dhirajbennadi/RemoteInterfacingWith8051/Report/honor code.jpeg

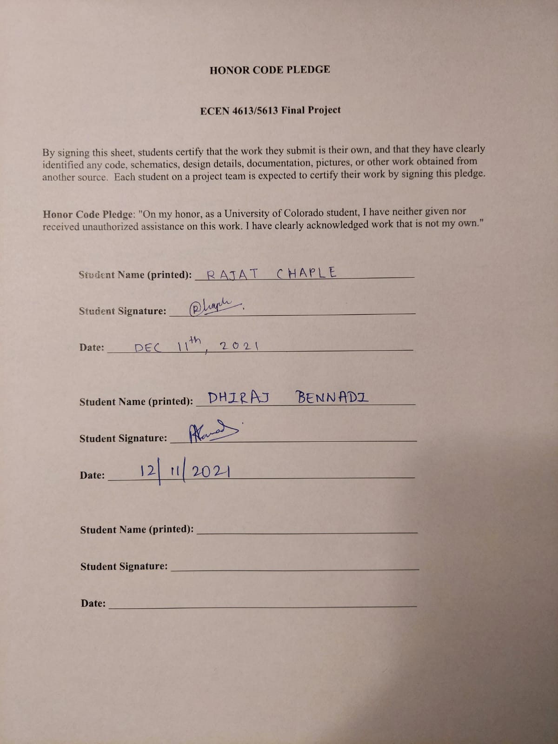
Report/honor code.jpeg
