dhirajbennadi/RemoteInterfacingWith8051/Pictures/20211206_050803.jpg

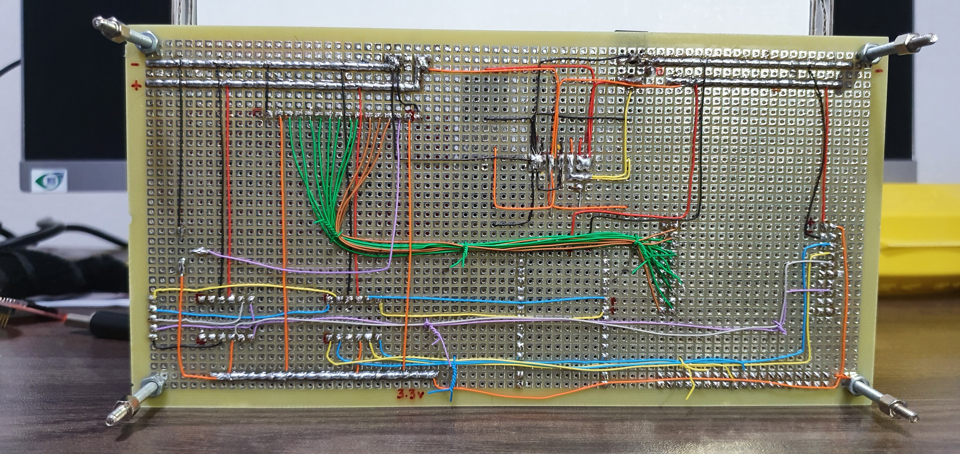
Pictures/20211206_050803.jpg
