dhirajbennadi/RemoteInterfacingWith8051/Presentations/F21_Bennadi_Chaple_Remote_Interfacing_with_8051_PDR.pptx

ESD 5613 : Final Project
(Fall 2021)
Remote Interfacing with 8051
        - Dhiraj Bennadi
        - Rajat Chaple

Notes: Introduction
Brief project description :

With current circumstances of COVID like situations, can we eliminate the need of physical access to a hardware. So one can connect to a 8051 based hardware kit remotely and perform operations like programming, memory accesses, gpio reads, etc.
In short, one can do almost all operations remotely which we have covered in labs.

## Slide 2

Block Diagram

Power Supply

8051 (uC)

UART

GPIO

Target system

Microcontroller : Tiva C launchpad with EK-TM4C123GXL

New

Memory
Backup

ESP8266

New

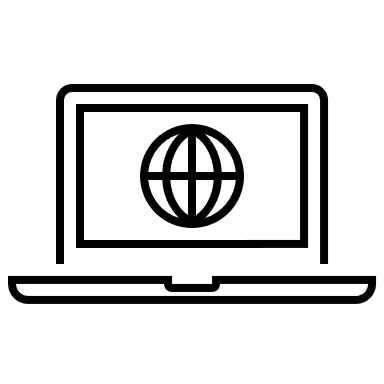
[picture p16: figure]
Internet outline

Hash key/ CRC generation

LCD Interface

SPI

New

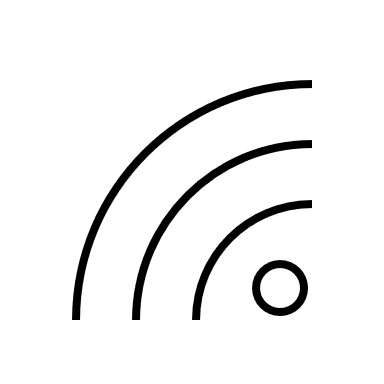
[picture p17: figure]
Wireless outline
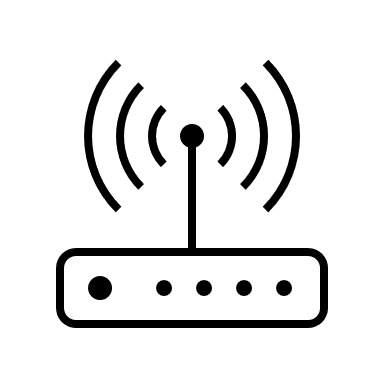
[picture p18: figure]
Wireless router outline

uController

UART

Hash check

Notes: Talk about the host
1. Utility to flash and monitor target system’s memory also monitor gpio
2. User woud have tools to compile build and generate a hex file which is then supposed to be transferred to the target system
3. For the verification of transferred hex file. Hash key wold be generated at the host end.

Target
1. Consists of 8051, Memory –(to store hex file at targets end to verify that transfer is complete (OTA update).
2. ESP8266 would be used to have communication with the host. Data would
2. Whats new (hardware)
-power supply. ESP8266 consumption
-Memory card storage
-Target uController
-ESP8266

## Slide 3

Software elements

- New elements
  - Hashing
  - SPI interface
  - Socket programming
  - GUI (optional)
- Existing elements
  - UART interface
  - GPIO

Hardware elements

New elements
Power circuit
ESP8266 (or alternative)
External memory (e.g. SD card)
PCB design and fabrication
Existing elements
8051 uController
LCD (optional)
Keypad (optional)

Notes: Software elements

## Slide 4

Key milestones

- Designing Power circuit
- PCB Layout
- Communication between ESP8266 and 8051
- Communication between Host PC to ESP8266
- Communication between ESP8266 to External memory

Notes: PCB Design and Layout is critical components as its dependent on third party supplier.
mode of communication : UART, socket comm, SPI

## Slide 5

Project deliverables

Task | Expected Due Date | Assigned to
Power Circuit design | 31st October 2021 | Rajat Chaple
Ordering of parts | 4th November | Dhiraj Bennadi
Schematic | 9th November | Both
PCB Layout | 13th November | Rajat Chaple
Interfacing UART (ESP8266 to 8051) | 14th November | Dhiraj Bennadi
Interfacing SPI (ESP8266 to Memory card) | 21st November | Both
Socket communication | 26th November | Rajat Chaple
Hashing / CRC check | 27th November | Dhiraj Bennadi
Unit Testing | 30th November | Both
System Testing | 3rd December | Both
Report | 5th December | Both

Notes: Considering time constrain we will not walk through the entire timeline
PCB Layout ready by 13th November
By 26th November our communication part would be ready. It constists of UART SPI and socket
We are focusing on impleneting Hash to verify data validation. Also, checksum would be calculated and verified at the target
We have also kept dedicated time slot for testing which would be both unit testing, functional system and Integration testing.


Can be extende to have multiple such devices powered on and users can connect and utilize one of the available boards

## Slide 6

Fall-back plan : Automated Wire spooler

Power Supply

microcontroller

UART

GPIO

Actuator
(motor &
cutter)

New

Memory
Backup

LCD Interface

New

New

NRF Device

Notes: Backup plan:
Its like automatic wire dispenser of required length
By 20th November we would have clear idea at what stage project is. PCB and ESP8266 configuration.

## Thank you…
