dhirajbennadi/RemoteInterfacingWith8051/Labs/Rajat/chaple_lab_1/lab_writeup/ESD 5613 Lab1 Submission report.pdf

## ESD 5613 Lab1 Submission

## (Rajat Chaple)

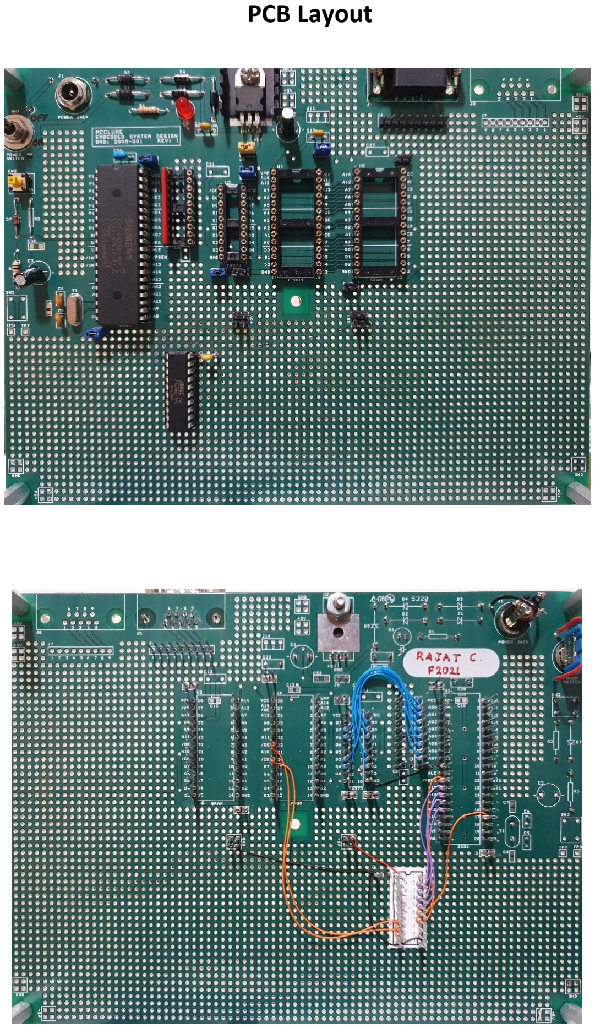
[picture p66: page 2]

PCB Layout

Part 1:

1) How many bytes of code space does your programmer require? Code size? 81 bytes____

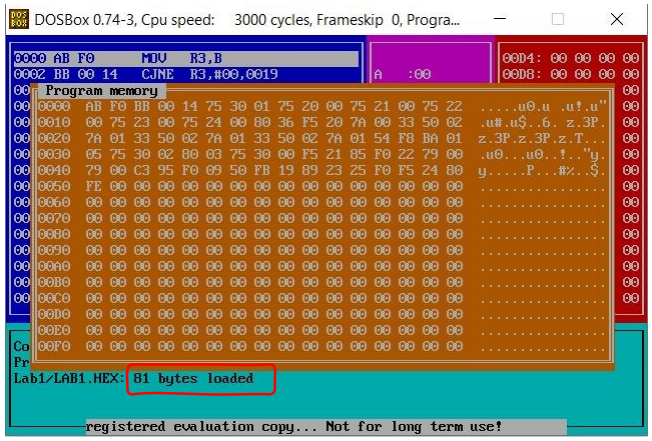
[picture p67: figure]

Another way to find out is sum up number of instruction bytes used by each instruction in a program.

2) How long did your program take to execute for X=0x10 and Y=0x0A? Assume an 11.0592 MHz clock and include the instructions executed from the beginning until you reach the ENDLOOP label. Show the TA your detailed calculations on the code listing during your signoff.

Execution Time? ______84.63 uSec________
Calculation :
Ans
= (Total oscillator cycles taken by all the instruction during execution sequence) * period 0f oscillator
= (936) * (1/11.0592) = 84.63 uSec
Calculation of 936 oscillator cycles is in lab_writeup/useful utilities/execution time.xlsx

Part 2:

Schematic is attached in schematics folder.

Part 3:

1. What voltage is present at the regulator input? Use a digital multimeter. ______7.8 V_____________

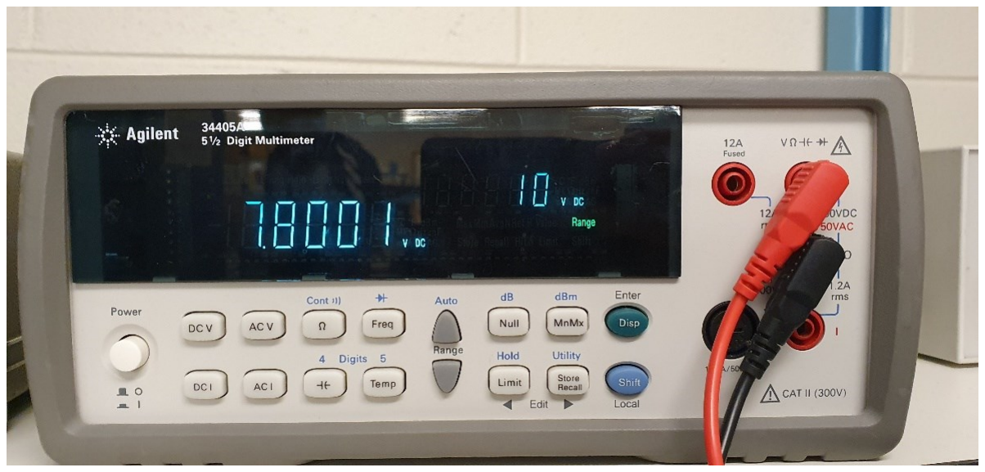
[picture p68: figure]

2. What voltage is present at the regulator output? Use a digital multimeter. ______4.99 V____________

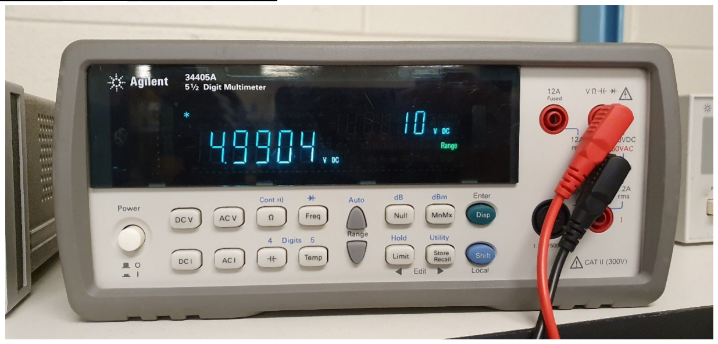
[picture p69: figure]
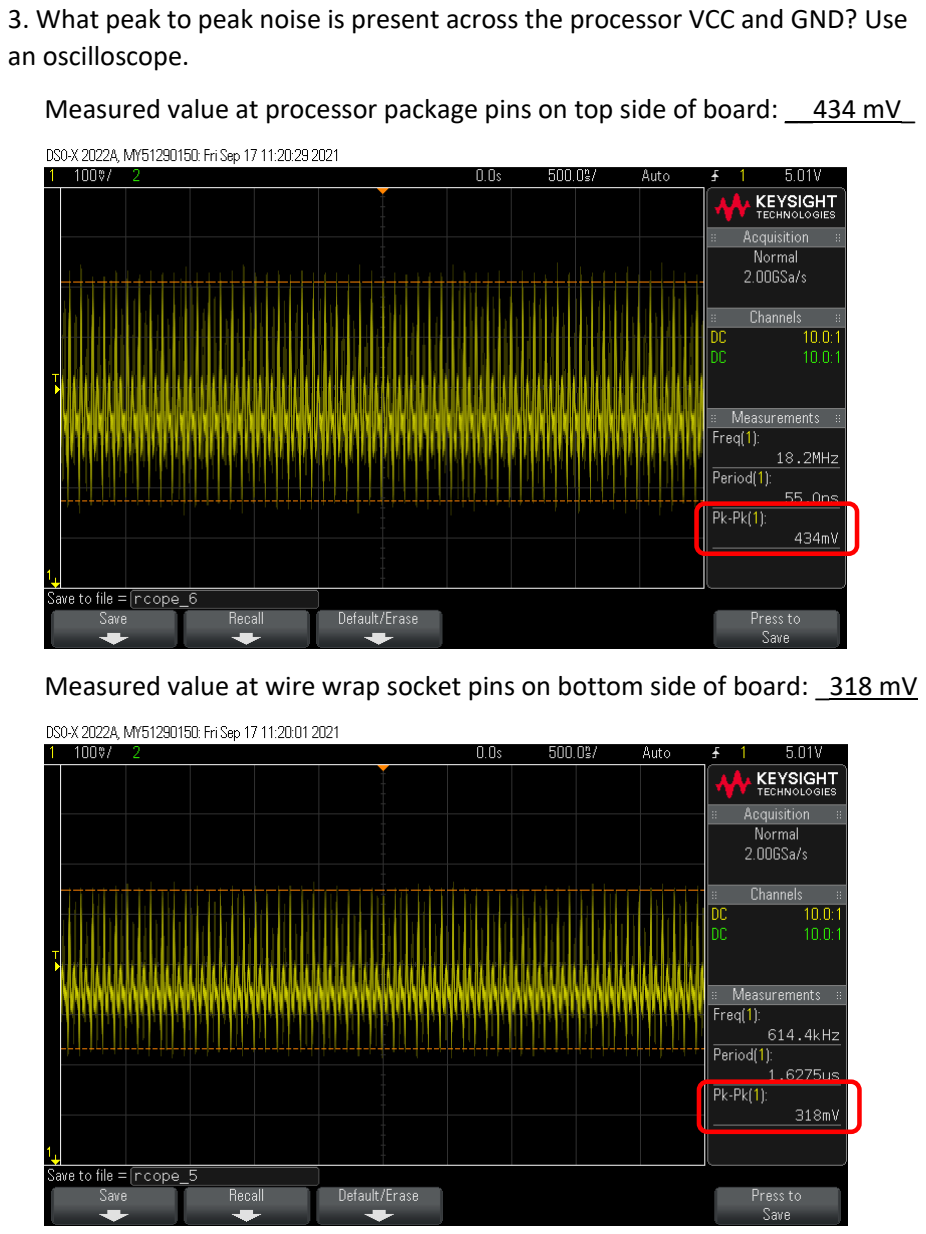
[picture p70: page 5]

3. What peak to peak noise is present across the processor VCC and GND? Use an oscilloscope.

Measured value at processor package pins on top side of board: __434 mV_

Measured value at wire wrap socket pins on bottom side of board: _318 mV

4. How long is the processor held in reset after the run-time reset pushbutton is released? Use an oscilloscope and try to measure the time between the release of the pushbutton and the time when noise from ALE is observed on the RST signal.

Measured value: ________121 mSec_____________

= 471ms – 350ms

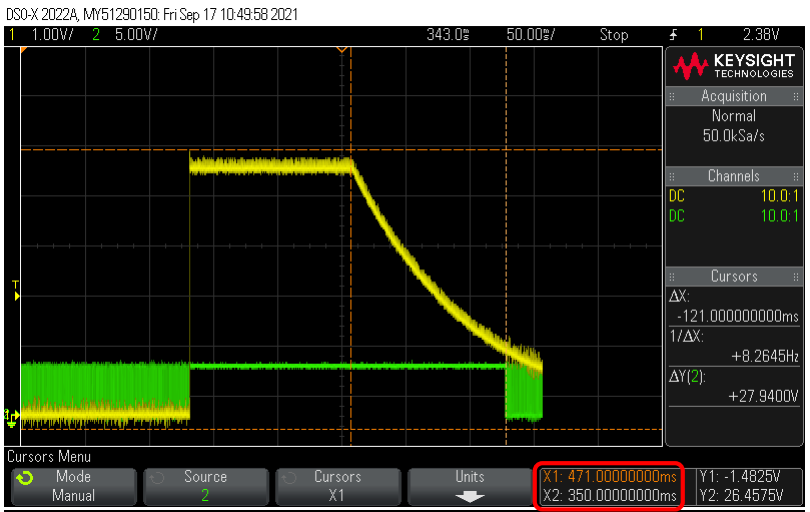
[picture p71: figure]

Submission sheet:

How much power is dissipated in the regulator, assuming a load current of 125mA? Assume that the regulator is drawing the max quiescent current shown in the data sheet (use the correct data sheet for the regulator you have on your board). Neatly show all your work.

Max quiescent current = 6mA

Power dissipated = (Vout – Vin)*(ILoad + IQ) = (7.8 – 4.99)*(0.125 * 0.006) calculated value = 368 mW

5. What frequency is present at the ALE pin? Use an oscilloscope. _________1.843 MHz____________

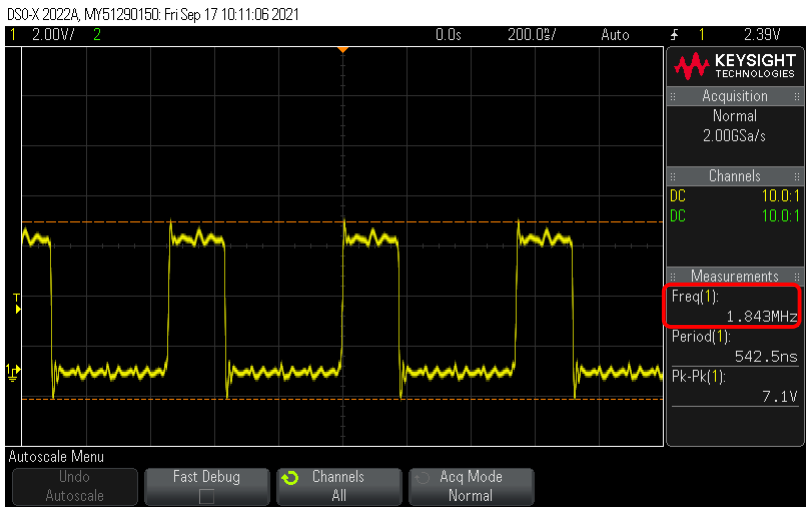
[picture p72: figure]

Learnings:

1) Designing a logic using SPLD: WinCUPL and WinSIM.
2) Using Emily52 to run assembly program.
3) Using LogicPort logic analyzer to verify SPLD logic.

/READ = /RD & /PSEN

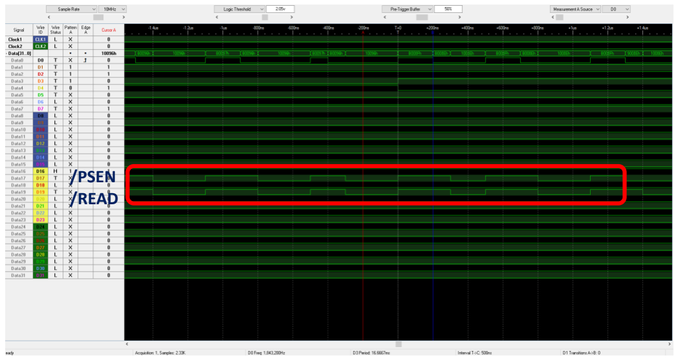
[picture p73: figure]
/PSEN /READ

/CSPERIPH = !(A15 & A14 & A13 & A12).

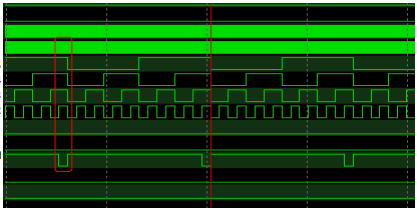
[picture p74: figure]

A15
A14
A13
A12

CSPERIPH

4) Wire wrapping technique

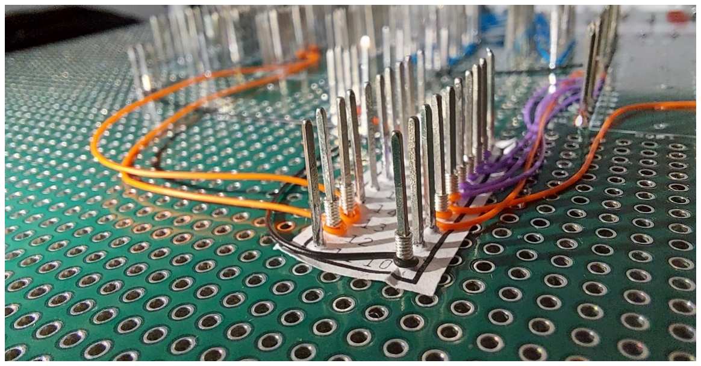
[picture p75: figure]

Note:
Supporting utilities and simulation videos are attached in lab_report folder

## Signoff / Submission sheets

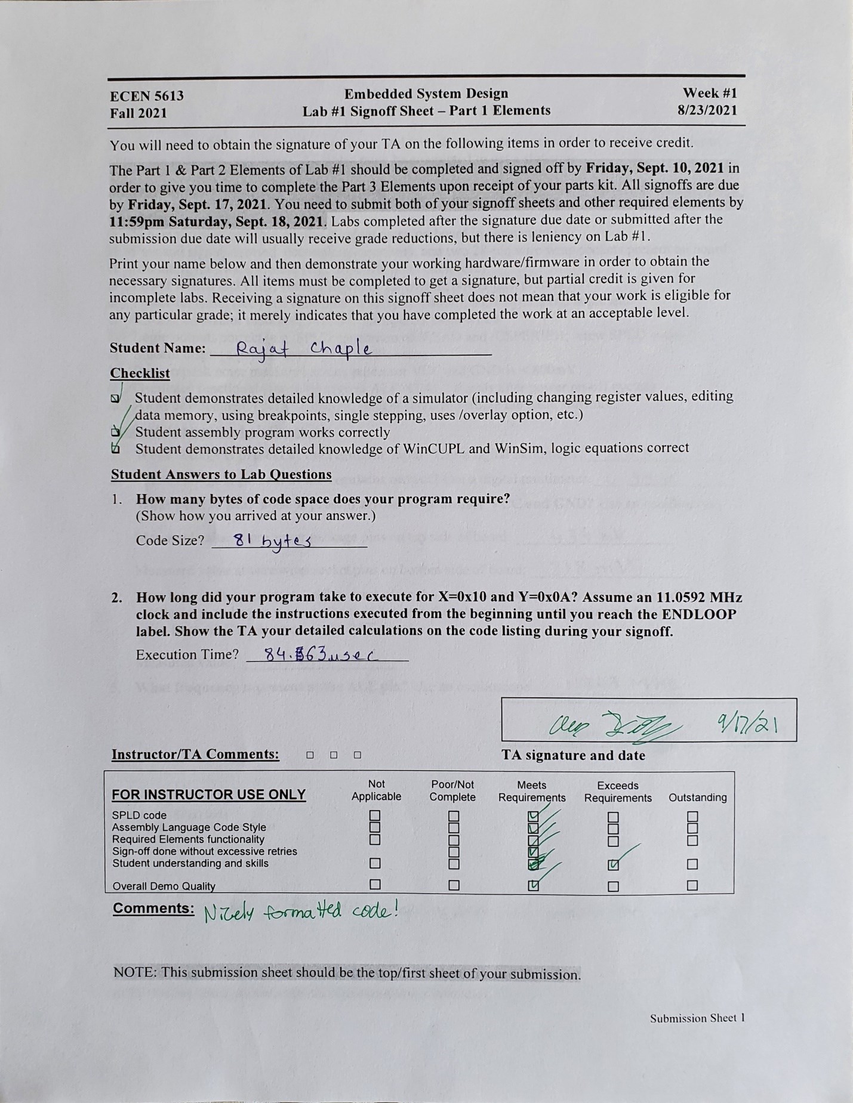
[picture p76: figure]

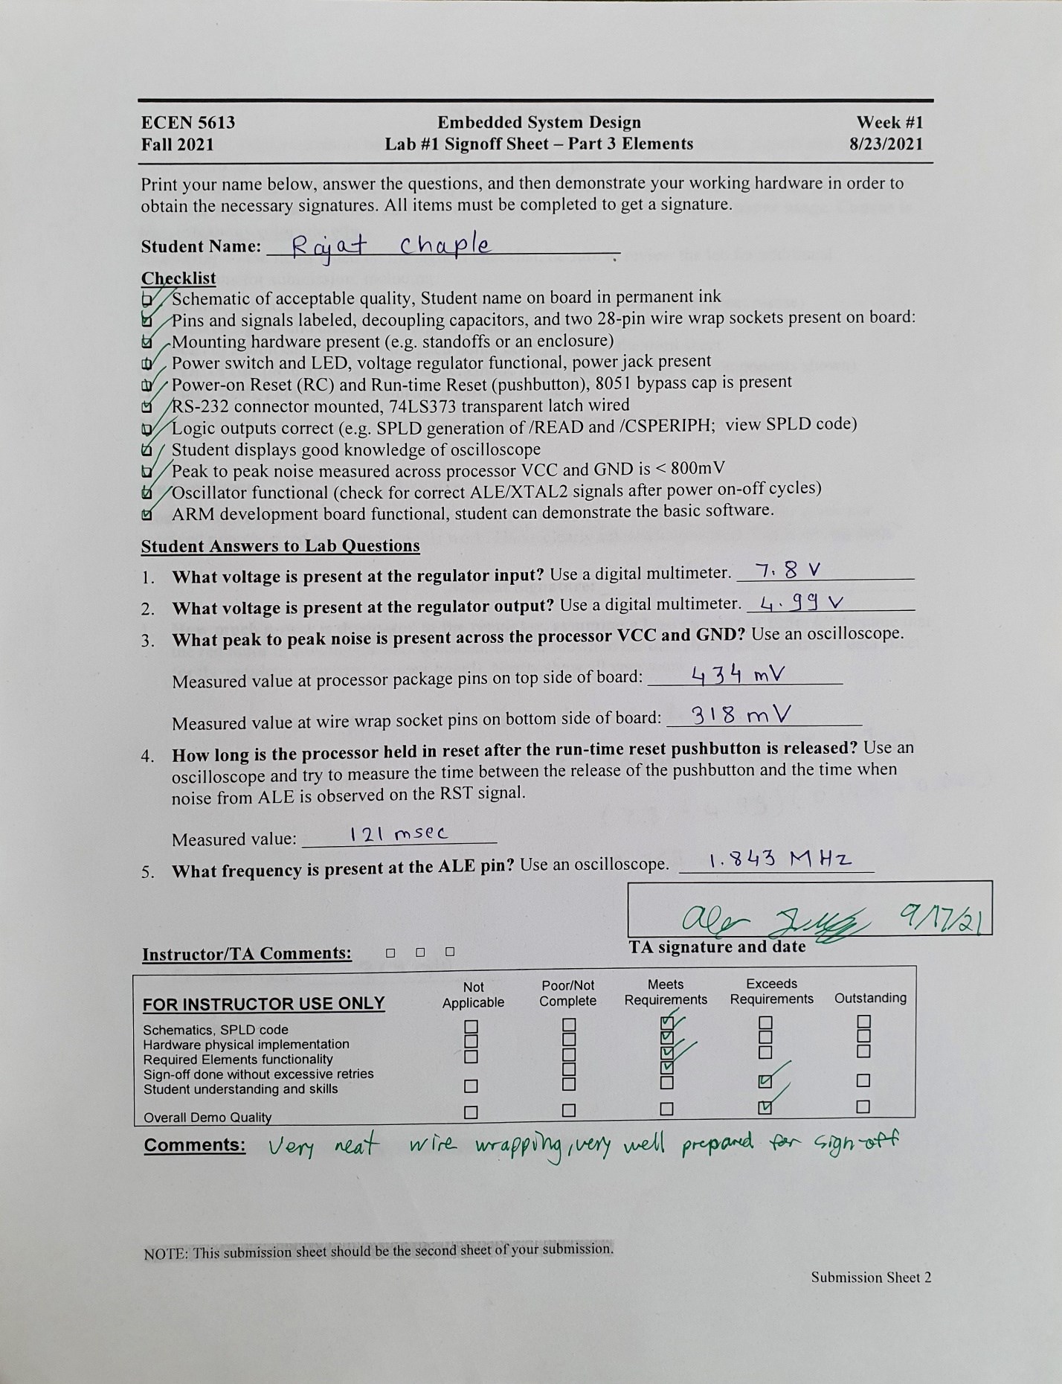
[picture p77: figure]

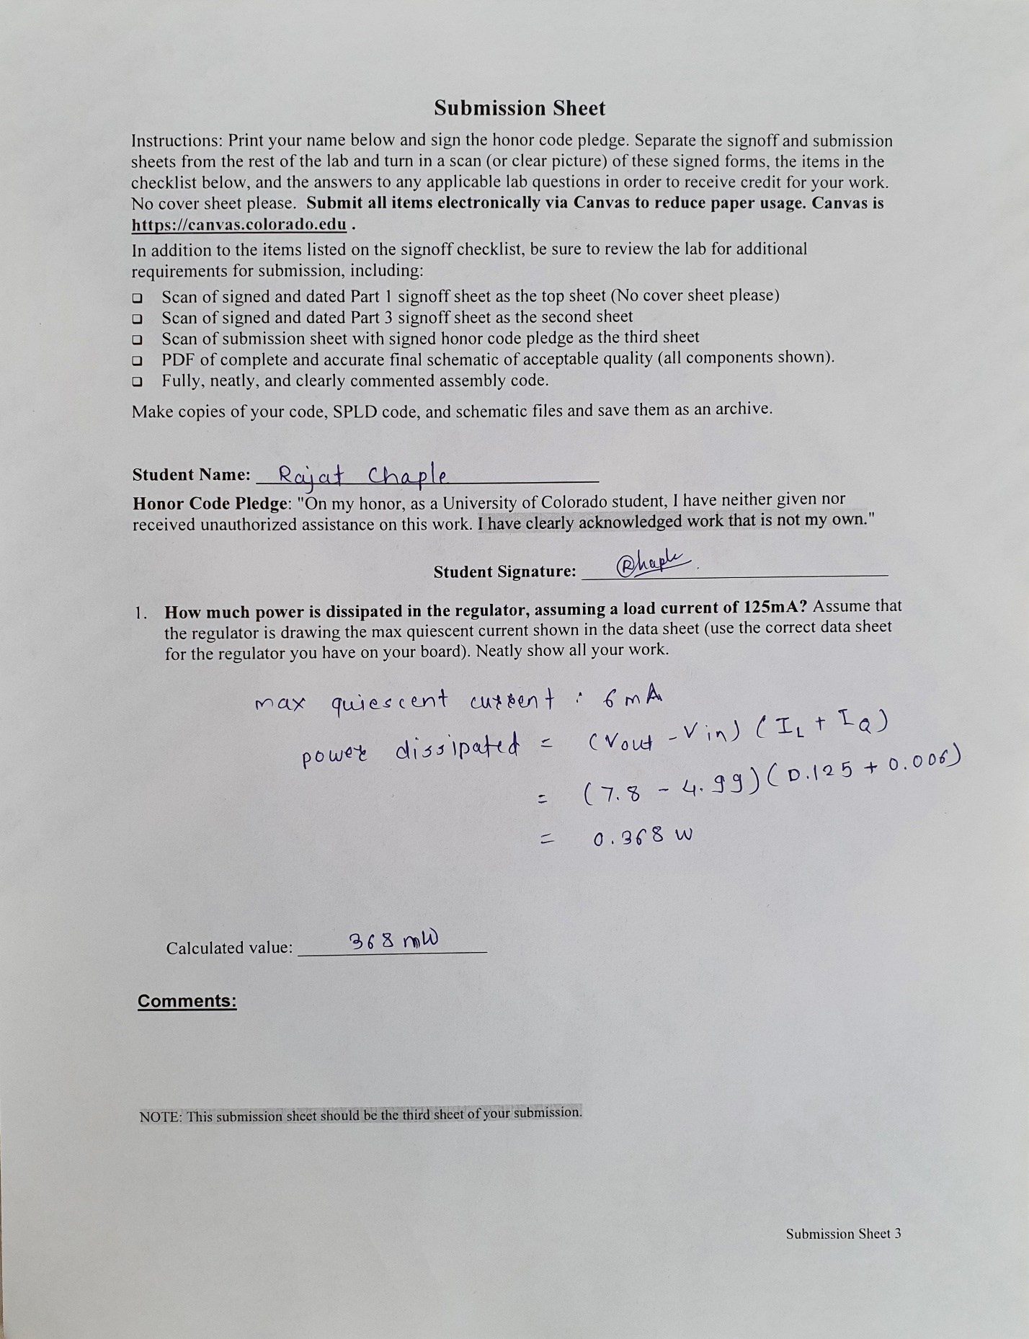
[picture p78: figure]
