dhirajbennadi/RemoteInterfacingWith8051/Labs/Rajat/chaple_lab_3/c_code_C51/esd_lab3_part3_buffers/obj/Release/uart.rst

                                      1 ;--------------------------------------------------------
                                      2 ; File Created by SDCC : free open source ANSI-C Compiler
                                      3 ; Version 3.9.0 #11195 (MINGW64)
                                      4 ;--------------------------------------------------------
                                      5 	.module uart
                                      6 	.optsdcc -mmcs51 --model-large
                                      7 	
                                      8 ;--------------------------------------------------------
                                      9 ; Public variables in this module
                                     10 ;--------------------------------------------------------
                                     11 	.globl _printf_tiny
                                     12 	.globl _printf
                                     13 	.globl _memset
                                     14 	.globl _strncat
                                     15 	.globl _strcat
                                     16 	.globl _free
                                     17 	.globl _malloc
                                     18 	.globl _atoi
                                     19 	.globl _main
                                     20 	.globl _CY
                                     21 	.globl _AC
                                     22 	.globl _F0
                                     23 	.globl _RS1
                                     24 	.globl _RS0
                                     25 	.globl _OV
                                     26 	.globl _F1
                                     27 	.globl _P
                                     28 	.globl _PS
                                     29 	.globl _PT1
                                     30 	.globl _PX1
                                     31 	.globl _PT0
                                     32 	.globl _PX0
                                     33 	.globl _RD
                                     34 	.globl _WR
                                     35 	.globl _T1
                                     36 	.globl _T0
                                     37 	.globl _INT1
                                     38 	.globl _INT0
                                     39 	.globl _TXD
                                     40 	.globl _RXD
                                     41 	.globl _P3_7
                                     42 	.globl _P3_6
                                     43 	.globl _P3_5
                                     44 	.globl _P3_4
                                     45 	.globl _P3_3
                                     46 	.globl _P3_2
                                     47 	.globl _P3_1
                                     48 	.globl _P3_0
                                     49 	.globl _EA
                                     50 	.globl _ES
                                     51 	.globl _ET1
                                     52 	.globl _EX1
                                     53 	.globl _ET0
                                     54 	.globl _EX0
                                     55 	.globl _P2_7
                                     56 	.globl _P2_6
                                     57 	.globl _P2_5
                                     58 	.globl _P2_4
                                     59 	.globl _P2_3
                                     60 	.globl _P2_2
                                     61 	.globl _P2_1
                                     62 	.globl _P2_0
                                     63 	.globl _SM0
                                     64 	.globl _SM1
                                     65 	.globl _SM2
                                     66 	.globl _REN
                                     67 	.globl _TB8
                                     68 	.globl _RB8
                                     69 	.globl _TI
                                     70 	.globl _RI
                                     71 	.globl _P1_7
                                     72 	.globl _P1_6
                                     73 	.globl _P1_5
                                     74 	.globl _P1_4
                                     75 	.globl _P1_3
                                     76 	.globl _P1_2
                                     77 	.globl _P1_1
                                     78 	.globl _P1_0
                                     79 	.globl _TF1
                                     80 	.globl _TR1
                                     81 	.globl _TF0
                                     82 	.globl _TR0
                                     83 	.globl _IE1
                                     84 	.globl _IT1
                                     85 	.globl _IE0
                                     86 	.globl _IT0
                                     87 	.globl _P0_7
                                     88 	.globl _P0_6
                                     89 	.globl _P0_5
                                     90 	.globl _P0_4
                                     91 	.globl _P0_3
                                     92 	.globl _P0_2
                                     93 	.globl _P0_1
                                     94 	.globl _P0_0
                                     95 	.globl _B
                                     96 	.globl _ACC
                                     97 	.globl _PSW
                                     98 	.globl _IP
                                     99 	.globl _P3
                                    100 	.globl _IE
                                    101 	.globl _P2
                                    102 	.globl _SBUF
                                    103 	.globl _SCON
                                    104 	.globl _P1
                                    105 	.globl _TH1
                                    106 	.globl _TH0
                                    107 	.globl _TL1
                                    108 	.globl _TL0
                                    109 	.globl _TMOD
                                    110 	.globl _TCON
                                    111 	.globl _PCON
                                    112 	.globl _DPH
                                    113 	.globl _DPL
                                    114 	.globl _SP
                                    115 	.globl _P0
                                    116 	.globl _total_malloced_data
                                    117 	.globl _buf_number
                                    118 	.globl _uint_to_hexstr_PARM_4
                                    119 	.globl _uint_to_hexstr_PARM_3
                                    120 	.globl _uint_to_hexstr_PARM_2
                                    121 	.globl _hexdump_PARM_2
                                    122 	.globl _command_PARM_2
                                    123 	.globl _uart_init
                                    124 	.globl _echo
                                    125 	.globl _command
                                    126 	.globl _putchar
                                    127 	.globl _getchar
                                    128 	.globl _putstr
                                    129 	.globl _accept_number_from_user
                                    130 	.globl _print_buffers
                                    131 	.globl _hexdump
                                    132 	.globl _uint_to_hexstr
                                    133 ;--------------------------------------------------------
                                    134 ; special function registers
                                    135 ;--------------------------------------------------------
                                    136 	.area RSEG    (ABS,DATA)
      000000                        137 	.org 0x0000
                           000080   138 _P0	=	0x0080
                           000081   139 _SP	=	0x0081
                           000082   140 _DPL	=	0x0082
                           000083   141 _DPH	=	0x0083
                           000087   142 _PCON	=	0x0087
                           000088   143 _TCON	=	0x0088
                           000089   144 _TMOD	=	0x0089
                           00008A   145 _TL0	=	0x008a
                           00008B   146 _TL1	=	0x008b
                           00008C   147 _TH0	=	0x008c
                           00008D   148 _TH1	=	0x008d
                           000090   149 _P1	=	0x0090
                           000098   150 _SCON	=	0x0098
                           000099   151 _SBUF	=	0x0099
                           0000A0   152 _P2	=	0x00a0
                           0000A8   153 _IE	=	0x00a8
                           0000B0   154 _P3	=	0x00b0
                           0000B8   155 _IP	=	0x00b8
                           0000D0   156 _PSW	=	0x00d0
                           0000E0   157 _ACC	=	0x00e0
                           0000F0   158 _B	=	0x00f0
                                    159 ;--------------------------------------------------------
                                    160 ; special function bits
                                    161 ;--------------------------------------------------------
                                    162 	.area RSEG    (ABS,DATA)
      000000                        163 	.org 0x0000
                           000080   164 _P0_0	=	0x0080
                           000081   165 _P0_1	=	0x0081
                           000082   166 _P0_2	=	0x0082
                           000083   167 _P0_3	=	0x0083
                           000084   168 _P0_4	=	0x0084
                           000085   169 _P0_5	=	0x0085
                           000086   170 _P0_6	=	0x0086
                           000087   171 _P0_7	=	0x0087
                           000088   172 _IT0	=	0x0088
                           000089   173 _IE0	=	0x0089
                           00008A   174 _IT1	=	0x008a
                           00008B   175 _IE1	=	0x008b
                           00008C   176 _TR0	=	0x008c
                           00008D   177 _TF0	=	0x008d
                           00008E   178 _TR1	=	0x008e
                           00008F   179 _TF1	=	0x008f
                           000090   180 _P1_0	=	0x0090
                           000091   181 _P1_1	=	0x0091
                           000092   182 _P1_2	=	0x0092
                           000093   183 _P1_3	=	0x0093
                           000094   184 _P1_4	=	0x0094
                           000095   185 _P1_5	=	0x0095
                           000096   186 _P1_6	=	0x0096
                           000097   187 _P1_7	=	0x0097
                           000098   188 _RI	=	0x0098
                           000099   189 _TI	=	0x0099
                           00009A   190 _RB8	=	0x009a
                           00009B   191 _TB8	=	0x009b
                           00009C   192 _REN	=	0x009c
                           00009D   193 _SM2	=	0x009d
                           00009E   194 _SM1	=	0x009e
                           00009F   195 _SM0	=	0x009f
                           0000A0   196 _P2_0	=	0x00a0
                           0000A1   197 _P2_1	=	0x00a1
                           0000A2   198 _P2_2	=	0x00a2
                           0000A3   199 _P2_3	=	0x00a3
                           0000A4   200 _P2_4	=	0x00a4
                           0000A5   201 _P2_5	=	0x00a5
                           0000A6   202 _P2_6	=	0x00a6
                           0000A7   203 _P2_7	=	0x00a7
                           0000A8   204 _EX0	=	0x00a8
                           0000A9   205 _ET0	=	0x00a9
                           0000AA   206 _EX1	=	0x00aa
                           0000AB   207 _ET1	=	0x00ab
                           0000AC   208 _ES	=	0x00ac
                           0000AF   209 _EA	=	0x00af
                           0000B0   210 _P3_0	=	0x00b0
                           0000B1   211 _P3_1	=	0x00b1
                           0000B2   212 _P3_2	=	0x00b2
                           0000B3   213 _P3_3	=	0x00b3
                           0000B4   214 _P3_4	=	0x00b4
                           0000B5   215 _P3_5	=	0x00b5
                           0000B6   216 _P3_6	=	0x00b6
                           0000B7   217 _P3_7	=	0x00b7
                           0000B0   218 _RXD	=	0x00b0
                           0000B1   219 _TXD	=	0x00b1
                           0000B2   220 _INT0	=	0x00b2
                           0000B3   221 _INT1	=	0x00b3
                           0000B4   222 _T0	=	0x00b4
                           0000B5   223 _T1	=	0x00b5
                           0000B6   224 _WR	=	0x00b6
                           0000B7   225 _RD	=	0x00b7
                           0000B8   226 _PX0	=	0x00b8
                           0000B9   227 _PT0	=	0x00b9
                           0000BA   228 _PX1	=	0x00ba
                           0000BB   229 _PT1	=	0x00bb
                           0000BC   230 _PS	=	0x00bc
                           0000D0   231 _P	=	0x00d0
                           0000D1   232 _F1	=	0x00d1
                           0000D2   233 _OV	=	0x00d2
                           0000D3   234 _RS0	=	0x00d3
                           0000D4   235 _RS1	=	0x00d4
                           0000D5   236 _F0	=	0x00d5
                           0000D6   237 _AC	=	0x00d6
                           0000D7   238 _CY	=	0x00d7
                                    239 ;--------------------------------------------------------
                                    240 ; overlayable register banks
                                    241 ;--------------------------------------------------------
                                    242 	.area REG_BANK_0	(REL,OVR,DATA)
      000000                        243 	.ds 8
                                    244 ;--------------------------------------------------------
                                    245 ; internal ram data
                                    246 ;--------------------------------------------------------
                                    247 	.area DSEG    (DATA)
      000008                        248 _command_sloc0_1_0:
      000008                        249 	.ds 3
      00000B                        250 _command_sloc1_1_0:
      00000B                        251 	.ds 3
      00000E                        252 _command_sloc2_1_0:
      00000E                        253 	.ds 2
      000010                        254 _command_sloc3_1_0:
      000010                        255 	.ds 2
      000012                        256 _command_sloc4_1_0:
      000012                        257 	.ds 3
      000015                        258 _print_buffers_sloc0_1_0:
      000015                        259 	.ds 3
      000018                        260 _hexdump_sloc0_1_0:
      000018                        261 	.ds 2
      00001A                        262 _hexdump_sloc1_1_0:
      00001A                        263 	.ds 2
      00001C                        264 _uint_to_hexstr_sloc0_1_0:
      00001C                        265 	.ds 4
      000020                        266 _uint_to_hexstr_sloc1_1_0:
      000020                        267 	.ds 2
      000022                        268 _uint_to_hexstr_sloc2_1_0:
      000022                        269 	.ds 3
      000025                        270 _uint_to_hexstr_sloc3_1_0:
      000025                        271 	.ds 2
                                    272 ;--------------------------------------------------------
                                    273 ; overlayable items in internal ram 
                                    274 ;--------------------------------------------------------
                                    275 ;--------------------------------------------------------
                                    276 ; indirectly addressable internal ram data
                                    277 ;--------------------------------------------------------
                                    278 	.area ISEG    (DATA)
                                    279 ;--------------------------------------------------------
                                    280 ; absolute internal ram data
                                    281 ;--------------------------------------------------------
                                    282 	.area IABS    (ABS,DATA)
                                    283 	.area IABS    (ABS,DATA)
                                    284 ;--------------------------------------------------------
                                    285 ; bit data
                                    286 ;--------------------------------------------------------
                                    287 	.area BSEG    (BIT)
                                    288 ;--------------------------------------------------------
                                    289 ; paged external ram data
                                    290 ;--------------------------------------------------------
                                    291 	.area PSEG    (PAG,XDATA)
                                    292 ;--------------------------------------------------------
                                    293 ; external ram data
                                    294 ;--------------------------------------------------------
                                    295 	.area XSEG    (XDATA)
      001AF6                        296 _echo_c_65536_74:
      001AF6                        297 	.ds 1
      001AF7                        298 _command_PARM_2:
      001AF7                        299 	.ds 3
      001AFA                        300 _command_received_char_65536_77:
      001AFA                        301 	.ds 1
      001AFB                        302 _command_new_buff_id_65536_78:
      001AFB                        303 	.ds 2
      001AFD                        304 _putchar_c_65536_105:
      001AFD                        305 	.ds 2
      001AFF                        306 _putstr_str_65536_108:
      001AFF                        307 	.ds 3
      001B02                        308 _accept_number_from_user_received_char_65536_111:
      001B02                        309 	.ds 1
      001B03                        310 _accept_number_from_user_number_in_char_65536_111:
      001B03                        311 	.ds 25
      001B1C                        312 _accept_number_from_user_valid_number_status_65536_111:
      001B1C                        313 	.ds 1
      001B1D                        314 _accept_number_from_user_number_65536_111:
      001B1D                        315 	.ds 2
      001B1F                        316 _accept_number_from_user_i_65536_111:
      001B1F                        317 	.ds 2
      001B21                        318 _print_buffers_buffers_65536_116:
      001B21                        319 	.ds 3
      001B24                        320 _hexdump_PARM_2:
      001B24                        321 	.ds 4
      001B28                        322 _hexdump_loc_65536_120:
      001B28                        323 	.ds 3
      001B2B                        324 _hexdump_hex_byte_65536_121:
      001B2B                        325 	.ds 5
      001B30                        326 _hexdump_address_bytes_65536_121:
      001B30                        327 	.ds 7
      001B37                        328 _uint_to_hexstr_PARM_2:
      001B37                        329 	.ds 4
      001B3B                        330 _uint_to_hexstr_PARM_3:
      001B3B                        331 	.ds 2
      001B3D                        332 _uint_to_hexstr_PARM_4:
      001B3D                        333 	.ds 1
      001B3E                        334 _uint_to_hexstr_str_65536_128:
      001B3E                        335 	.ds 3
                                    336 ;--------------------------------------------------------
                                    337 ; absolute external ram data
                                    338 ;--------------------------------------------------------
                                    339 	.area XABS    (ABS,XDATA)
                                    340 ;--------------------------------------------------------
                                    341 ; external initialized ram data
                                    342 ;--------------------------------------------------------
                                    343 	.area XISEG   (XDATA)
      001BBA                        344 _buf_number::
      001BBA                        345 	.ds 2
      001BBC                        346 _total_malloced_data::
      001BBC                        347 	.ds 2
                                    348 	.area HOME    (CODE)
                                    349 	.area GSINIT0 (CODE)
                                    350 	.area GSINIT1 (CODE)
                                    351 	.area GSINIT2 (CODE)
                                    352 	.area GSINIT3 (CODE)
                                    353 	.area GSINIT4 (CODE)
                                    354 	.area GSINIT5 (CODE)
                                    355 	.area GSINIT  (CODE)
                                    356 	.area GSFINAL (CODE)
                                    357 	.area CSEG    (CODE)
                                    358 ;--------------------------------------------------------
                                    359 ; global & static initialisations
                                    360 ;--------------------------------------------------------
                                    361 	.area HOME    (CODE)
                                    362 	.area GSINIT  (CODE)
                                    363 	.area GSFINAL (CODE)
                                    364 	.area GSINIT  (CODE)
                                    365 ;--------------------------------------------------------
                                    366 ; Home
                                    367 ;--------------------------------------------------------
                                    368 	.area HOME    (CODE)
                                    369 	.area HOME    (CODE)
                                    370 ;--------------------------------------------------------
                                    371 ; code
                                    372 ;--------------------------------------------------------
                                    373 	.area CSEG    (CODE)
                                    374 ;------------------------------------------------------------
                                    375 ;Allocation info for local variables in function 'uart_init'
                                    376 ;------------------------------------------------------------
                                    377 ;	uart.c:48: void uart_init()
                                    378 ;	-----------------------------------------
                                    379 ;	 function uart_init
                                    380 ;	-----------------------------------------
      0023CC                        381 _uart_init:
                           000007   382 	ar7 = 0x07
                           000006   383 	ar6 = 0x06
                           000005   384 	ar5 = 0x05
                           000004   385 	ar4 = 0x04
                           000003   386 	ar3 = 0x03
                           000002   387 	ar2 = 0x02
                           000001   388 	ar1 = 0x01
                           000000   389 	ar0 = 0x00
                                    390 ;	uart.c:50: SCON = 0x50; // setting up serial configuration 8bit uart, Receive enabled
      0023CC 75 98 50         [24]  391 	mov	_SCON,#0x50
                                    392 ;	uart.c:51: TMOD = 0x20; // timer1 in mode2, auto-reload
      0023CF 75 89 20         [24]  393 	mov	_TMOD,#0x20
                                    394 ;	uart.c:56: TI = 1;
                                    395 ;	assignBit
      0023D2 D2 99            [12]  396 	setb	_TI
                                    397 ;	uart.c:57: P1_1 = false;
                                    398 ;	assignBit
      0023D4 C2 91            [12]  399 	clr	_P1_1
                                    400 ;	uart.c:58: }
      0023D6 22               [24]  401 	ret
                                    402 ;------------------------------------------------------------
                                    403 ;Allocation info for local variables in function 'echo'
                                    404 ;------------------------------------------------------------
                                    405 ;c                         Allocated with name '_echo_c_65536_74'
                                    406 ;------------------------------------------------------------
                                    407 ;	uart.c:64: void echo(char c)
                                    408 ;	-----------------------------------------
                                    409 ;	 function echo
                                    410 ;	-----------------------------------------
      0023D7                        411 _echo:
      0023D7 E5 82            [12]  412 	mov	a,dpl
      0023D9 90 1A F6         [24]  413 	mov	dptr,#_echo_c_65536_74
      0023DC F0               [24]  414 	movx	@dptr,a
                                    415 ;	uart.c:68: switch ((int8_t)c)
      0023DD E0               [24]  416 	movx	a,@dptr
      0023DE FF               [12]  417 	mov	r7,a
      0023DF FE               [12]  418 	mov	r6,a
      0023E0 BE FF 01         [24]  419 	cjne	r6,#0xff,00120$
      0023E3 22               [24]  420 	ret
      0023E4                        421 00120$:
      0023E4 BE 08 02         [24]  422 	cjne	r6,#0x08,00121$
      0023E7 80 05            [24]  423 	sjmp	00102$
      0023E9                        424 00121$:
                                    425 ;	uart.c:73: case BACKSPACE: // user presses backspace
      0023E9 BE 0D 20         [24]  426 	cjne	r6,#0x0d,00104$
      0023EC 80 12            [24]  427 	sjmp	00103$
      0023EE                        428 00102$:
                                    429 ;	uart.c:74: putchar(BACKSPACE);
      0023EE 90 00 08         [24]  430 	mov	dptr,#0x0008
      0023F1 12 2E 0C         [24]  431 	lcall	_putchar
                                    432 ;	uart.c:75: putchar(' ');
      0023F4 90 00 20         [24]  433 	mov	dptr,#0x0020
      0023F7 12 2E 0C         [24]  434 	lcall	_putchar
                                    435 ;	uart.c:76: putchar(BACKSPACE);
      0023FA 90 00 08         [24]  436 	mov	dptr,#0x0008
                                    437 ;	uart.c:77: break;
                                    438 ;	uart.c:79: case '\r': // user presses enter
      0023FD 02 2E 0C         [24]  439 	ljmp	_putchar
      002400                        440 00103$:
                                    441 ;	uart.c:80: putchar('\r');
      002400 90 00 0D         [24]  442 	mov	dptr,#0x000d
      002403 12 2E 0C         [24]  443 	lcall	_putchar
                                    444 ;	uart.c:81: putchar('\n');
      002406 90 00 0A         [24]  445 	mov	dptr,#0x000a
                                    446 ;	uart.c:82: break;
                                    447 ;	uart.c:84: default:
      002409 02 2E 0C         [24]  448 	ljmp	_putchar
      00240C                        449 00104$:
                                    450 ;	uart.c:85: putchar(c); // echoing received chars
      00240C 7E 00            [12]  451 	mov	r6,#0x00
      00240E 8F 82            [24]  452 	mov	dpl,r7
      002410 8E 83            [24]  453 	mov	dph,r6
                                    454 ;	uart.c:87: }
                                    455 ;	uart.c:88: }
      002412 02 2E 0C         [24]  456 	ljmp	_putchar
                                    457 ;------------------------------------------------------------
                                    458 ;Allocation info for local variables in function 'command'
                                    459 ;------------------------------------------------------------
                                    460 ;sloc0                     Allocated with name '_command_sloc0_1_0'
                                    461 ;sloc1                     Allocated with name '_command_sloc1_1_0'
                                    462 ;sloc2                     Allocated with name '_command_sloc2_1_0'
                                    463 ;sloc3                     Allocated with name '_command_sloc3_1_0'
                                    464 ;sloc4                     Allocated with name '_command_sloc4_1_0'
                                    465 ;buffers                   Allocated with name '_command_PARM_2'
                                    466 ;received_char             Allocated with name '_command_received_char_65536_77'
                                    467 ;new_buff_size             Allocated with name '_command_new_buff_size_65536_78'
                                    468 ;buffer_to_be_deleted      Allocated with name '_command_buffer_to_be_deleted_65536_78'
                                    469 ;new_buff_id               Allocated with name '_command_new_buff_id_65536_78'
                                    470 ;iBuffer                   Allocated with name '_command_iBuffer_196608_80'
                                    471 ;i                         Allocated with name '_command_i_262144_85'
                                    472 ;i                         Allocated with name '_command_i_327680_92'
                                    473 ;i                         Allocated with name '_command_i_196608_95'
                                    474 ;i                         Allocated with name '_command_i_196608_98'
                                    475 ;iBuffer0                  Allocated with name '_command_iBuffer0_196608_101'
                                    476 ;iBuffer                   Allocated with name '_command_iBuffer_196608_103'
                                    477 ;------------------------------------------------------------
                                    478 ;	uart.c:94: void command(char received_char, buffer_t *buffers)
                                    479 ;	-----------------------------------------
                                    480 ;	 function command
                                    481 ;	-----------------------------------------
      002415                        482 _command:
      002415 E5 82            [12]  483 	mov	a,dpl
      002417 90 1A FA         [24]  484 	mov	dptr,#_command_received_char_65536_77
      00241A F0               [24]  485 	movx	@dptr,a
                                    486 ;	uart.c:98: uint16_t new_buff_id = 0;
      00241B 90 1A FB         [24]  487 	mov	dptr,#_command_new_buff_id_65536_78
      00241E E4               [12]  488 	clr	a
      00241F F0               [24]  489 	movx	@dptr,a
      002420 A3               [24]  490 	inc	dptr
      002421 F0               [24]  491 	movx	@dptr,a
                                    492 ;	uart.c:100: if ((received_char >= 'a') && (received_char <= 'z')) // since small letter characters are storage characters and not command characters
      002422 90 1A FA         [24]  493 	mov	dptr,#_command_received_char_65536_77
      002425 E0               [24]  494 	movx	a,@dptr
      002426 FF               [12]  495 	mov	r7,a
      002427 BF 61 00         [24]  496 	cjne	r7,#0x61,00313$
      00242A                        497 00313$:
      00242A 40 06            [24]  498 	jc	00102$
      00242C EF               [12]  499 	mov	a,r7
      00242D 24 85            [12]  500 	add	a,#0xff - 0x7a
      00242F 40 01            [24]  501 	jc	00102$
                                    502 ;	uart.c:101: return;
      002431 22               [24]  503 	ret
      002432                        504 00102$:
                                    505 ;	uart.c:103: switch (received_char)
      002432 90 1A FA         [24]  506 	mov	dptr,#_command_received_char_65536_77
      002435 E0               [24]  507 	movx	a,@dptr
      002436 FF               [12]  508 	mov	r7,a
      002437 BF 2B 02         [24]  509 	cjne	r7,#0x2b,00316$
      00243A 80 1B            [24]  510 	sjmp	00104$
      00243C                        511 00316$:
      00243C BF 2D 03         [24]  512 	cjne	r7,#0x2d,00317$
      00243F 02 28 58         [24]  513 	ljmp	00128$
      002442                        514 00317$:
      002442 BF 3D 03         [24]  515 	cjne	r7,#0x3d,00318$
      002445 02 2C A9         [24]  516 	ljmp	00141$
      002448                        517 00318$:
      002448 BF 3F 03         [24]  518 	cjne	r7,#0x3f,00319$
      00244B 02 29 AD         [24]  519 	ljmp	00132$
      00244E                        520 00319$:
      00244E BF 40 03         [24]  521 	cjne	r7,#0x40,00320$
      002451 02 2D 03         [24]  522 	ljmp	00142$
      002454                        523 00320$:
      002454 02 2D DF         [24]  524 	ljmp	00146$
                                    525 ;	uart.c:107: case '+':
      002457                        526 00104$:
                                    527 ;	uart.c:108: total_malloced_data = 0;
      002457 90 1B BC         [24]  528 	mov	dptr,#_total_malloced_data
      00245A E4               [12]  529 	clr	a
      00245B F0               [24]  530 	movx	@dptr,a
      00245C A3               [24]  531 	inc	dptr
      00245D F0               [24]  532 	movx	@dptr,a
                                    533 ;	uart.c:109: for(int iBuffer = 0; iBuffer < MAX_NUM_OF_BUFFERS; iBuffer++)
      00245E 90 1A F7         [24]  534 	mov	dptr,#_command_PARM_2
      002461 E0               [24]  535 	movx	a,@dptr
      002462 F5 08            [12]  536 	mov	_command_sloc0_1_0,a
      002464 A3               [24]  537 	inc	dptr
      002465 E0               [24]  538 	movx	a,@dptr
      002466 F5 09            [12]  539 	mov	(_command_sloc0_1_0 + 1),a
      002468 A3               [24]  540 	inc	dptr
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
      002DCB 75 F0 80         [24] 1956 	mov	b,#0x80
      002DCE 12 2E 3D         [24] 1957 	lcall	_putstr
                                   1958 ;	uart.c:252: putstr("\r\n----------------------------------------------------------------------\r\n\r\n");
      002DD1 90 50 A7         [24] 1959 	mov	dptr,#___str_28
      002DD4 75 F0 80         [24] 1960 	mov	b,#0x80
      002DD7 12 2E 3D         [24] 1961 	lcall	_putstr
                                   1962 ;	uart.c:253: main();
      002DDA 12 20 AF         [24] 1963 	lcall	_main
                                   1964 ;	uart.c:254: break;
                                   1965 ;	uart.c:257: default:
      002DDD 80 1B            [24] 1966 	sjmp	00147$
      002DDF                       1967 00146$:
                                   1968 ;	uart.c:258: printf("\r\n\r\n\t Error: Received invalid command '%c'\r\n", received_char);
      002DDF 7E 00            [12] 1969 	mov	r6,#0x00
      002DE1 C0 07            [24] 1970 	push	ar7
      002DE3 C0 06            [24] 1971 	push	ar6
      002DE5 74 F4            [12] 1972 	mov	a,#___str_29
      002DE7 C0 E0            [24] 1973 	push	acc
      002DE9 74 50            [12] 1974 	mov	a,#(___str_29 >> 8)
      002DEB C0 E0            [24] 1975 	push	acc
      002DED 74 80            [12] 1976 	mov	a,#0x80
      002DEF C0 E0            [24] 1977 	push	acc
      002DF1 12 3F D4         [24] 1978 	lcall	_printf
      002DF4 E5 81            [12] 1979 	mov	a,sp
      002DF6 24 FB            [12] 1980 	add	a,#0xfb
      002DF8 F5 81            [12] 1981 	mov	sp,a
                                   1982 ;	uart.c:262: }
      002DFA                       1983 00147$:
                                   1984 ;	uart.c:264: putstr("\r\n----------------------------------------------------------------------\r\n\r\n");
      002DFA 90 50 A7         [24] 1985 	mov	dptr,#___str_28
      002DFD 75 F0 80         [24] 1986 	mov	b,#0x80
      002E00 12 2E 3D         [24] 1987 	lcall	_putstr
                                   1988 ;	uart.c:265: putstr("Enter command (+, -, ?, =, @) or input: ");
      002E03 90 51 21         [24] 1989 	mov	dptr,#___str_30
      002E06 75 F0 80         [24] 1990 	mov	b,#0x80
                                   1991 ;	uart.c:267: }
      002E09 02 2E 3D         [24] 1992 	ljmp	_putstr
                                   1993 ;------------------------------------------------------------
                                   1994 ;Allocation info for local variables in function 'putchar'
                                   1995 ;------------------------------------------------------------
                                   1996 ;c                         Allocated with name '_putchar_c_65536_105'
                                   1997 ;------------------------------------------------------------
                                   1998 ;	uart.c:272: int putchar(int c)
                                   1999 ;	-----------------------------------------
                                   2000 ;	 function putchar
                                   2001 ;	-----------------------------------------
      002E0C                       2002 _putchar:
      002E0C AF 83            [24] 2003 	mov	r7,dph
      002E0E E5 82            [12] 2004 	mov	a,dpl
      002E10 90 1A FD         [24] 2005 	mov	dptr,#_putchar_c_65536_105
      002E13 F0               [24] 2006 	movx	@dptr,a
      002E14 EF               [12] 2007 	mov	a,r7
      002E15 A3               [24] 2008 	inc	dptr
      002E16 F0               [24] 2009 	movx	@dptr,a
                                   2010 ;	uart.c:274: while (!TI)
      002E17                       2011 00101$:
                                   2012 ;	uart.c:276: TI = 0;
                                   2013 ;	assignBit
      002E17 10 99 02         [24] 2014 	jbc	_TI,00114$
      002E1A 80 FB            [24] 2015 	sjmp	00101$
      002E1C                       2016 00114$:
                                   2017 ;	uart.c:277: SBUF = c; // adding character to Serial buffer
      002E1C 90 1A FD         [24] 2018 	mov	dptr,#_putchar_c_65536_105
      002E1F E0               [24] 2019 	movx	a,@dptr
      002E20 FE               [12] 2020 	mov	r6,a
      002E21 A3               [24] 2021 	inc	dptr
      002E22 E0               [24] 2022 	movx	a,@dptr
      002E23 FF               [12] 2023 	mov	r7,a
      002E24 8E 99            [24] 2024 	mov	_SBUF,r6
                                   2025 ;	uart.c:278: return c;
      002E26 8E 82            [24] 2026 	mov	dpl,r6
      002E28 8F 83            [24] 2027 	mov	dph,r7
                                   2028 ;	uart.c:279: }
      002E2A 22               [24] 2029 	ret
                                   2030 ;------------------------------------------------------------
                                   2031 ;Allocation info for local variables in function 'getchar'
                                   2032 ;------------------------------------------------------------
                                   2033 ;	uart.c:288: int getchar() // Function to receive serial data
                                   2034 ;	-----------------------------------------
                                   2035 ;	 function getchar
                                   2036 ;	-----------------------------------------
      002E2B                       2037 _getchar:
                                   2038 ;	uart.c:290: P1_1 = false;
                                   2039 ;	assignBit
      002E2B C2 91            [12] 2040 	clr	_P1_1
                                   2041 ;	uart.c:291: while (!RI)
      002E2D                       2042 00101$:
                                   2043 ;	uart.c:294: RI = 0;
                                   2044 ;	assignBit
      002E2D 10 98 02         [24] 2045 	jbc	_RI,00114$
      002E30 80 FB            [24] 2046 	sjmp	00101$
      002E32                       2047 00114$:
                                   2048 ;	uart.c:296: P1_1 = true;
                                   2049 ;	assignBit
      002E32 D2 91            [12] 2050 	setb	_P1_1
                                   2051 ;	uart.c:297: return SBUF;
      002E34 AE 99            [24] 2052 	mov	r6,_SBUF
      002E36 7F 00            [12] 2053 	mov	r7,#0x00
      002E38 8E 82            [24] 2054 	mov	dpl,r6
      002E3A 8F 83            [24] 2055 	mov	dph,r7
                                   2056 ;	uart.c:298: }
      002E3C 22               [24] 2057 	ret
                                   2058 ;------------------------------------------------------------
                                   2059 ;Allocation info for local variables in function 'putstr'
                                   2060 ;------------------------------------------------------------
                                   2061 ;str                       Allocated with name '_putstr_str_65536_108'
                                   2062 ;index                     Allocated with name '_putstr_index_65536_109'
                                   2063 ;------------------------------------------------------------
                                   2064 ;	uart.c:304: int putstr(char *str)
                                   2065 ;	-----------------------------------------
                                   2066 ;	 function putstr
                                   2067 ;	-----------------------------------------
      002E3D                       2068 _putstr:
      002E3D AF F0            [24] 2069 	mov	r7,b
      002E3F AE 83            [24] 2070 	mov	r6,dph
      002E41 E5 82            [12] 2071 	mov	a,dpl
      002E43 90 1A FF         [24] 2072 	mov	dptr,#_putstr_str_65536_108
      002E46 F0               [24] 2073 	movx	@dptr,a
      002E47 EE               [12] 2074 	mov	a,r6
      002E48 A3               [24] 2075 	inc	dptr
      002E49 F0               [24] 2076 	movx	@dptr,a
      002E4A EF               [12] 2077 	mov	a,r7
      002E4B A3               [24] 2078 	inc	dptr
      002E4C F0               [24] 2079 	movx	@dptr,a
                                   2080 ;	uart.c:307: while (*str)
      002E4D 90 1A FF         [24] 2081 	mov	dptr,#_putstr_str_65536_108
      002E50 E0               [24] 2082 	movx	a,@dptr
      002E51 FD               [12] 2083 	mov	r5,a
      002E52 A3               [24] 2084 	inc	dptr
      002E53 E0               [24] 2085 	movx	a,@dptr
      002E54 FE               [12] 2086 	mov	r6,a
      002E55 A3               [24] 2087 	inc	dptr
      002E56 E0               [24] 2088 	movx	a,@dptr
      002E57 FF               [12] 2089 	mov	r7,a
      002E58 7B 00            [12] 2090 	mov	r3,#0x00
      002E5A 7C 00            [12] 2091 	mov	r4,#0x00
      002E5C                       2092 00101$:
      002E5C 8D 82            [24] 2093 	mov	dpl,r5
      002E5E 8E 83            [24] 2094 	mov	dph,r6
      002E60 8F F0            [24] 2095 	mov	b,r7
      002E62 12 49 F6         [24] 2096 	lcall	__gptrget
      002E65 FA               [12] 2097 	mov	r2,a
      002E66 60 36            [24] 2098 	jz	00108$
                                   2099 ;	uart.c:309: putchar(*str++);
      002E68 0D               [12] 2100 	inc	r5
      002E69 BD 00 01         [24] 2101 	cjne	r5,#0x00,00116$
      002E6C 0E               [12] 2102 	inc	r6
      002E6D                       2103 00116$:
      002E6D 90 1A FF         [24] 2104 	mov	dptr,#_putstr_str_65536_108
      002E70 ED               [12] 2105 	mov	a,r5
      002E71 F0               [24] 2106 	movx	@dptr,a
      002E72 EE               [12] 2107 	mov	a,r6
      002E73 A3               [24] 2108 	inc	dptr
      002E74 F0               [24] 2109 	movx	@dptr,a
      002E75 EF               [12] 2110 	mov	a,r7
      002E76 A3               [24] 2111 	inc	dptr
      002E77 F0               [24] 2112 	movx	@dptr,a
      002E78 8A 01            [24] 2113 	mov	ar1,r2
      002E7A 7A 00            [12] 2114 	mov	r2,#0x00
      002E7C 89 82            [24] 2115 	mov	dpl,r1
      002E7E 8A 83            [24] 2116 	mov	dph,r2
      002E80 C0 07            [24] 2117 	push	ar7
      002E82 C0 06            [24] 2118 	push	ar6
      002E84 C0 05            [24] 2119 	push	ar5
      002E86 C0 04            [24] 2120 	push	ar4
      002E88 C0 03            [24] 2121 	push	ar3
      002E8A 12 2E 0C         [24] 2122 	lcall	_putchar
      002E8D D0 03            [24] 2123 	pop	ar3
      002E8F D0 04            [24] 2124 	pop	ar4
      002E91 D0 05            [24] 2125 	pop	ar5
      002E93 D0 06            [24] 2126 	pop	ar6
      002E95 D0 07            [24] 2127 	pop	ar7
                                   2128 ;	uart.c:310: index++;
      002E97 0B               [12] 2129 	inc	r3
      002E98 BB 00 C1         [24] 2130 	cjne	r3,#0x00,00101$
      002E9B 0C               [12] 2131 	inc	r4
      002E9C 80 BE            [24] 2132 	sjmp	00101$
      002E9E                       2133 00108$:
      002E9E 90 1A FF         [24] 2134 	mov	dptr,#_putstr_str_65536_108
      002EA1 ED               [12] 2135 	mov	a,r5
      002EA2 F0               [24] 2136 	movx	@dptr,a
      002EA3 EE               [12] 2137 	mov	a,r6
      002EA4 A3               [24] 2138 	inc	dptr
      002EA5 F0               [24] 2139 	movx	@dptr,a
      002EA6 EF               [12] 2140 	mov	a,r7
      002EA7 A3               [24] 2141 	inc	dptr
      002EA8 F0               [24] 2142 	movx	@dptr,a
                                   2143 ;	uart.c:312: return index + 1;
      002EA9 0B               [12] 2144 	inc	r3
      002EAA BB 00 01         [24] 2145 	cjne	r3,#0x00,00118$
      002EAD 0C               [12] 2146 	inc	r4
      002EAE                       2147 00118$:
      002EAE 8B 82            [24] 2148 	mov	dpl,r3
      002EB0 8C 83            [24] 2149 	mov	dph,r4
                                   2150 ;	uart.c:313: }
      002EB2 22               [24] 2151 	ret
                                   2152 ;------------------------------------------------------------
                                   2153 ;Allocation info for local variables in function 'accept_number_from_user'
                                   2154 ;------------------------------------------------------------
                                   2155 ;received_char             Allocated with name '_accept_number_from_user_received_char_65536_111'
                                   2156 ;number_in_char            Allocated with name '_accept_number_from_user_number_in_char_65536_111'
                                   2157 ;valid_number_status       Allocated with name '_accept_number_from_user_valid_number_status_65536_111'
                                   2158 ;number                    Allocated with name '_accept_number_from_user_number_65536_111'
                                   2159 ;i                         Allocated with name '_accept_number_from_user_i_65536_111'
                                   2160 ;------------------------------------------------------------
                                   2161 ;	uart.c:319: int accept_number_from_user()
                                   2162 ;	-----------------------------------------
                                   2163 ;	 function accept_number_from_user
                                   2164 ;	-----------------------------------------
      002EB3                       2165 _accept_number_from_user:
                                   2166 ;	uart.c:321: char received_char = '`';
      002EB3 90 1B 02         [24] 2167 	mov	dptr,#_accept_number_from_user_received_char_65536_111
      002EB6 74 60            [12] 2168 	mov	a,#0x60
      002EB8 F0               [24] 2169 	movx	@dptr,a
                                   2170 ;	uart.c:322: char number_in_char[25] = "\0";
      002EB9 90 1B 03         [24] 2171 	mov	dptr,#_accept_number_from_user_number_in_char_65536_111
      002EBC E4               [12] 2172 	clr	a
      002EBD F0               [24] 2173 	movx	@dptr,a
      002EBE 90 1B 04         [24] 2174 	mov	dptr,#(_accept_number_from_user_number_in_char_65536_111 + 0x0001)
      002EC1 F0               [24] 2175 	movx	@dptr,a
      002EC2 90 1B 05         [24] 2176 	mov	dptr,#(_accept_number_from_user_number_in_char_65536_111 + 0x0002)
      002EC5 F0               [24] 2177 	movx	@dptr,a
      002EC6 90 1B 06         [24] 2178 	mov	dptr,#(_accept_number_from_user_number_in_char_65536_111 + 0x0003)
      002EC9 F0               [24] 2179 	movx	@dptr,a
      002ECA 90 1B 07         [24] 2180 	mov	dptr,#(_accept_number_from_user_number_in_char_65536_111 + 0x0004)
      002ECD F0               [24] 2181 	movx	@dptr,a
      002ECE 90 1B 08         [24] 2182 	mov	dptr,#(_accept_number_from_user_number_in_char_65536_111 + 0x0005)
      002ED1 F0               [24] 2183 	movx	@dptr,a
      002ED2 90 1B 09         [24] 2184 	mov	dptr,#(_accept_number_from_user_number_in_char_65536_111 + 0x0006)
      002ED5 F0               [24] 2185 	movx	@dptr,a
      002ED6 90 1B 0A         [24] 2186 	mov	dptr,#(_accept_number_from_user_number_in_char_65536_111 + 0x0007)
      002ED9 F0               [24] 2187 	movx	@dptr,a
      002EDA 90 1B 0B         [24] 2188 	mov	dptr,#(_accept_number_from_user_number_in_char_65536_111 + 0x0008)
      002EDD F0               [24] 2189 	movx	@dptr,a
      002EDE 90 1B 0C         [24] 2190 	mov	dptr,#(_accept_number_from_user_number_in_char_65536_111 + 0x0009)
      002EE1 F0               [24] 2191 	movx	@dptr,a
      002EE2 90 1B 0D         [24] 2192 	mov	dptr,#(_accept_number_from_user_number_in_char_65536_111 + 0x000a)
      002EE5 F0               [24] 2193 	movx	@dptr,a
      002EE6 90 1B 0E         [24] 2194 	mov	dptr,#(_accept_number_from_user_number_in_char_65536_111 + 0x000b)
      002EE9 F0               [24] 2195 	movx	@dptr,a
      002EEA 90 1B 0F         [24] 2196 	mov	dptr,#(_accept_number_from_user_number_in_char_65536_111 + 0x000c)
      002EED F0               [24] 2197 	movx	@dptr,a
      002EEE 90 1B 10         [24] 2198 	mov	dptr,#(_accept_number_from_user_number_in_char_65536_111 + 0x000d)
      002EF1 F0               [24] 2199 	movx	@dptr,a
      002EF2 90 1B 11         [24] 2200 	mov	dptr,#(_accept_number_from_user_number_in_char_65536_111 + 0x000e)
      002EF5 F0               [24] 2201 	movx	@dptr,a
      002EF6 90 1B 12         [24] 2202 	mov	dptr,#(_accept_number_from_user_number_in_char_65536_111 + 0x000f)
      002EF9 F0               [24] 2203 	movx	@dptr,a
      002EFA 90 1B 13         [24] 2204 	mov	dptr,#(_accept_number_from_user_number_in_char_65536_111 + 0x0010)
      002EFD F0               [24] 2205 	movx	@dptr,a
      002EFE 90 1B 14         [24] 2206 	mov	dptr,#(_accept_number_from_user_number_in_char_65536_111 + 0x0011)
      002F01 F0               [24] 2207 	movx	@dptr,a
      002F02 90 1B 15         [24] 2208 	mov	dptr,#(_accept_number_from_user_number_in_char_65536_111 + 0x0012)
      002F05 F0               [24] 2209 	movx	@dptr,a
      002F06 90 1B 16         [24] 2210 	mov	dptr,#(_accept_number_from_user_number_in_char_65536_111 + 0x0013)
      002F09 F0               [24] 2211 	movx	@dptr,a
      002F0A 90 1B 17         [24] 2212 	mov	dptr,#(_accept_number_from_user_number_in_char_65536_111 + 0x0014)
      002F0D F0               [24] 2213 	movx	@dptr,a
      002F0E 90 1B 18         [24] 2214 	mov	dptr,#(_accept_number_from_user_number_in_char_65536_111 + 0x0015)
      002F11 F0               [24] 2215 	movx	@dptr,a
      002F12 90 1B 19         [24] 2216 	mov	dptr,#(_accept_number_from_user_number_in_char_65536_111 + 0x0016)
      002F15 F0               [24] 2217 	movx	@dptr,a
      002F16 90 1B 1A         [24] 2218 	mov	dptr,#(_accept_number_from_user_number_in_char_65536_111 + 0x0017)
      002F19 F0               [24] 2219 	movx	@dptr,a
      002F1A 90 1B 1B         [24] 2220 	mov	dptr,#(_accept_number_from_user_number_in_char_65536_111 + 0x0018)
      002F1D F0               [24] 2221 	movx	@dptr,a
                                   2222 ;	uart.c:323: bool valid_number_status = false;
      002F1E 90 1B 1C         [24] 2223 	mov	dptr,#_accept_number_from_user_valid_number_status_65536_111
      002F21 F0               [24] 2224 	movx	@dptr,a
                                   2225 ;	uart.c:324: int number = 0;
      002F22 90 1B 1D         [24] 2226 	mov	dptr,#_accept_number_from_user_number_65536_111
      002F25 F0               [24] 2227 	movx	@dptr,a
      002F26 A3               [24] 2228 	inc	dptr
      002F27 F0               [24] 2229 	movx	@dptr,a
                                   2230 ;	uart.c:325: int i = 0;
      002F28 90 1B 1F         [24] 2231 	mov	dptr,#_accept_number_from_user_i_65536_111
      002F2B F0               [24] 2232 	movx	@dptr,a
      002F2C A3               [24] 2233 	inc	dptr
      002F2D F0               [24] 2234 	movx	@dptr,a
                                   2235 ;	uart.c:326: while (valid_number_status == false)
      002F2E                       2236 00110$:
      002F2E 90 1B 1C         [24] 2237 	mov	dptr,#_accept_number_from_user_valid_number_status_65536_111
      002F31 E0               [24] 2238 	movx	a,@dptr
      002F32 60 03            [24] 2239 	jz	00139$
      002F34 02 30 31         [24] 2240 	ljmp	00112$
      002F37                       2241 00139$:
                                   2242 ;	uart.c:328: received_char = getchar();
      002F37 12 2E 2B         [24] 2243 	lcall	_getchar
      002F3A AE 82            [24] 2244 	mov	r6,dpl
      002F3C 90 1B 02         [24] 2245 	mov	dptr,#_accept_number_from_user_received_char_65536_111
      002F3F EE               [12] 2246 	mov	a,r6
      002F40 F0               [24] 2247 	movx	@dptr,a
                                   2248 ;	uart.c:329: i++;
      002F41 90 1B 1F         [24] 2249 	mov	dptr,#_accept_number_from_user_i_65536_111
      002F44 E0               [24] 2250 	movx	a,@dptr
      002F45 24 01            [12] 2251 	add	a,#0x01
      002F47 F0               [24] 2252 	movx	@dptr,a
      002F48 A3               [24] 2253 	inc	dptr
      002F49 E0               [24] 2254 	movx	a,@dptr
      002F4A 34 00            [12] 2255 	addc	a,#0x00
      002F4C F0               [24] 2256 	movx	@dptr,a
                                   2257 ;	uart.c:330: echo(received_char);
      002F4D 8E 82            [24] 2258 	mov	dpl,r6
      002F4F 12 23 D7         [24] 2259 	lcall	_echo
                                   2260 ;	uart.c:332: if (!(received_char >= '0' && received_char <= '9') && (received_char != '\r'))
      002F52 90 1B 02         [24] 2261 	mov	dptr,#_accept_number_from_user_received_char_65536_111
      002F55 E0               [24] 2262 	movx	a,@dptr
      002F56 FF               [12] 2263 	mov	r7,a
      002F57 BF 30 00         [24] 2264 	cjne	r7,#0x30,00140$
      002F5A                       2265 00140$:
      002F5A 40 05            [24] 2266 	jc	00107$
      002F5C EF               [12] 2267 	mov	a,r7
      002F5D 24 C6            [12] 2268 	add	a,#0xff - 0x39
      002F5F 50 33            [24] 2269 	jnc	00104$
      002F61                       2270 00107$:
      002F61 90 1B 02         [24] 2271 	mov	dptr,#_accept_number_from_user_received_char_65536_111
      002F64 E0               [24] 2272 	movx	a,@dptr
      002F65 FF               [12] 2273 	mov	r7,a
      002F66 BF 0D 02         [24] 2274 	cjne	r7,#0x0d,00143$
      002F69 80 29            [24] 2275 	sjmp	00104$
      002F6B                       2276 00143$:
                                   2277 ;	uart.c:335: memset(number_in_char, 0, sizeof(number_in_char));
      002F6B 90 1B 4A         [24] 2278 	mov	dptr,#_memset_PARM_2
      002F6E E4               [12] 2279 	clr	a
      002F6F F0               [24] 2280 	movx	@dptr,a
      002F70 90 1B 4B         [24] 2281 	mov	dptr,#_memset_PARM_3
      002F73 74 19            [12] 2282 	mov	a,#0x19
      002F75 F0               [24] 2283 	movx	@dptr,a
      002F76 E4               [12] 2284 	clr	a
      002F77 A3               [24] 2285 	inc	dptr
      002F78 F0               [24] 2286 	movx	@dptr,a
      002F79 90 1B 03         [24] 2287 	mov	dptr,#_accept_number_from_user_number_in_char_65536_111
      002F7C 75 F0 00         [24] 2288 	mov	b,#0x00
      002F7F 12 37 EB         [24] 2289 	lcall	_memset
                                   2290 ;	uart.c:336: putstr("\r\n\t\t Error: Re-enter the number: ");
      002F82 90 51 4A         [24] 2291 	mov	dptr,#___str_32
      002F85 75 F0 80         [24] 2292 	mov	b,#0x80
      002F88 12 2E 3D         [24] 2293 	lcall	_putstr
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
      002FF1 EE               [12] 2361 	mov	a,r6
      002FF2 94 18            [12] 2362 	subb	a,#0x18
      002FF4 EF               [12] 2363 	mov	a,r7
      002FF5 64 80            [12] 2364 	xrl	a,#0x80
      002FF7 94 80            [12] 2365 	subb	a,#0x80
      002FF9 50 03            [24] 2366 	jnc	00146$
      002FFB 02 2F 2E         [24] 2367 	ljmp	00110$
      002FFE                       2368 00146$:
                                   2369 ;	uart.c:352: putstr("\r\n\t\t Error: Reading a number failed, Reached maximum length supported");
      002FFE 90 51 6C         [24] 2370 	mov	dptr,#___str_33
      003001 75 F0 80         [24] 2371 	mov	b,#0x80
      003004 12 2E 3D         [24] 2372 	lcall	_putstr
                                   2373 ;	uart.c:353: putstr("\r\n\t\t Error: Re-enter the number: ");
      003007 90 51 4A         [24] 2374 	mov	dptr,#___str_32
      00300A 75 F0 80         [24] 2375 	mov	b,#0x80
      00300D 12 2E 3D         [24] 2376 	lcall	_putstr
                                   2377 ;	uart.c:355: memset(number_in_char, 0, sizeof(number_in_char));
      003010 90 1B 4A         [24] 2378 	mov	dptr,#_memset_PARM_2
      003013 E4               [12] 2379 	clr	a
      003014 F0               [24] 2380 	movx	@dptr,a
      003015 90 1B 4B         [24] 2381 	mov	dptr,#_memset_PARM_3
      003018 74 19            [12] 2382 	mov	a,#0x19
      00301A F0               [24] 2383 	movx	@dptr,a
      00301B E4               [12] 2384 	clr	a
      00301C A3               [24] 2385 	inc	dptr
      00301D F0               [24] 2386 	movx	@dptr,a
      00301E 90 1B 03         [24] 2387 	mov	dptr,#_accept_number_from_user_number_in_char_65536_111
      003021 75 F0 00         [24] 2388 	mov	b,#0x00
      003024 12 37 EB         [24] 2389 	lcall	_memset
                                   2390 ;	uart.c:356: i = 0;
      003027 90 1B 1F         [24] 2391 	mov	dptr,#_accept_number_from_user_i_65536_111
      00302A E4               [12] 2392 	clr	a
      00302B F0               [24] 2393 	movx	@dptr,a
      00302C A3               [24] 2394 	inc	dptr
      00302D F0               [24] 2395 	movx	@dptr,a
      00302E 02 2F 2E         [24] 2396 	ljmp	00110$
      003031                       2397 00112$:
                                   2398 ;	uart.c:359: return number;
      003031 90 1B 1D         [24] 2399 	mov	dptr,#_accept_number_from_user_number_65536_111
      003034 E0               [24] 2400 	movx	a,@dptr
      003035 FE               [12] 2401 	mov	r6,a
      003036 A3               [24] 2402 	inc	dptr
      003037 E0               [24] 2403 	movx	a,@dptr
                                   2404 ;	uart.c:360: }
      003038 8E 82            [24] 2405 	mov	dpl,r6
      00303A F5 83            [12] 2406 	mov	dph,a
      00303C 22               [24] 2407 	ret
                                   2408 ;------------------------------------------------------------
                                   2409 ;Allocation info for local variables in function 'print_buffers'
                                   2410 ;------------------------------------------------------------
                                   2411 ;sloc0                     Allocated with name '_print_buffers_sloc0_1_0'
                                   2412 ;buffers                   Allocated with name '_print_buffers_buffers_65536_116'
                                   2413 ;i                         Allocated with name '_print_buffers_i_131072_118'
                                   2414 ;------------------------------------------------------------
                                   2415 ;	uart.c:365: void print_buffers(buffer_t *buffers)
                                   2416 ;	-----------------------------------------
                                   2417 ;	 function print_buffers
                                   2418 ;	-----------------------------------------
      00303D                       2419 _print_buffers:
      00303D AF F0            [24] 2420 	mov	r7,b
      00303F AE 83            [24] 2421 	mov	r6,dph
      003041 E5 82            [12] 2422 	mov	a,dpl
      003043 90 1B 21         [24] 2423 	mov	dptr,#_print_buffers_buffers_65536_116
      003046 F0               [24] 2424 	movx	@dptr,a
      003047 EE               [12] 2425 	mov	a,r6
      003048 A3               [24] 2426 	inc	dptr
      003049 F0               [24] 2427 	movx	@dptr,a
      00304A EF               [12] 2428 	mov	a,r7
      00304B A3               [24] 2429 	inc	dptr
      00304C F0               [24] 2430 	movx	@dptr,a
                                   2431 ;	uart.c:367: printf_tiny("\r\n\r\n\t\t-------------------------");
      00304D 74 9C            [12] 2432 	mov	a,#___str_8
      00304F C0 E0            [24] 2433 	push	acc
      003051 74 4D            [12] 2434 	mov	a,#(___str_8 >> 8)
      003053 C0 E0            [24] 2435 	push	acc
      003055 12 39 BC         [24] 2436 	lcall	_printf_tiny
      003058 15 81            [12] 2437 	dec	sp
      00305A 15 81            [12] 2438 	dec	sp
                                   2439 ;	uart.c:368: printf_tiny("\r\n\t\t| buffer id |\tsize\t|");
      00305C 74 B2            [12] 2440 	mov	a,#___str_34
      00305E C0 E0            [24] 2441 	push	acc
      003060 74 51            [12] 2442 	mov	a,#(___str_34 >> 8)
      003062 C0 E0            [24] 2443 	push	acc
      003064 12 39 BC         [24] 2444 	lcall	_printf_tiny
      003067 15 81            [12] 2445 	dec	sp
      003069 15 81            [12] 2446 	dec	sp
                                   2447 ;	uart.c:369: printf_tiny("\r\n\t\t-------------------------");
      00306B 74 D3            [12] 2448 	mov	a,#___str_10
      00306D C0 E0            [24] 2449 	push	acc
      00306F 74 4D            [12] 2450 	mov	a,#(___str_10 >> 8)
      003071 C0 E0            [24] 2451 	push	acc
      003073 12 39 BC         [24] 2452 	lcall	_printf_tiny
      003076 15 81            [12] 2453 	dec	sp
      003078 15 81            [12] 2454 	dec	sp
                                   2455 ;	uart.c:370: for (int i = 0; i < MAX_NUM_OF_BUFFERS; i++)
      00307A 90 1B 21         [24] 2456 	mov	dptr,#_print_buffers_buffers_65536_116
      00307D E0               [24] 2457 	movx	a,@dptr
      00307E FD               [12] 2458 	mov	r5,a
      00307F A3               [24] 2459 	inc	dptr
      003080 E0               [24] 2460 	movx	a,@dptr
      003081 FE               [12] 2461 	mov	r6,a
      003082 A3               [24] 2462 	inc	dptr
      003083 E0               [24] 2463 	movx	a,@dptr
      003084 FF               [12] 2464 	mov	r7,a
      003085 8D 15            [24] 2465 	mov	_print_buffers_sloc0_1_0,r5
      003087 8E 16            [24] 2466 	mov	(_print_buffers_sloc0_1_0 + 1),r6
      003089 8F 17            [24] 2467 	mov	(_print_buffers_sloc0_1_0 + 2),r7
      00308B 78 00            [12] 2468 	mov	r0,#0x00
      00308D 79 00            [12] 2469 	mov	r1,#0x00
      00308F                       2470 00107$:
      00308F C3               [12] 2471 	clr	c
      003090 E8               [12] 2472 	mov	a,r0
      003091 94 D2            [12] 2473 	subb	a,#0xd2
      003093 E9               [12] 2474 	mov	a,r1
      003094 64 80            [12] 2475 	xrl	a,#0x80
      003096 94 80            [12] 2476 	subb	a,#0x80
      003098 40 03            [24] 2477 	jc	00128$
      00309A 02 31 89         [24] 2478 	ljmp	00105$
      00309D                       2479 00128$:
                                   2480 ;	uart.c:372: if ((buffers[i].buffer_pointer != 0) || (i == 0) || (i == 1))
      00309D 90 1B 5A         [24] 2481 	mov	dptr,#__mulint_PARM_2
      0030A0 E8               [12] 2482 	mov	a,r0
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
                                   2616 ;	uart.c:370: for (int i = 0; i < MAX_NUM_OF_BUFFERS; i++)
      003181 08               [12] 2617 	inc	r0
      003182 B8 00 01         [24] 2618 	cjne	r0,#0x00,00133$
      003185 09               [12] 2619 	inc	r1
      003186                       2620 00133$:
      003186 02 30 8F         [24] 2621 	ljmp	00107$
      003189                       2622 00105$:
                                   2623 ;	uart.c:375: printf_tiny("\r\n\t\t-------------------------\r\n");
      003189 74 1B            [12] 2624 	mov	a,#___str_13
      00318B C0 E0            [24] 2625 	push	acc
      00318D 74 4E            [12] 2626 	mov	a,#(___str_13 >> 8)
      00318F C0 E0            [24] 2627 	push	acc
      003191 12 39 BC         [24] 2628 	lcall	_printf_tiny
      003194 15 81            [12] 2629 	dec	sp
      003196 15 81            [12] 2630 	dec	sp
                                   2631 ;	uart.c:376: }
      003198 22               [24] 2632 	ret
                                   2633 ;------------------------------------------------------------
                                   2634 ;Allocation info for local variables in function 'hexdump'
                                   2635 ;------------------------------------------------------------
                                   2636 ;sloc0                     Allocated with name '_hexdump_sloc0_1_0'
                                   2637 ;sloc1                     Allocated with name '_hexdump_sloc1_1_0'
                                   2638 ;nbytes                    Allocated with name '_hexdump_PARM_2'
                                   2639 ;loc                       Allocated with name '_hexdump_loc_65536_120'
                                   2640 ;loc_pointer               Allocated with name '_hexdump_loc_pointer_65536_121'
                                   2641 ;hex_byte                  Allocated with name '_hexdump_hex_byte_65536_121'
                                   2642 ;address_bytes             Allocated with name '_hexdump_address_bytes_65536_121'
                                   2643 ;num                       Allocated with name '_hexdump_num_65536_121'
                                   2644 ;total_chars_in_output_string Allocated with name '_hexdump_total_chars_in_output_string_65536_121'
                                   2645 ;i                         Allocated with name '_hexdump_i_131072_123'
                                   2646 ;j                         Allocated with name '_hexdump_j_327680_126'
                                   2647 ;------------------------------------------------------------
                                   2648 ;	uart.c:381: void hexdump(const void *loc, long nbytes)
                                   2649 ;	-----------------------------------------
                                   2650 ;	 function hexdump
                                   2651 ;	-----------------------------------------
      003199                       2652 _hexdump:
      003199 AF F0            [24] 2653 	mov	r7,b
      00319B AE 83            [24] 2654 	mov	r6,dph
      00319D E5 82            [12] 2655 	mov	a,dpl
      00319F 90 1B 28         [24] 2656 	mov	dptr,#_hexdump_loc_65536_120
      0031A2 F0               [24] 2657 	movx	@dptr,a
      0031A3 EE               [12] 2658 	mov	a,r6
      0031A4 A3               [24] 2659 	inc	dptr
      0031A5 F0               [24] 2660 	movx	@dptr,a
      0031A6 EF               [12] 2661 	mov	a,r7
      0031A7 A3               [24] 2662 	inc	dptr
      0031A8 F0               [24] 2663 	movx	@dptr,a
                                   2664 ;	uart.c:383: const char *loc_pointer = loc;
      0031A9 90 1B 28         [24] 2665 	mov	dptr,#_hexdump_loc_65536_120
      0031AC E0               [24] 2666 	movx	a,@dptr
      0031AD FD               [12] 2667 	mov	r5,a
      0031AE A3               [24] 2668 	inc	dptr
      0031AF E0               [24] 2669 	movx	a,@dptr
      0031B0 FE               [12] 2670 	mov	r6,a
      0031B1 A3               [24] 2671 	inc	dptr
      0031B2 E0               [24] 2672 	movx	a,@dptr
      0031B3 FF               [12] 2673 	mov	r7,a
                                   2674 ;	uart.c:384: char hex_byte[5] = "FF";
      0031B4 90 1B 2B         [24] 2675 	mov	dptr,#_hexdump_hex_byte_65536_121
      0031B7 74 46            [12] 2676 	mov	a,#0x46
      0031B9 F0               [24] 2677 	movx	@dptr,a
      0031BA 90 1B 2C         [24] 2678 	mov	dptr,#(_hexdump_hex_byte_65536_121 + 0x0001)
      0031BD F0               [24] 2679 	movx	@dptr,a
      0031BE 90 1B 2D         [24] 2680 	mov	dptr,#(_hexdump_hex_byte_65536_121 + 0x0002)
      0031C1 E4               [12] 2681 	clr	a
      0031C2 F0               [24] 2682 	movx	@dptr,a
      0031C3 90 1B 2E         [24] 2683 	mov	dptr,#(_hexdump_hex_byte_65536_121 + 0x0003)
      0031C6 F0               [24] 2684 	movx	@dptr,a
      0031C7 90 1B 2F         [24] 2685 	mov	dptr,#(_hexdump_hex_byte_65536_121 + 0x0004)
      0031CA F0               [24] 2686 	movx	@dptr,a
                                   2687 ;	uart.c:385: char address_bytes[7] = "0x0000";
      0031CB 90 1B 30         [24] 2688 	mov	dptr,#_hexdump_address_bytes_65536_121
      0031CE 74 30            [12] 2689 	mov	a,#0x30
      0031D0 F0               [24] 2690 	movx	@dptr,a
      0031D1 90 1B 31         [24] 2691 	mov	dptr,#(_hexdump_address_bytes_65536_121 + 0x0001)
      0031D4 74 78            [12] 2692 	mov	a,#0x78
      0031D6 F0               [24] 2693 	movx	@dptr,a
      0031D7 90 1B 32         [24] 2694 	mov	dptr,#(_hexdump_address_bytes_65536_121 + 0x0002)
      0031DA 74 30            [12] 2695 	mov	a,#0x30
      0031DC F0               [24] 2696 	movx	@dptr,a
      0031DD 90 1B 33         [24] 2697 	mov	dptr,#(_hexdump_address_bytes_65536_121 + 0x0003)
      0031E0 F0               [24] 2698 	movx	@dptr,a
      0031E1 90 1B 34         [24] 2699 	mov	dptr,#(_hexdump_address_bytes_65536_121 + 0x0004)
      0031E4 F0               [24] 2700 	movx	@dptr,a
      0031E5 90 1B 35         [24] 2701 	mov	dptr,#(_hexdump_address_bytes_65536_121 + 0x0005)
      0031E8 F0               [24] 2702 	movx	@dptr,a
      0031E9 90 1B 36         [24] 2703 	mov	dptr,#(_hexdump_address_bytes_65536_121 + 0x0006)
      0031EC E4               [12] 2704 	clr	a
      0031ED F0               [24] 2705 	movx	@dptr,a
                                   2706 ;	uart.c:392: if (nbytes == 0)
      0031EE 90 1B 24         [24] 2707 	mov	dptr,#_hexdump_PARM_2
      0031F1 E0               [24] 2708 	movx	a,@dptr
      0031F2 F9               [12] 2709 	mov	r1,a
      0031F3 A3               [24] 2710 	inc	dptr
      0031F4 E0               [24] 2711 	movx	a,@dptr
      0031F5 FA               [12] 2712 	mov	r2,a
      0031F6 A3               [24] 2713 	inc	dptr
      0031F7 E0               [24] 2714 	movx	a,@dptr
      0031F8 FB               [12] 2715 	mov	r3,a
      0031F9 A3               [24] 2716 	inc	dptr
      0031FA E0               [24] 2717 	movx	a,@dptr
      0031FB FC               [12] 2718 	mov	r4,a
      0031FC 90 1B 24         [24] 2719 	mov	dptr,#_hexdump_PARM_2
      0031FF E0               [24] 2720 	movx	a,@dptr
      003200 F5 F0            [12] 2721 	mov	b,a
      003202 A3               [24] 2722 	inc	dptr
      003203 E0               [24] 2723 	movx	a,@dptr
      003204 42 F0            [12] 2724 	orl	b,a
      003206 A3               [24] 2725 	inc	dptr
      003207 E0               [24] 2726 	movx	a,@dptr
      003208 42 F0            [12] 2727 	orl	b,a
      00320A A3               [24] 2728 	inc	dptr
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
                                   3125 ;Allocation info for local variables in function 'uint_to_hexstr'
                                   3126 ;------------------------------------------------------------
                                   3127 ;sloc0                     Allocated with name '_uint_to_hexstr_sloc0_1_0'
                                   3128 ;sloc1                     Allocated with name '_uint_to_hexstr_sloc1_1_0'
                                   3129 ;sloc2                     Allocated with name '_uint_to_hexstr_sloc2_1_0'
                                   3130 ;sloc3                     Allocated with name '_uint_to_hexstr_sloc3_1_0'
                                   3131 ;size                      Allocated with name '_uint_to_hexstr_PARM_2'
                                   3132 ;num                       Allocated with name '_uint_to_hexstr_PARM_3'
                                   3133 ;nbits                     Allocated with name '_uint_to_hexstr_PARM_4'
                                   3134 ;str                       Allocated with name '_uint_to_hexstr_str_65536_128'
                                   3135 ;rem                       Allocated with name '_uint_to_hexstr_rem_65536_129'
                                   3136 ;total_chars               Allocated with name '_uint_to_hexstr_total_chars_65536_129'
                                   3137 ;i                         Allocated with name '_uint_to_hexstr_i_131072_132'
                                   3138 ;------------------------------------------------------------
                                   3139 ;	uart.c:427: int uint_to_hexstr(char *str, long size, uint16_t num, uint8_t nbits)
                                   3140 ;	-----------------------------------------
                                   3141 ;	 function uint_to_hexstr
                                   3142 ;	-----------------------------------------
      0034C5                       3143 _uint_to_hexstr:
      0034C5 AF F0            [24] 3144 	mov	r7,b
      0034C7 AE 83            [24] 3145 	mov	r6,dph
      0034C9 E5 82            [12] 3146 	mov	a,dpl
      0034CB 90 1B 3E         [24] 3147 	mov	dptr,#_uint_to_hexstr_str_65536_128
      0034CE F0               [24] 3148 	movx	@dptr,a
      0034CF EE               [12] 3149 	mov	a,r6
      0034D0 A3               [24] 3150 	inc	dptr
      0034D1 F0               [24] 3151 	movx	@dptr,a
      0034D2 EF               [12] 3152 	mov	a,r7
      0034D3 A3               [24] 3153 	inc	dptr
      0034D4 F0               [24] 3154 	movx	@dptr,a
                                   3155 ;	uart.c:433: if ((nbits != 4) && (nbits != 8) && (nbits != 16) && (nbits != 32))
      0034D5 90 1B 3D         [24] 3156 	mov	dptr,#_uint_to_hexstr_PARM_4
      0034D8 E0               [24] 3157 	movx	a,@dptr
      0034D9 FF               [12] 3158 	mov	r7,a
      0034DA BF 04 02         [24] 3159 	cjne	r7,#0x04,00150$
      0034DD 80 28            [24] 3160 	sjmp	00102$
      0034DF                       3161 00150$:
      0034DF BF 08 02         [24] 3162 	cjne	r7,#0x08,00151$
      0034E2 80 23            [24] 3163 	sjmp	00102$
      0034E4                       3164 00151$:
      0034E4 BF 10 02         [24] 3165 	cjne	r7,#0x10,00152$
      0034E7 80 1E            [24] 3166 	sjmp	00102$
      0034E9                       3167 00152$:
      0034E9 BF 20 02         [24] 3168 	cjne	r7,#0x20,00153$
      0034EC 80 19            [24] 3169 	sjmp	00102$
      0034EE                       3170 00153$:
                                   3171 ;	uart.c:435: str[0] = '\0';
      0034EE 90 1B 3E         [24] 3172 	mov	dptr,#_uint_to_hexstr_str_65536_128
      0034F1 E0               [24] 3173 	movx	a,@dptr
      0034F2 FC               [12] 3174 	mov	r4,a
      0034F3 A3               [24] 3175 	inc	dptr
      0034F4 E0               [24] 3176 	movx	a,@dptr
      0034F5 FD               [12] 3177 	mov	r5,a
      0034F6 A3               [24] 3178 	inc	dptr
      0034F7 E0               [24] 3179 	movx	a,@dptr
      0034F8 FE               [12] 3180 	mov	r6,a
      0034F9 8C 82            [24] 3181 	mov	dpl,r4
      0034FB 8D 83            [24] 3182 	mov	dph,r5
      0034FD 8E F0            [24] 3183 	mov	b,r6
      0034FF E4               [12] 3184 	clr	a
      003500 12 39 A1         [24] 3185 	lcall	__gptrput
                                   3186 ;	uart.c:436: return -1;
      003503 90 FF FF         [24] 3187 	mov	dptr,#0xffff
      003506 22               [24] 3188 	ret
      003507                       3189 00102$:
                                   3190 ;	uart.c:439: total_chars = nbits / 4 + 3; // Every nibble requires 4 chars for representation AND +2 for 0x and +1 for \0
      003507 7E 00            [12] 3191 	mov	r6,#0x00
      003509 90 1B 78         [24] 3192 	mov	dptr,#__divsint_PARM_2
      00350C 74 04            [12] 3193 	mov	a,#0x04
      00350E F0               [24] 3194 	movx	@dptr,a
      00350F E4               [12] 3195 	clr	a
      003510 A3               [24] 3196 	inc	dptr
      003511 F0               [24] 3197 	movx	@dptr,a
      003512 8F 82            [24] 3198 	mov	dpl,r7
      003514 8E 83            [24] 3199 	mov	dph,r6
      003516 12 3E 87         [24] 3200 	lcall	__divsint
      003519 85 82 25         [24] 3201 	mov	_uint_to_hexstr_sloc3_1_0,dpl
      00351C 85 83 26         [24] 3202 	mov	(_uint_to_hexstr_sloc3_1_0 + 1),dph
      00351F 74 03            [12] 3203 	mov	a,#0x03
      003521 25 25            [12] 3204 	add	a,_uint_to_hexstr_sloc3_1_0
      003523 F5 20            [12] 3205 	mov	_uint_to_hexstr_sloc1_1_0,a
      003525 E4               [12] 3206 	clr	a
      003526 35 26            [12] 3207 	addc	a,(_uint_to_hexstr_sloc3_1_0 + 1)
      003528 F5 21            [12] 3208 	mov	(_uint_to_hexstr_sloc1_1_0 + 1),a
                                   3209 ;	uart.c:442: if (total_chars > size)
      00352A 90 1B 37         [24] 3210 	mov	dptr,#_uint_to_hexstr_PARM_2
      00352D E0               [24] 3211 	movx	a,@dptr
      00352E F5 1C            [12] 3212 	mov	_uint_to_hexstr_sloc0_1_0,a
      003530 A3               [24] 3213 	inc	dptr
      003531 E0               [24] 3214 	movx	a,@dptr
      003532 F5 1D            [12] 3215 	mov	(_uint_to_hexstr_sloc0_1_0 + 1),a
      003534 A3               [24] 3216 	inc	dptr
      003535 E0               [24] 3217 	movx	a,@dptr
      003536 F5 1E            [12] 3218 	mov	(_uint_to_hexstr_sloc0_1_0 + 2),a
      003538 A3               [24] 3219 	inc	dptr
      003539 E0               [24] 3220 	movx	a,@dptr
      00353A F5 1F            [12] 3221 	mov	(_uint_to_hexstr_sloc0_1_0 + 3),a
      00353C A8 20            [24] 3222 	mov	r0,_uint_to_hexstr_sloc1_1_0
      00353E E5 21            [12] 3223 	mov	a,(_uint_to_hexstr_sloc1_1_0 + 1)
      003540 F9               [12] 3224 	mov	r1,a
      003541 33               [12] 3225 	rlc	a
      003542 95 E0            [12] 3226 	subb	a,acc
      003544 FA               [12] 3227 	mov	r2,a
      003545 FB               [12] 3228 	mov	r3,a
      003546 C3               [12] 3229 	clr	c
      003547 E5 1C            [12] 3230 	mov	a,_uint_to_hexstr_sloc0_1_0
      003549 98               [12] 3231 	subb	a,r0
      00354A E5 1D            [12] 3232 	mov	a,(_uint_to_hexstr_sloc0_1_0 + 1)
      00354C 99               [12] 3233 	subb	a,r1
      00354D E5 1E            [12] 3234 	mov	a,(_uint_to_hexstr_sloc0_1_0 + 2)
      00354F 9A               [12] 3235 	subb	a,r2
      003550 E5 1F            [12] 3236 	mov	a,(_uint_to_hexstr_sloc0_1_0 + 3)
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
      005280 0A                    3848 	.db 0x0a
      005281 00                    3849 	.db 0x00
                                   3850 	.area CSEG    (CODE)
                                   3851 	.area XINIT   (CODE)
      00528D                       3852 __xinit__buf_number:
      00528D 00 00                 3853 	.byte #0x00, #0x00	;  0
      00528F                       3854 __xinit__total_malloced_data:
      00528F 00 00                 3855 	.byte #0x00, #0x00	;  0
                                   3856 	.area CABS    (ABS,CODE)
