dhirajbennadi/RemoteInterfacingWith8051/Pictures/Dhiraj/ScreenshotsLab1/screenshots.pdf

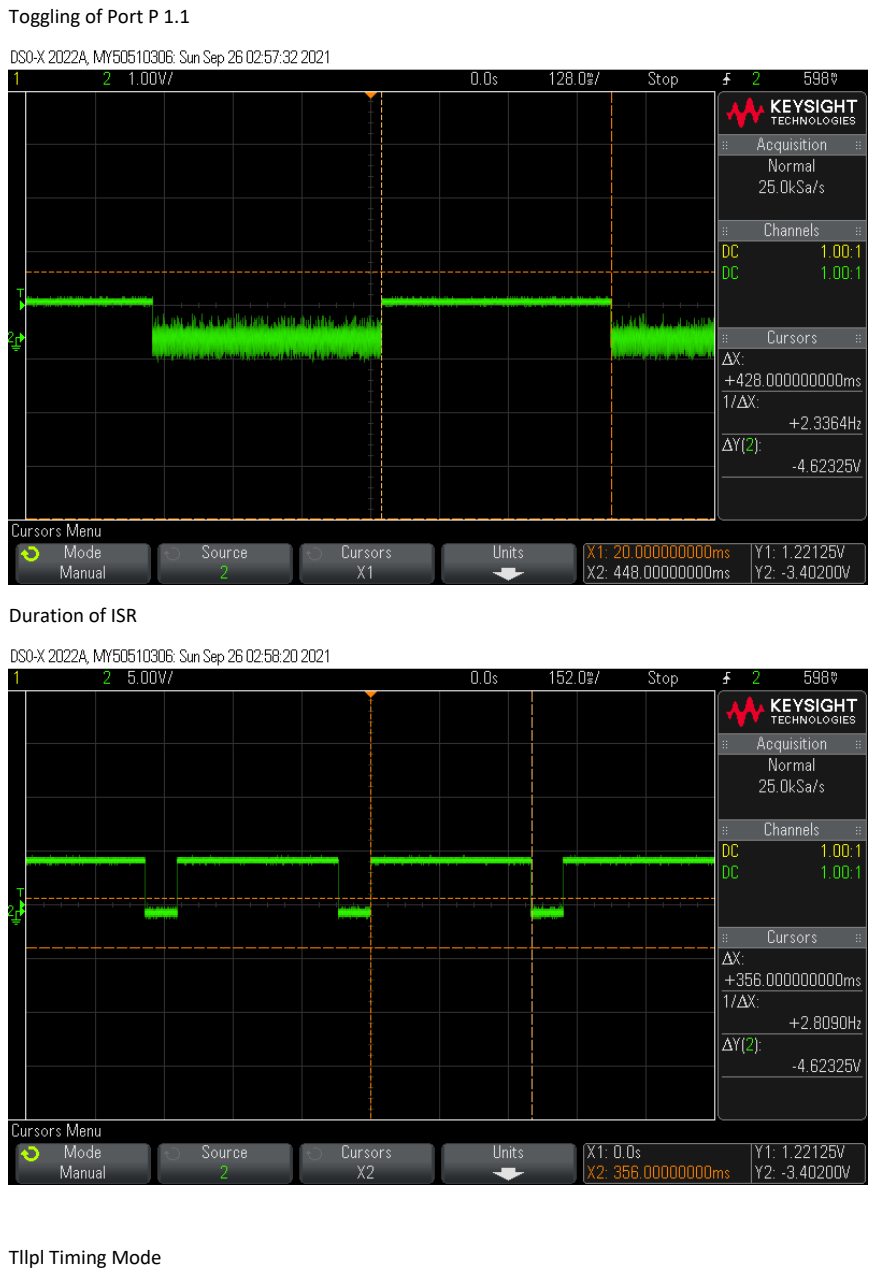
[picture p79: page 1]

Toggling of Port P 1.1

Duration of ISR

Tllpl Timing Mode

Tllpl State Mode

ALE Duration

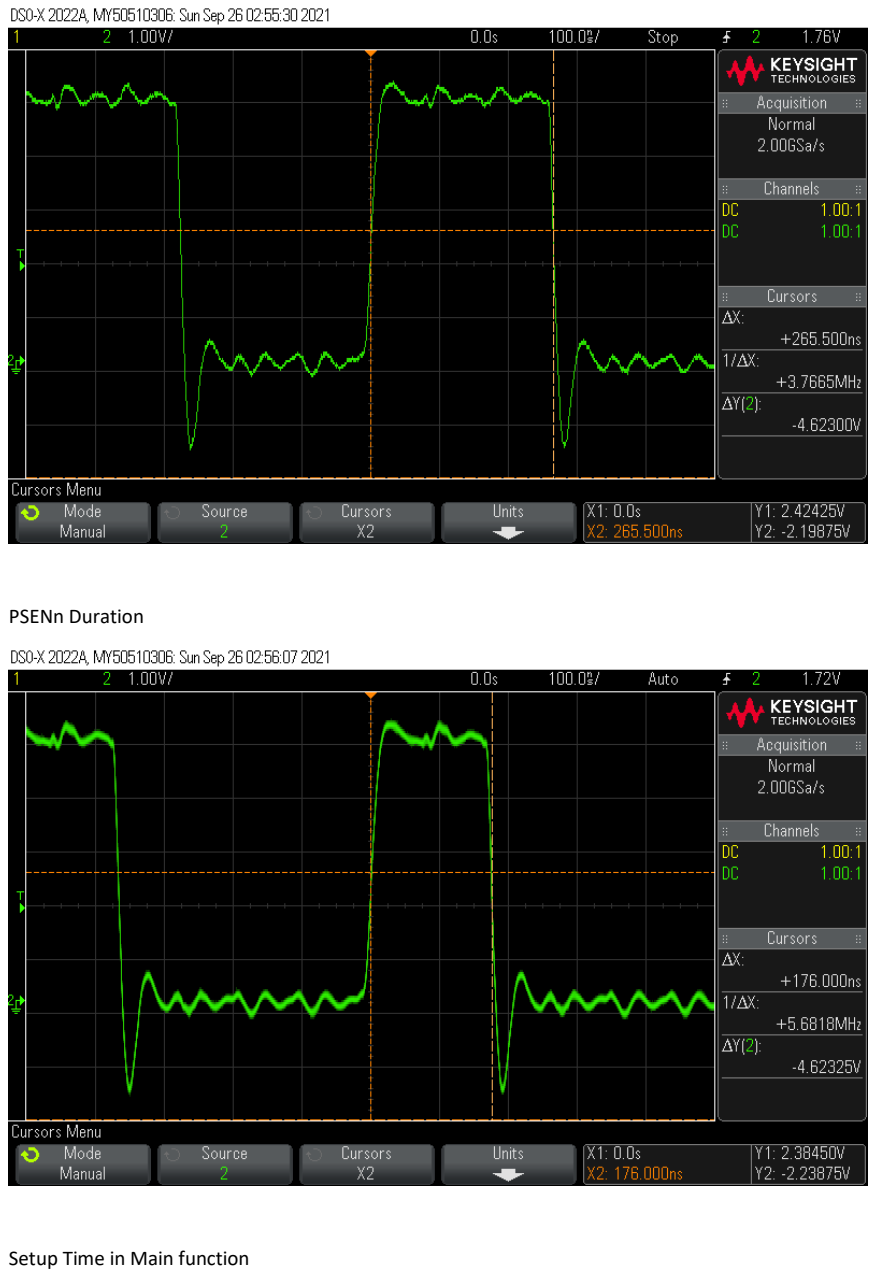
[picture p80: page 3]

PSENn Duration

Setup Time in Main function

Hold Time in Main function

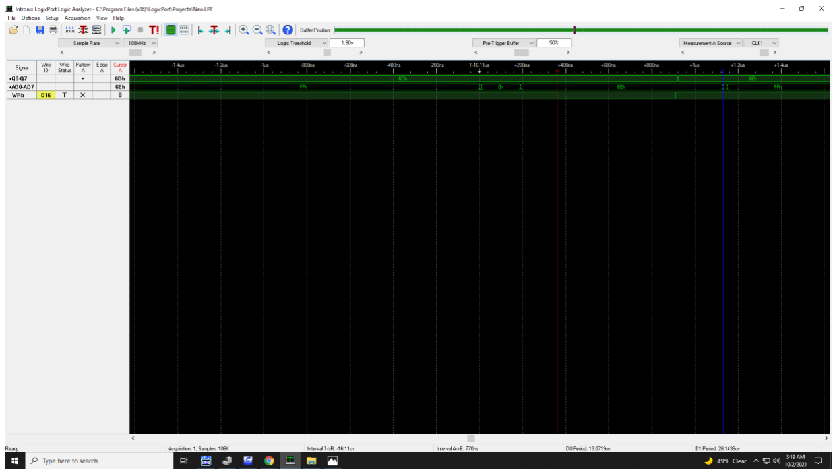
[picture p81: figure]

Propagation Delay in Main function

Setup Time in ISR

Hold Time in ISR

Propagation Delay in ISR
