dhirajbennadi/RemoteInterfacingWith8051/Labs/Dhiraj/bennadi_lab_3/lab_writeup/SignOffSheets.pdf

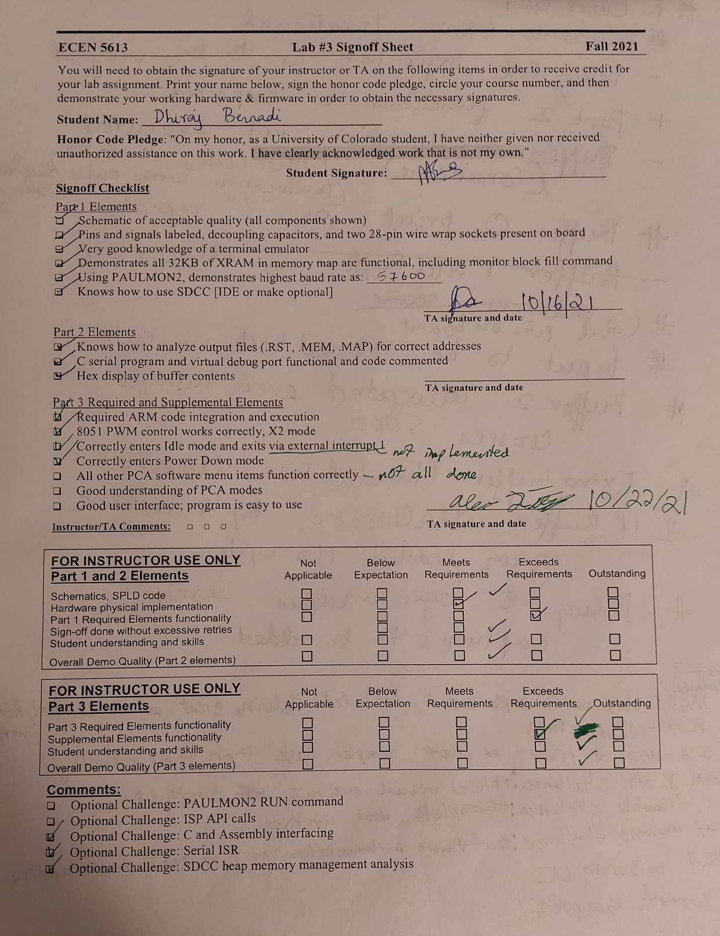
[picture p82: page 1]
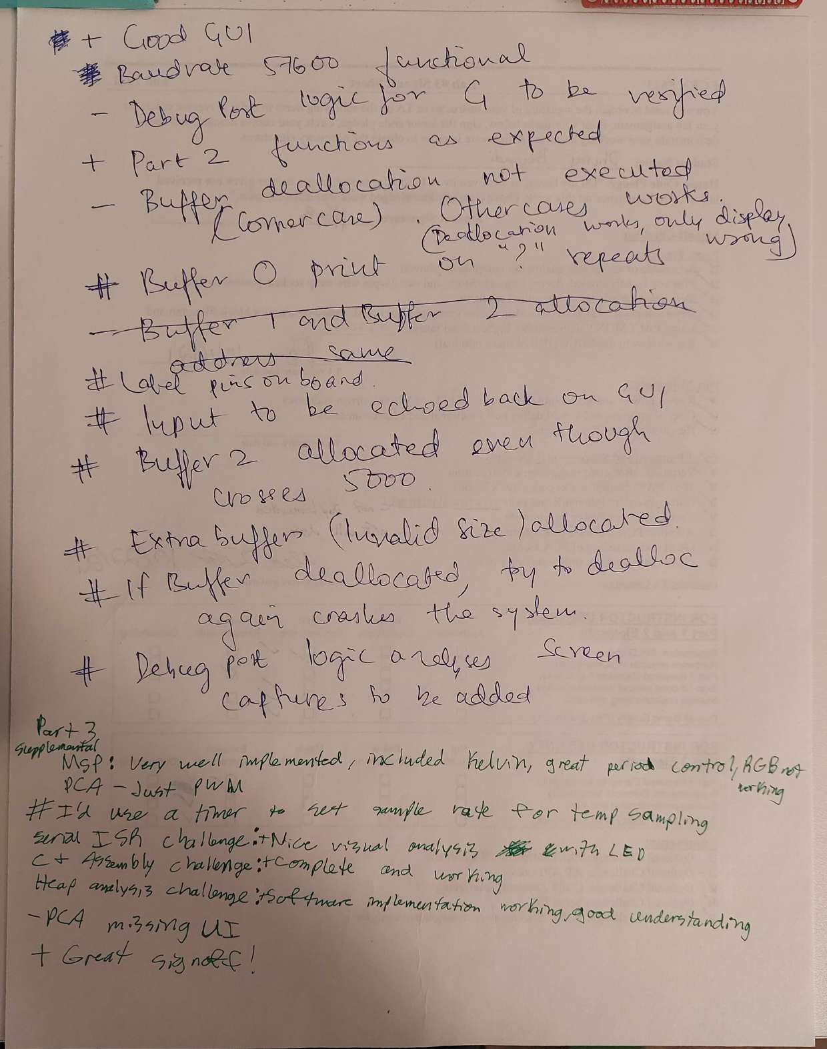
[picture p83: page 2]
