dhirajbennadi/RemoteInterfacingWith8051/Pictures/20211206_050732.jpg

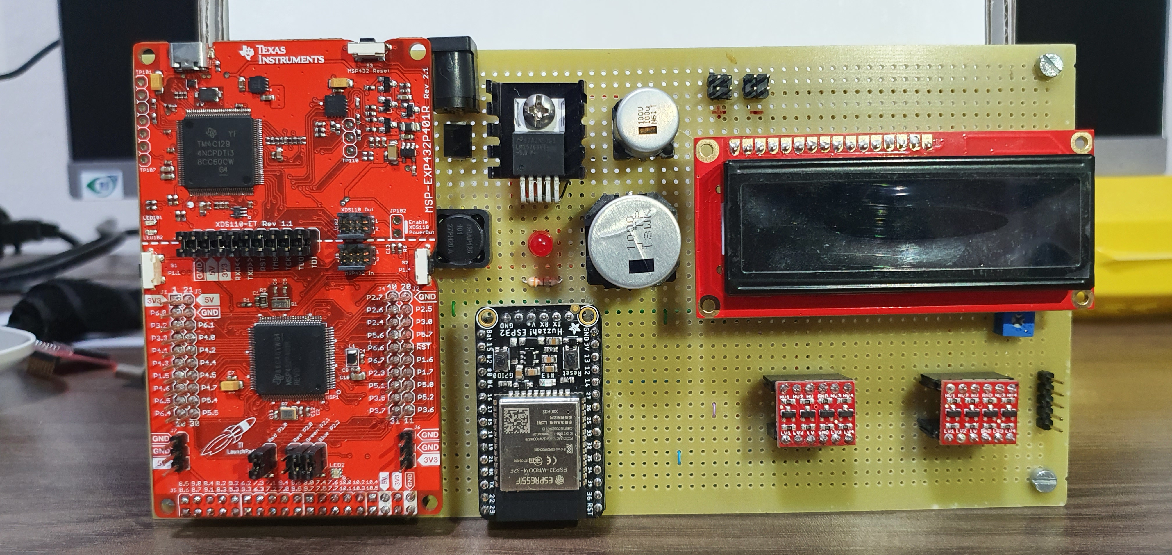
Pictures/20211206_050732.jpg
