dhirajbennadi/RemoteInterfacingWith8051/Pictures/Dhiraj/Board/Bottom.jpeg

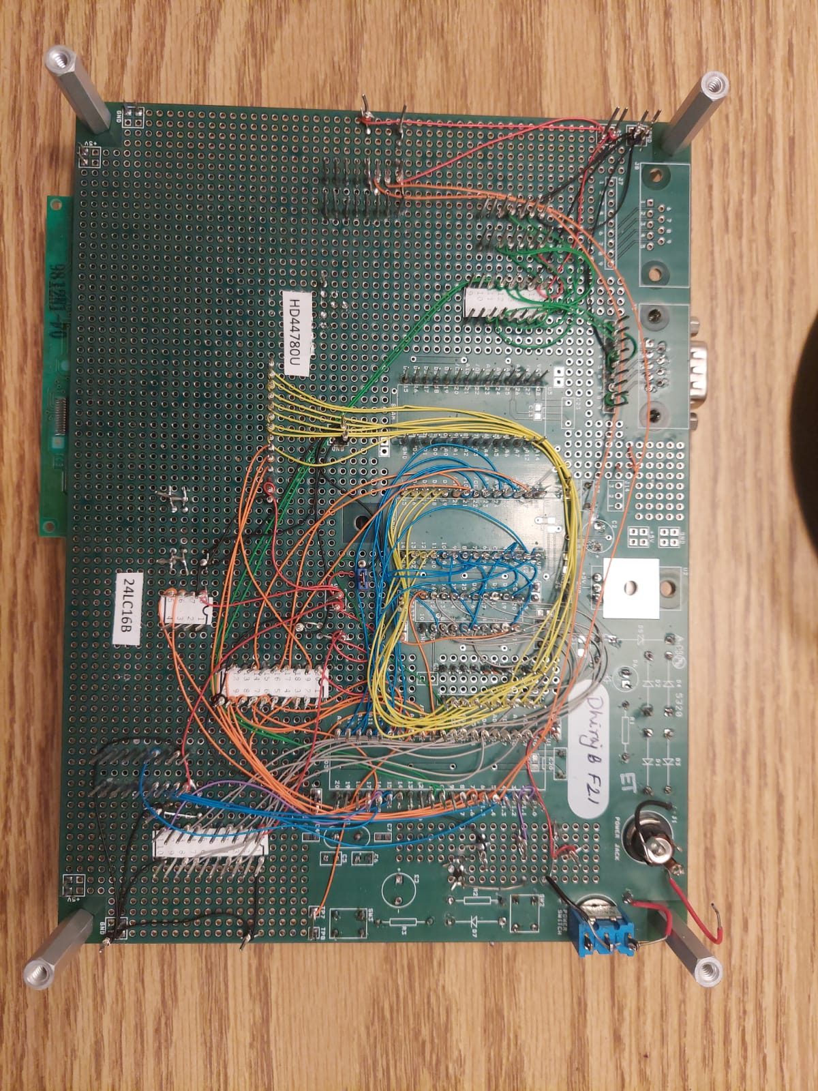
Pictures/Dhiraj/Board/Bottom.jpeg
