dhirajbennadi/RemoteInterfacingWith8051/Pictures/Dhiraj/Board/Top.jpeg

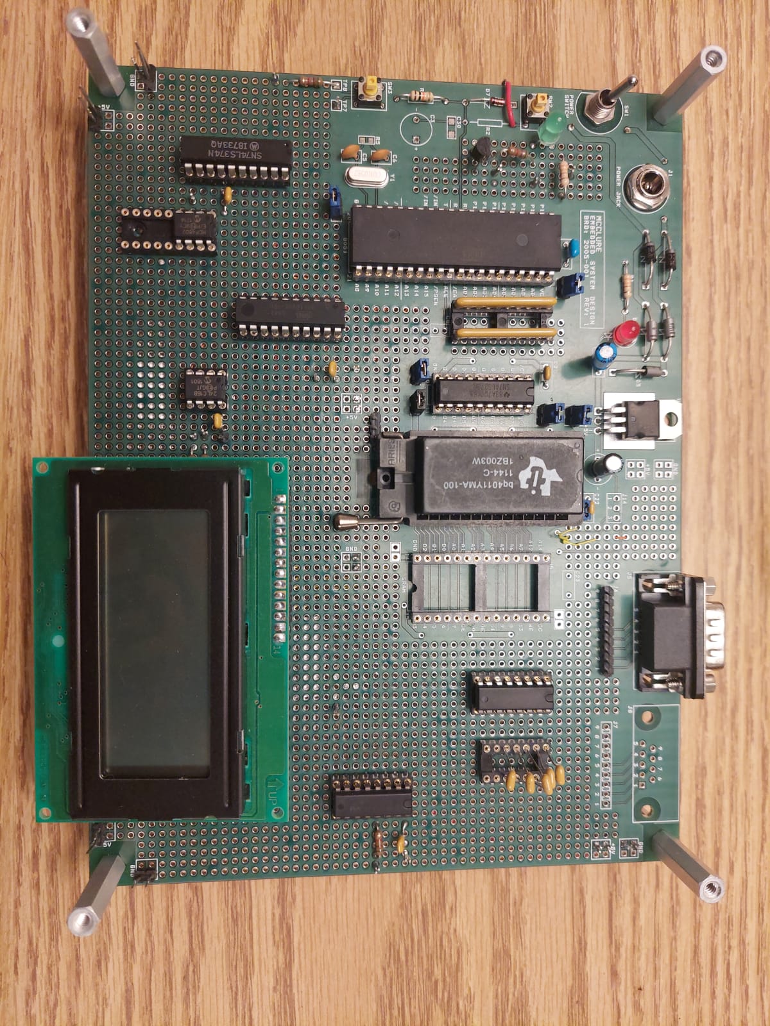
Pictures/Dhiraj/Board/Top.jpeg
