dhirajbennadi/RemoteInterfacingWith8051/Pictures/Dhiraj/ScreenshotsLab3/AleMinFrequency.png

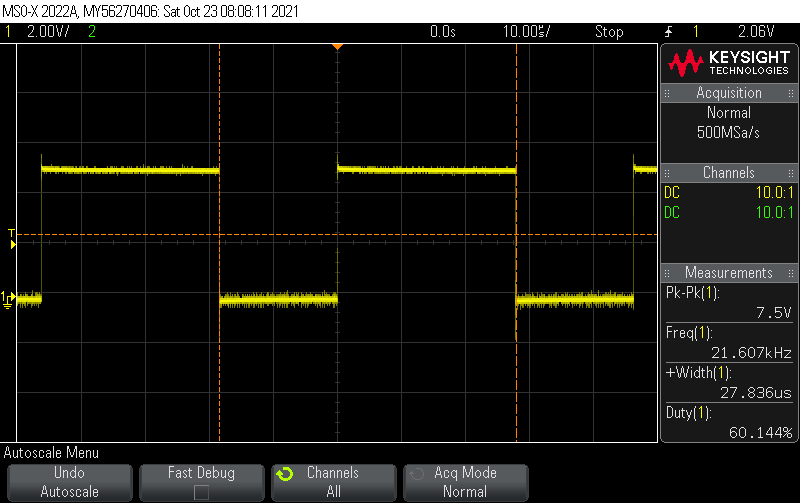
Pictures/Dhiraj/ScreenshotsLab3/AleMinFrequency.png
