dhirajbennadi/RemoteInterfacingWith8051/Pictures/Dhiraj/ScreenshotsLab3/lab3p_2.png

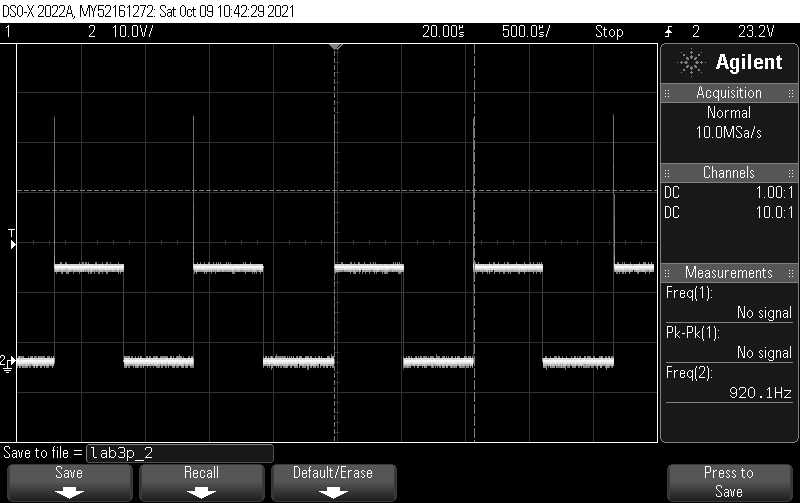
Pictures/Dhiraj/ScreenshotsLab3/lab3p_2.png
