dhirajbennadi/RemoteInterfacingWith8051/Pictures/Dhiraj/ScreenshotsLab4/ClockFrequency.JPG

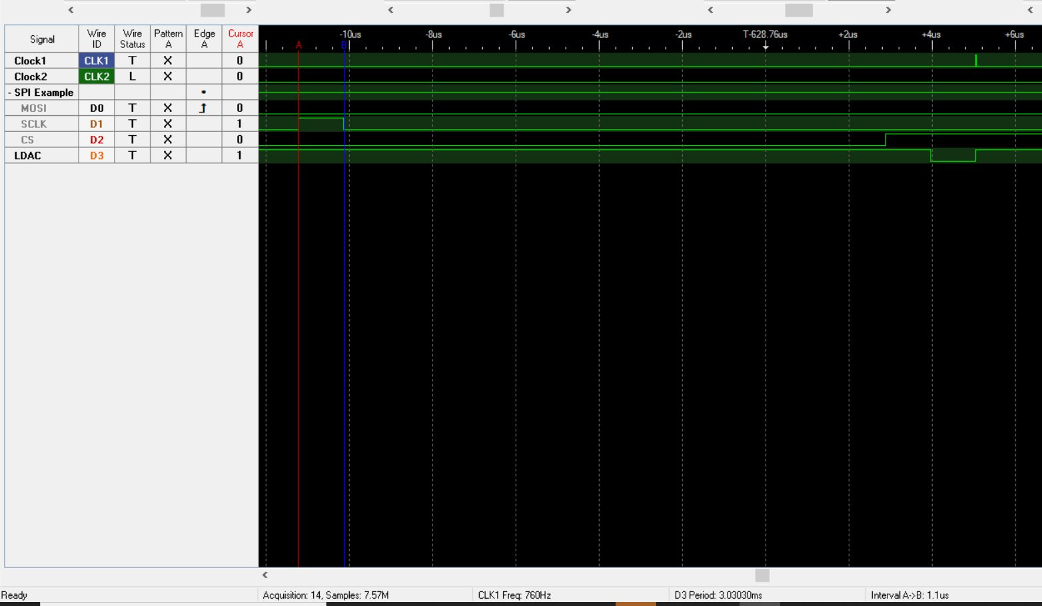
Pictures/Dhiraj/ScreenshotsLab4/ClockFrequency.JPG
