dhirajbennadi/RemoteInterfacingWith8051/Pictures/Dhiraj/ScreenshotsLab4/CSFalltoFirstRisingClock_tcssr.JPG

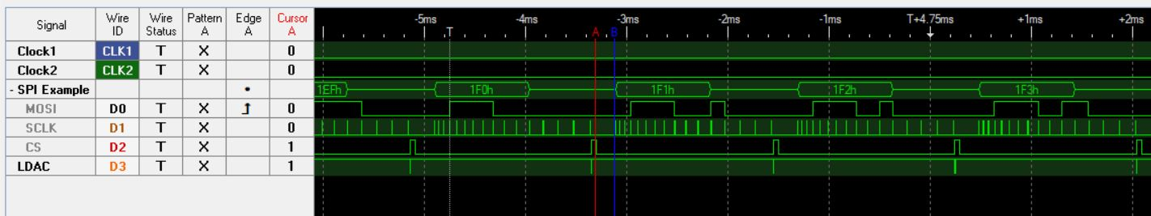
Pictures/Dhiraj/ScreenshotsLab4/CSFalltoFirstRisingClock_tcssr.JPG
