dhirajbennadi/RemoteInterfacingWith8051/Pictures/Dhiraj/ScreenshotsLab4/I2CTimingReference.JPG

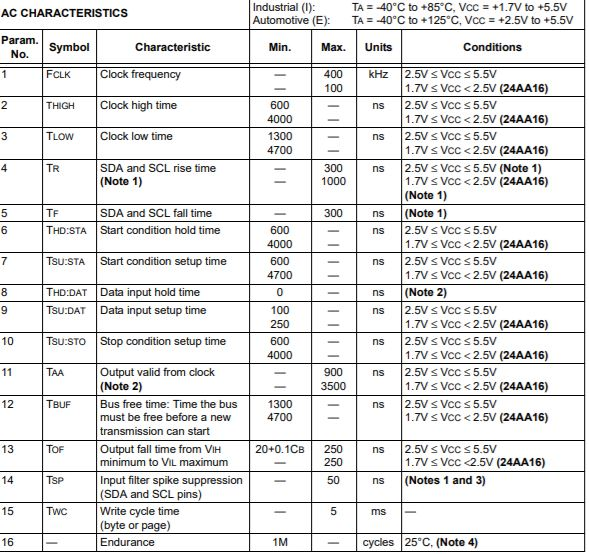
Pictures/Dhiraj/ScreenshotsLab4/I2CTimingReference.JPG
