dhirajbennadi/RemoteInterfacingWith8051/Pictures/Dhiraj/ScreenshotsLab4/LCD_DDRAMDumpLCDScreen.JPG

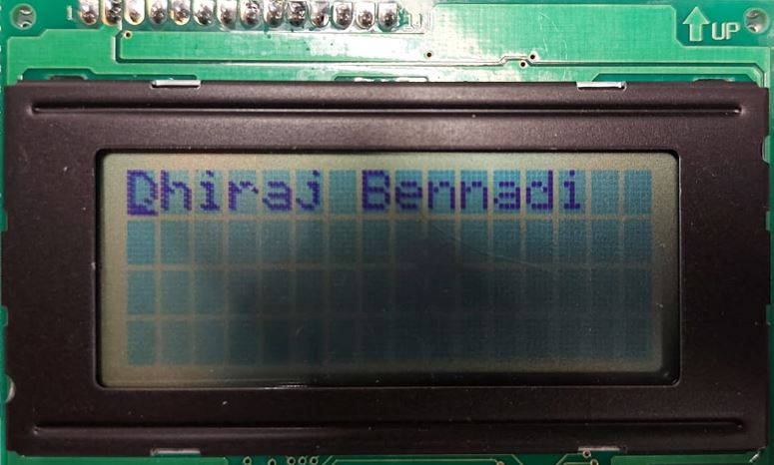
Pictures/Dhiraj/ScreenshotsLab4/LCD_DDRAMDumpLCDScreen.JPG
