dhirajbennadi/RemoteInterfacingWith8051/Pictures/Dhiraj/ScreenshotsLab4/LCDCGRAM.JPG

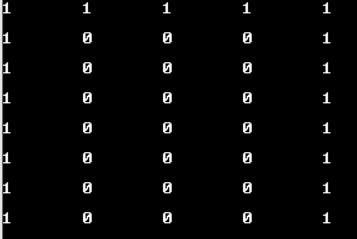
Pictures/Dhiraj/ScreenshotsLab4/LCDCGRAM.JPG
