dhirajbennadi/RemoteInterfacingWith8051/Pictures/Dhiraj/ScreenshotsLab4/LCDCustomCharacterLCDScreen.JPG

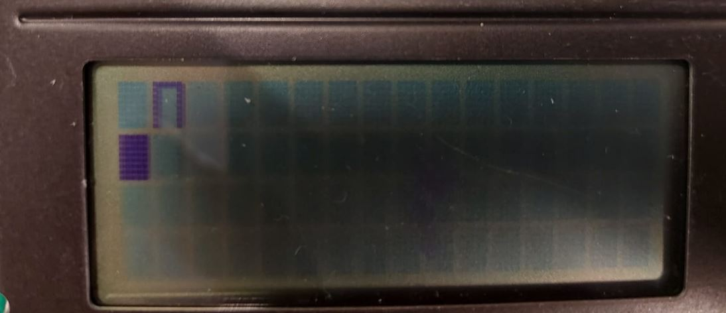
Pictures/Dhiraj/ScreenshotsLab4/LCDCustomCharacterLCDScreen.JPG
