dhirajbennadi/RemoteInterfacingWith8051/Pictures/Dhiraj/ScreenshotsLab4/LCDTimingAnalysisReference.JPG

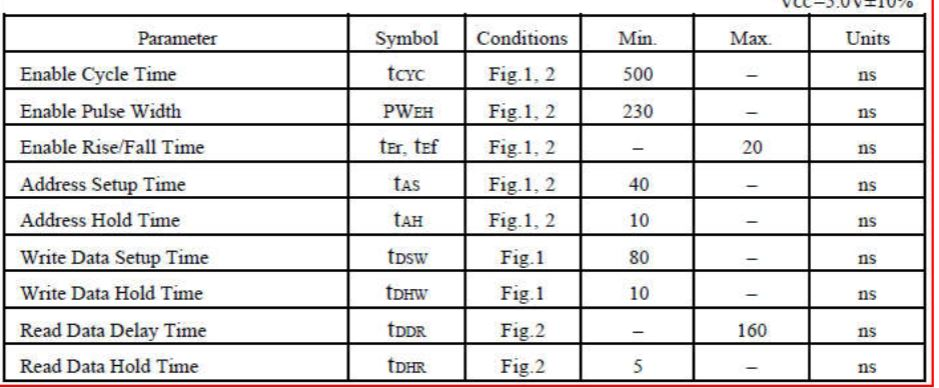
Pictures/Dhiraj/ScreenshotsLab4/LCDTimingAnalysisReference.JPG
