dhirajbennadi/RemoteInterfacingWith8051/Pictures/Dhiraj/ScreenshotsLab4/SawToothWaveform.png

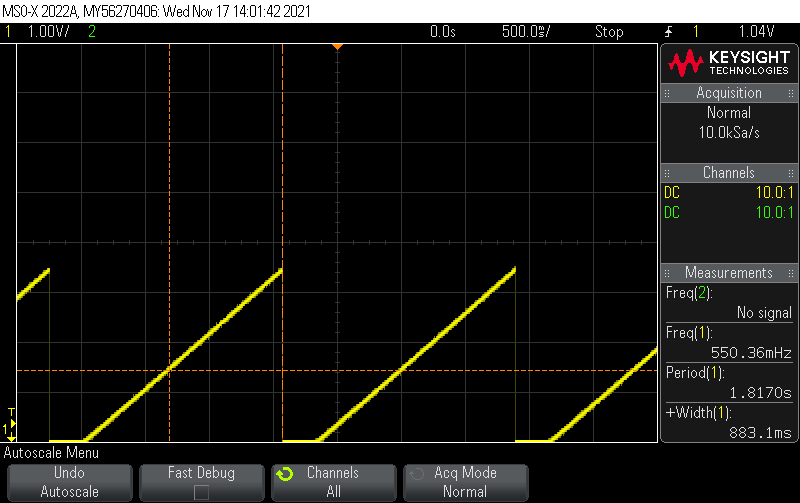
Pictures/Dhiraj/ScreenshotsLab4/SawToothWaveform.png
