dhirajbennadi/RemoteInterfacingWith8051/Pictures/Dhiraj/ScreenshotsLab4/SCKRisetoCSRise_tchs.JPG

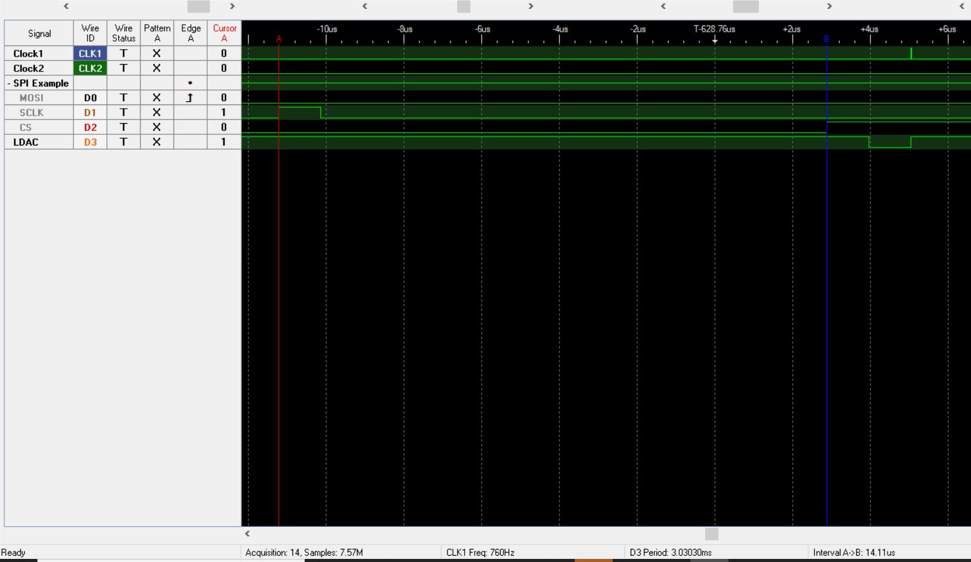
Pictures/Dhiraj/ScreenshotsLab4/SCKRisetoCSRise_tchs.JPG
