dhirajbennadi/RemoteInterfacingWith8051/Pictures/Dhiraj/ScreenshotsLab4/SPIClock.JPG

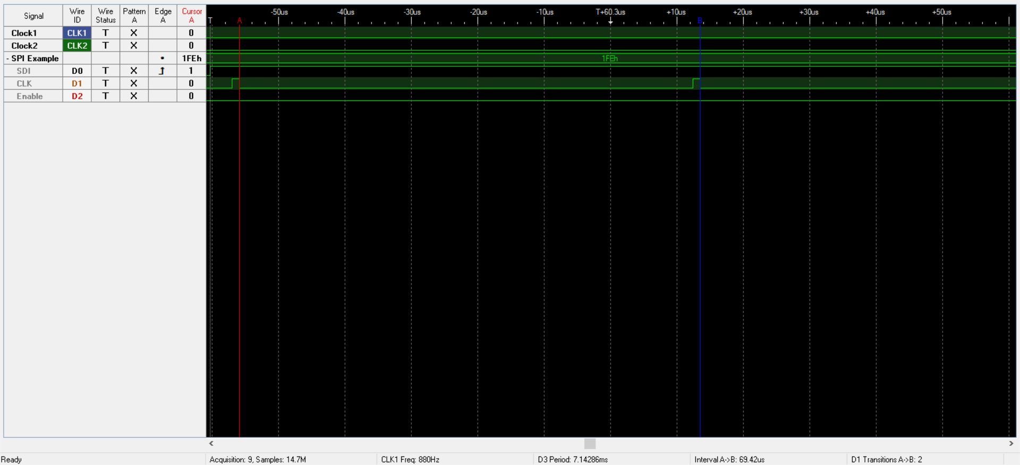
Pictures/Dhiraj/ScreenshotsLab4/SPIClock.JPG
