dhirajbennadi/RemoteInterfacingWith8051/Pictures/Dhiraj/ScreenshotsLab4/SPILogicAnalyzer2.JPG

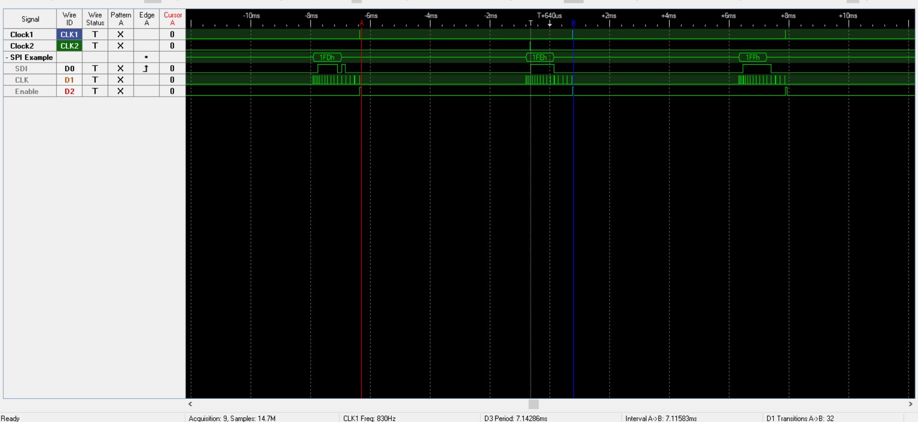
Pictures/Dhiraj/ScreenshotsLab4/SPILogicAnalyzer2.JPG
