dhirajbennadi/RemoteInterfacingWith8051/Pictures/Dhiraj/ScreenshotsLab4/SPILogicAnalyzer.JPG

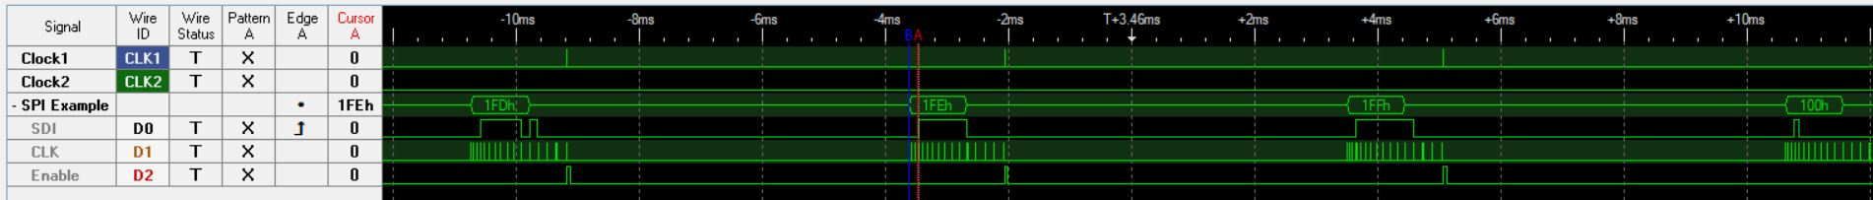
Pictures/Dhiraj/ScreenshotsLab4/SPILogicAnalyzer.JPG
