dhirajbennadi/RemoteInterfacingWith8051/Pictures/power supply analysis1.JPG

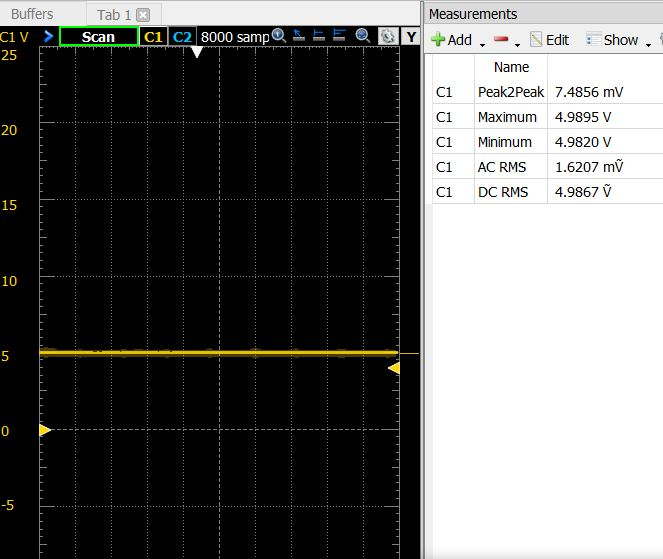
Pictures/power supply analysis1.JPG
