dhirajbennadi/RemoteInterfacingWith8051/Pictures/Rajat/Board/Top.jpg

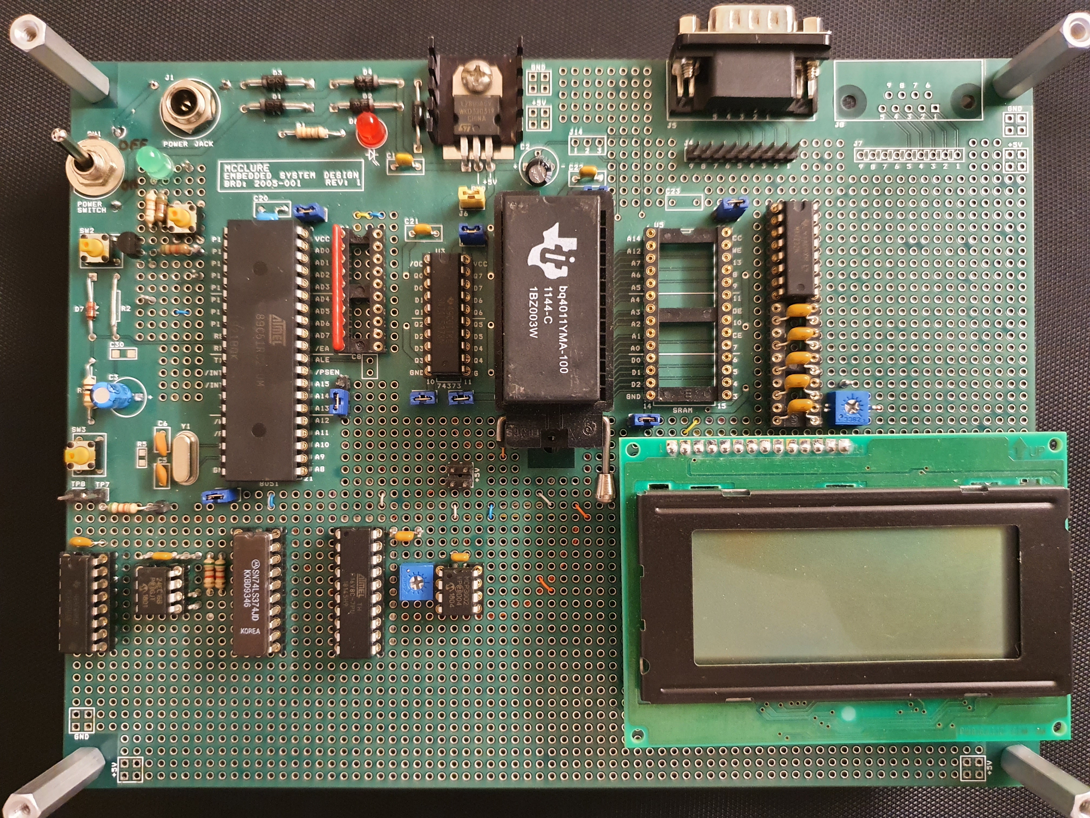
Pictures/Rajat/Board/Top.jpg
