dhirajbennadi/RemoteInterfacingWith8051/Pictures/Rajat/chaple_lab_1/ALE freq.png

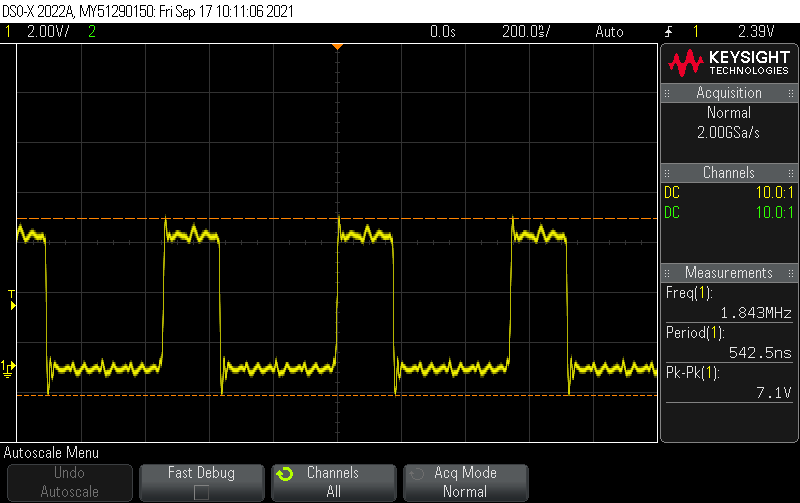
Pictures/Rajat/chaple_lab_1/ALE freq.png
