dhirajbennadi/RemoteInterfacingWith8051/Pictures/Rajat/chaple_lab_1/CSPERPH.PNG

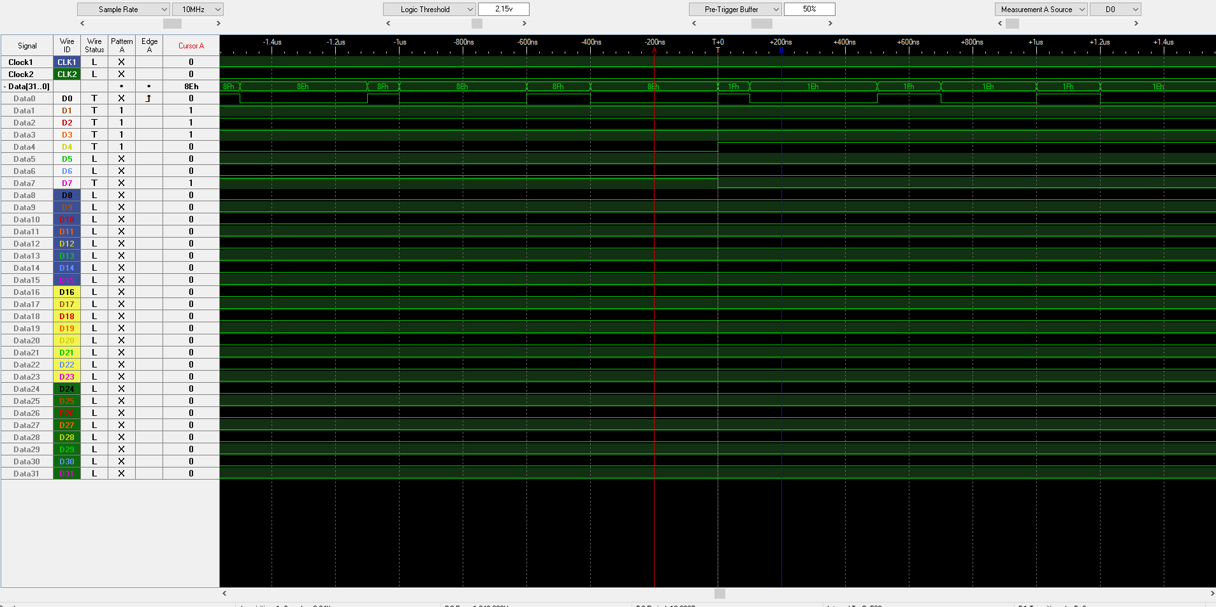
Pictures/Rajat/chaple_lab_1/CSPERPH.PNG
