dhirajbennadi/RemoteInterfacingWith8051/Pictures/Rajat/chaple_lab_1/duty cycle.PNG

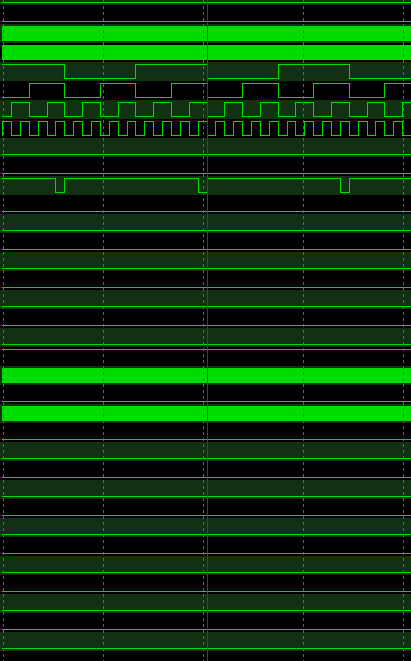
Pictures/Rajat/chaple_lab_1/duty cycle.PNG
