dhirajbennadi/RemoteInterfacingWith8051/Pictures/Rajat/chaple_lab_1/Pogram memory.JPG

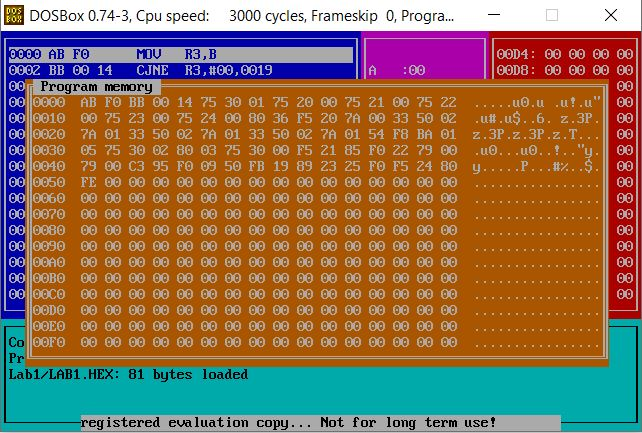
Pictures/Rajat/chaple_lab_1/Pogram memory.JPG
