dhirajbennadi/RemoteInterfacingWith8051/Pictures/Rajat/chaple_lab_1/proc top.png

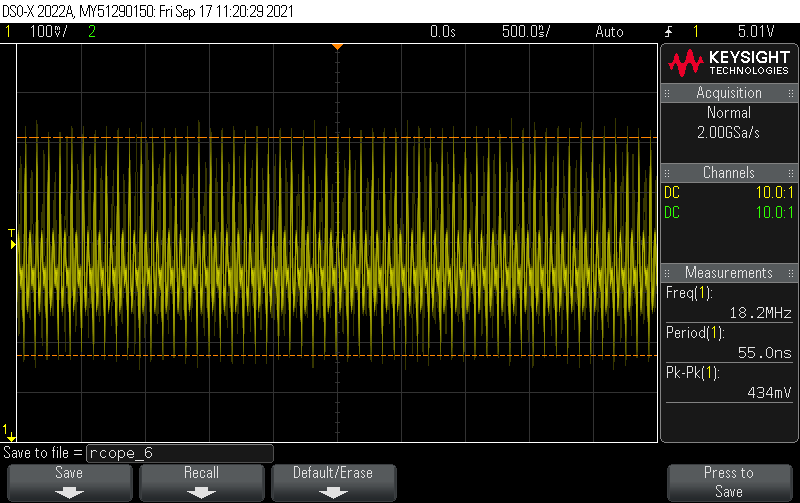
Pictures/Rajat/chaple_lab_1/proc top.png
