dhirajbennadi/RemoteInterfacingWith8051/Pictures/Rajat/chaple_lab_1/prog memory size.jpg

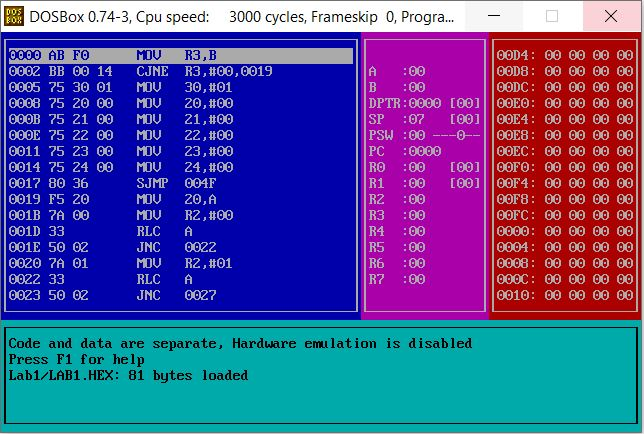
Pictures/Rajat/chaple_lab_1/prog memory size.jpg
