dhirajbennadi/RemoteInterfacingWith8051/Pictures/Rajat/chaple_lab_1/Vout.jpg

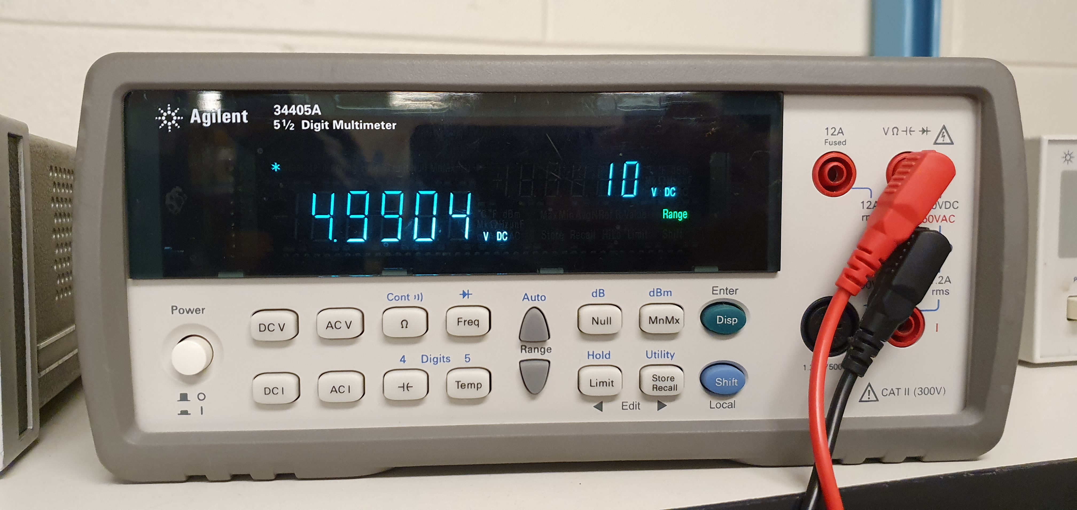
Pictures/Rajat/chaple_lab_1/Vout.jpg
