dhirajbennadi/RemoteInterfacingWith8051/Pictures/Rajat/chaple_lab_3/heap alloc.JPG

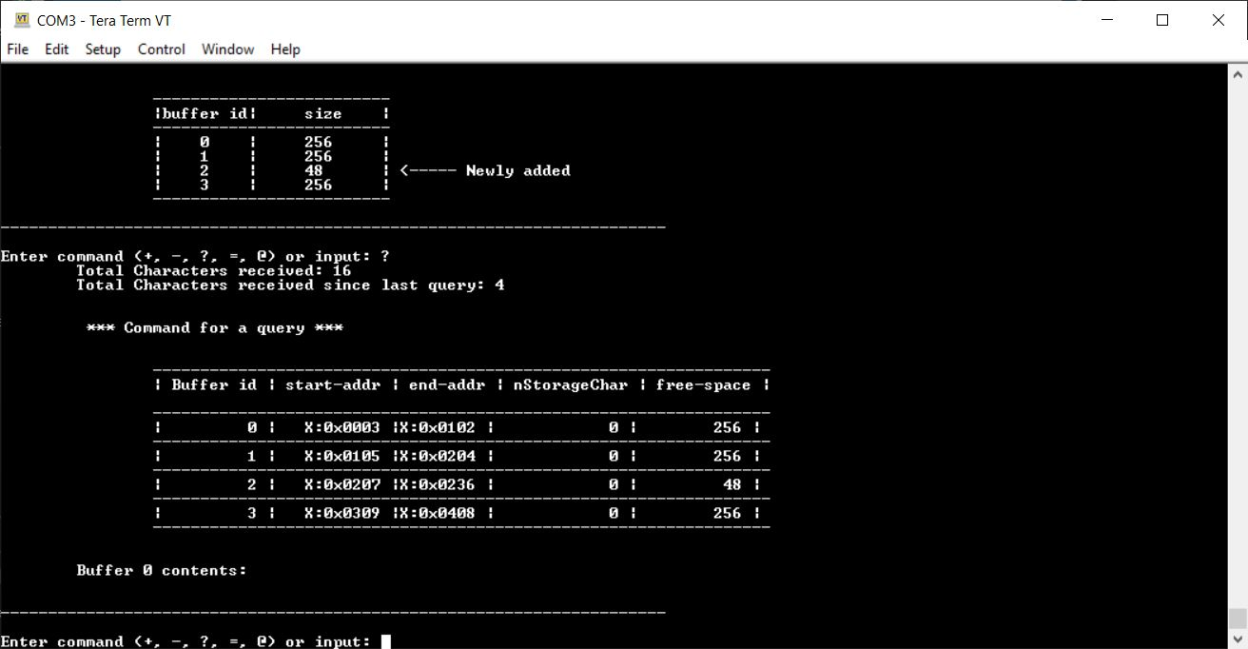
Pictures/Rajat/chaple_lab_3/heap alloc.JPG
