dhirajbennadi/RemoteInterfacingWith8051/Pictures/Rajat/chaple_lab_3/pwm 55.JPG

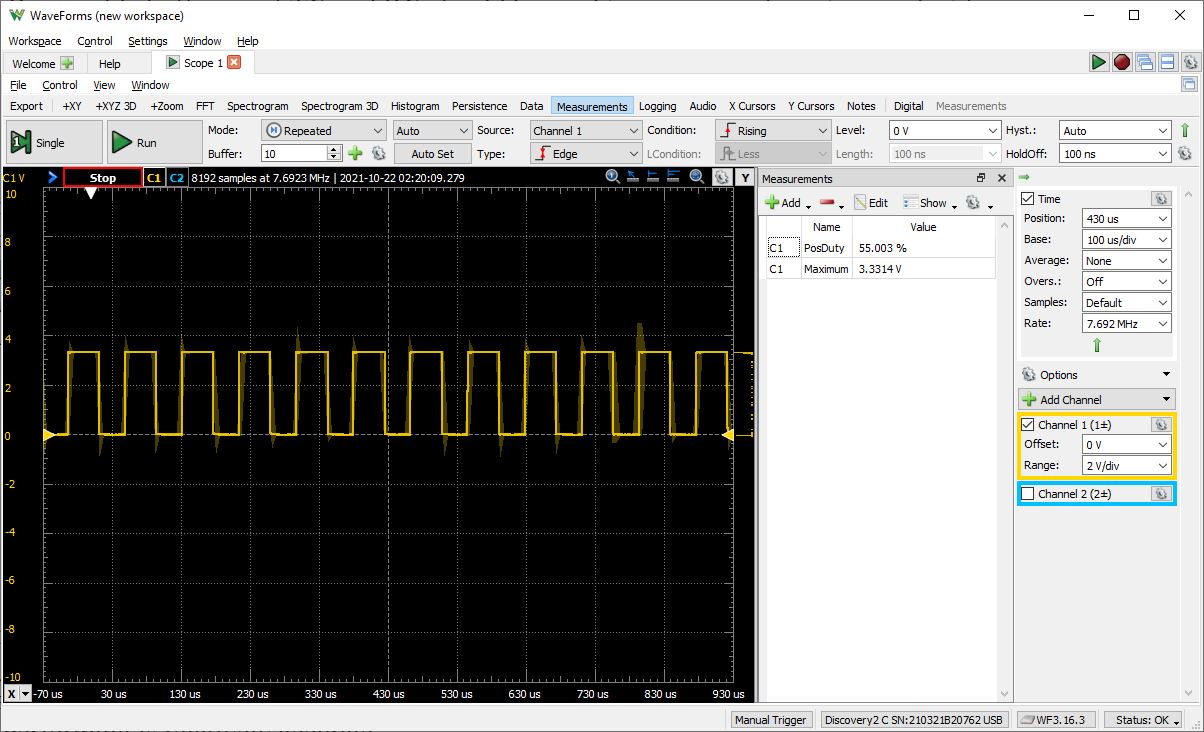
Pictures/Rajat/chaple_lab_3/pwm 55.JPG
