dhirajbennadi/RemoteInterfacingWith8051/Pictures/Rajat/chaple_lab_3/sign_off_sheet_b.jpg

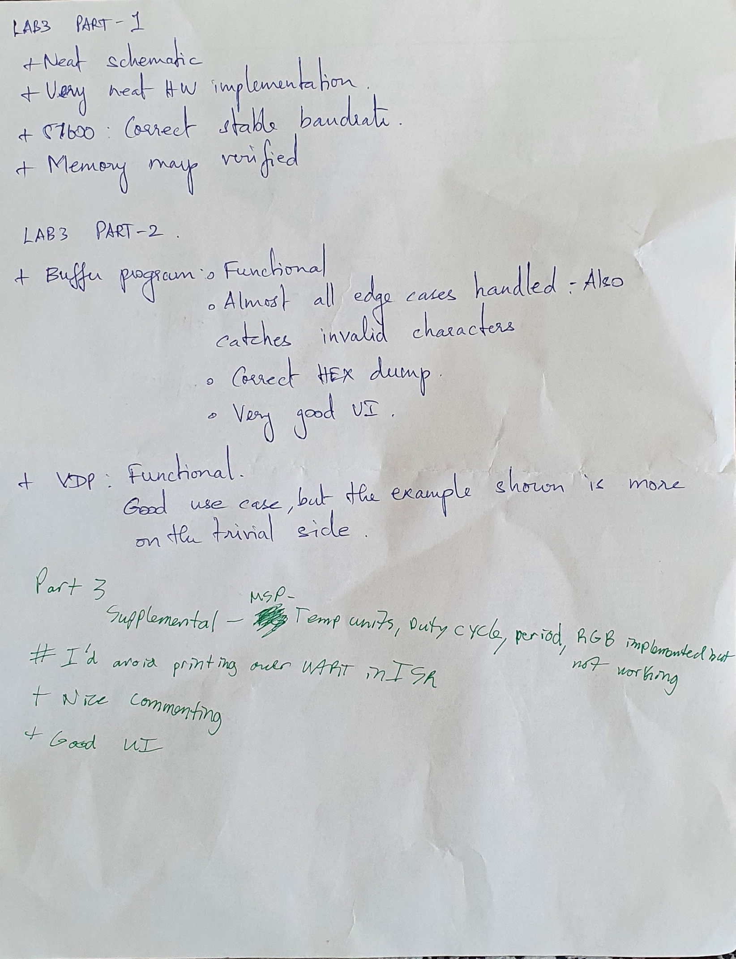
Pictures/Rajat/chaple_lab_3/sign_off_sheet_b.jpg
