dhirajbennadi/RemoteInterfacingWith8051/Labs/Rajat/chaple_lab_1/lab_writeup/useful utilities/Test_lab1_esd.xlsx

Sheet: Sheet1
 |  |  |  |  | X | X*8 | Y | Z | Remainder | Error
Decimal X (i/p) |  | Decimal Y (i/p) | Decimal Z |  | 0x20 | 0x21 | 0x22 | 0x23 | 0x24 | 0x30
A | A*8 | B | Q | R | A hex | A*8 Hex | B Hex | Q Hex | R Hex | Error
16 | 128 | 10 | 12 | 8 | 10 | 80 | A | C | 8 | 0
25 | 200 | 244 | 0 | 200 | 19 | C8 | F4 | 0 | C8 | 0
127 | 1016 | 135 | 1 | 113 | 7F | 3F8 | 87 | 1 | 71 | 2
12 | 96 | 11 | 8 | 8 | C | 60 | B | 8 | 8 | 0
39 | 312 | 19 | 2 | 18 | 27 | 138 | 13 | 2 | 12 | 2
28 | 224 | 23 | 9 | 17 | 1C | E0 | 17 | 9 | 11 | 0
225 | 1800 | 75 | 0 | 8 | E1 | 708 | 4B | 0 | 8 | 2
225 | 1800 | 3 | 2 | 2 | E1 | 708 | 3 | 2 | 2 | 2
13 | 104 | 0 | #DIV/0! | #DIV/0! | D | 68 | 0 | #DIV/0! | #DIV/0! | 1
8 | 64 | 7 | 9 | 1 | 8 | 40 | 7 | 9 | 1 | 0
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
