dhirajbennadi/RemoteInterfacingWith8051/Pictures/Rajat/chaple_lab_3/char a debugport.JPG

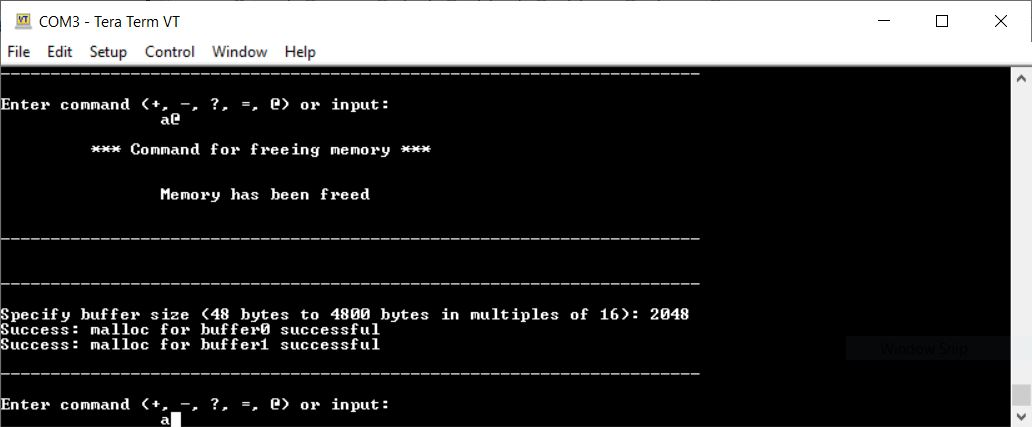
Pictures/Rajat/chaple_lab_3/char a debugport.JPG
