dhirajbennadi/RemoteInterfacingWith8051/Schematics/esd_fall_project rev3.pdf

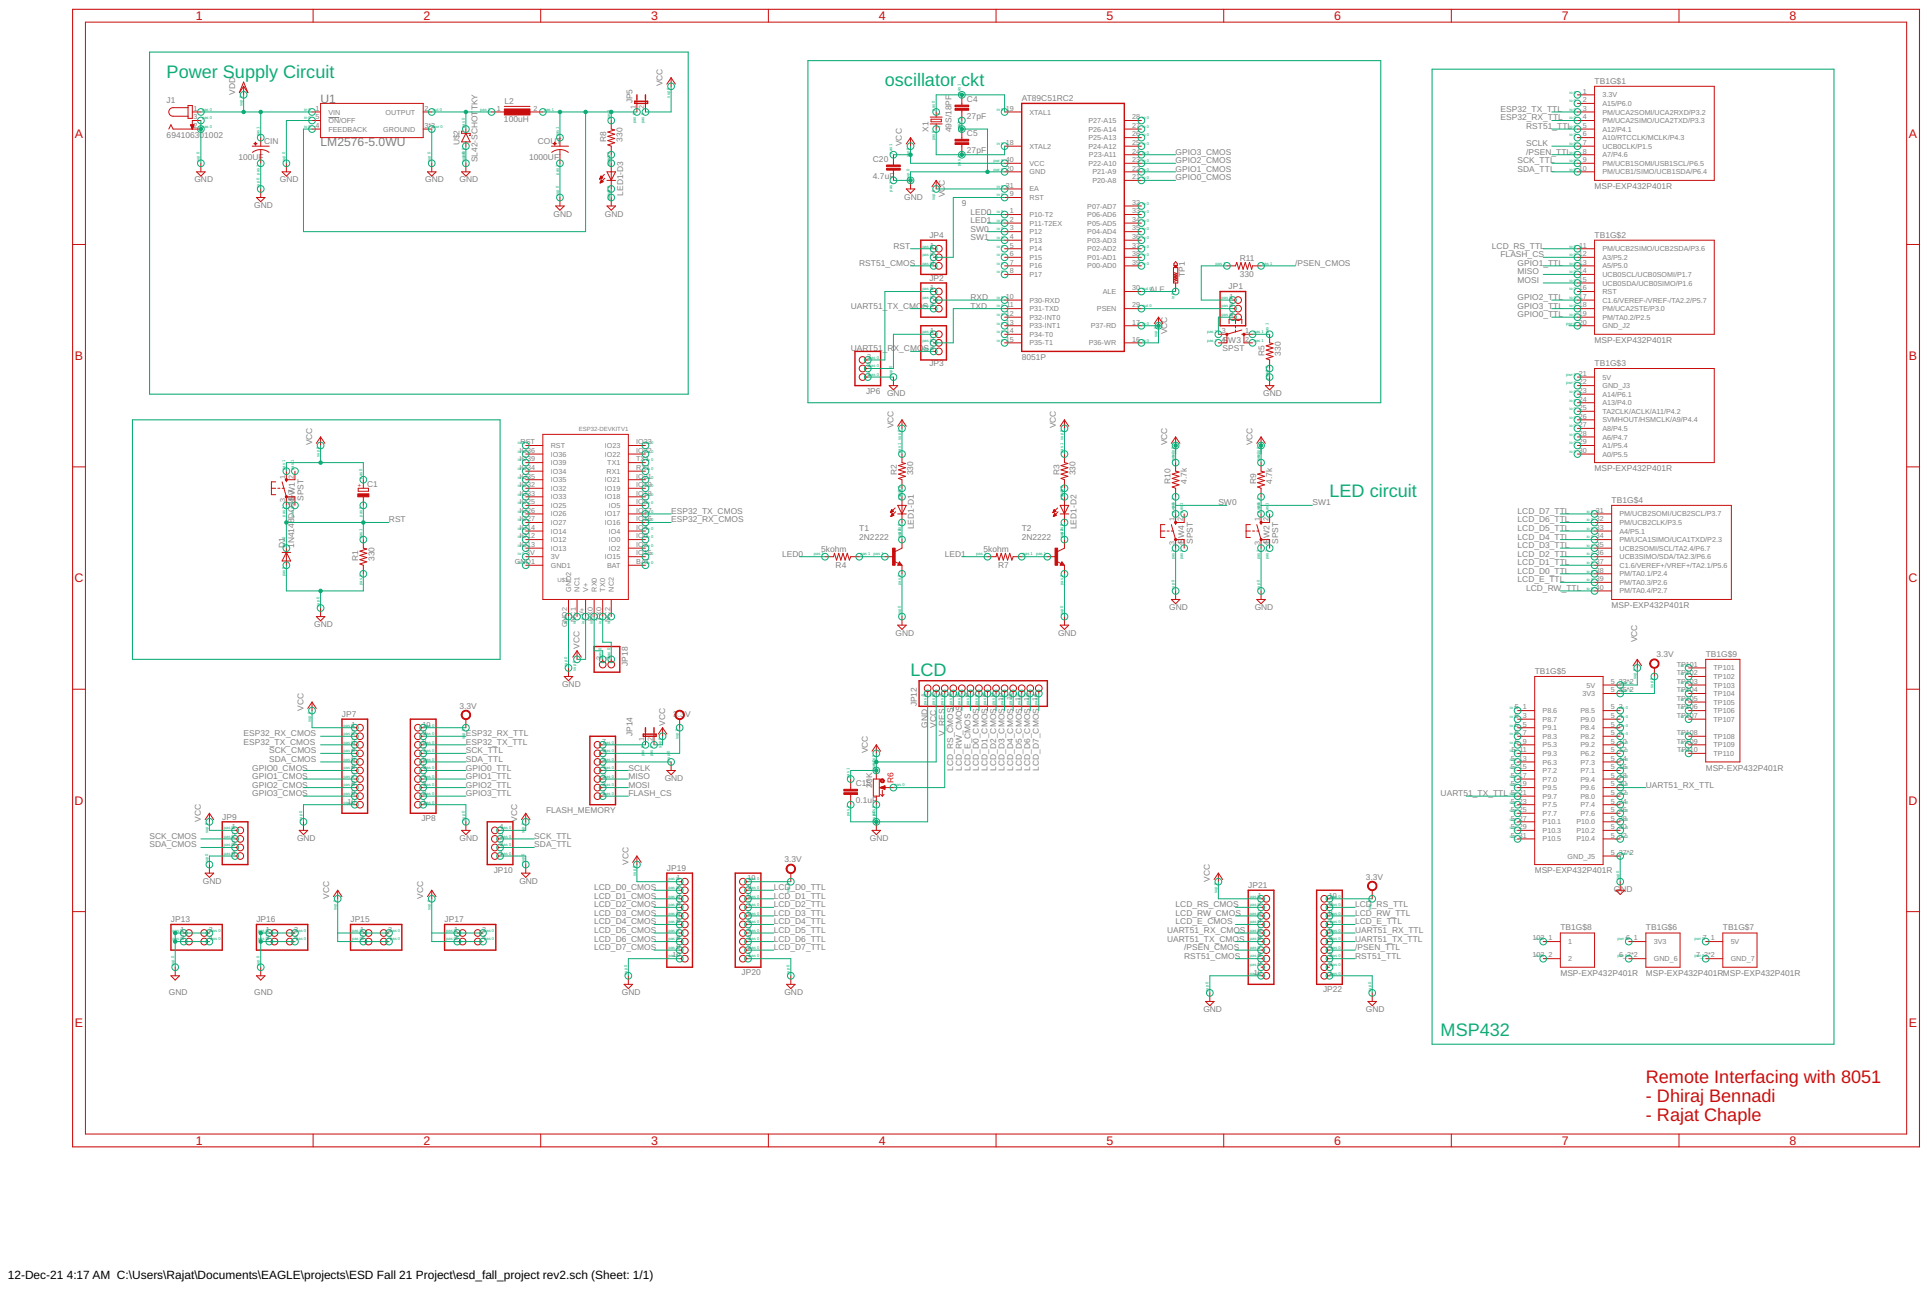
[picture p117: page 1]

pas 1 pas 1

pas 0 pas 0 pas 1 pas 1 sup 0

pas 3 pas 2 sup 0 sup 0

pas 1 pas 1 pas 0 pas 0

pas 1 pas 1 sup 0 sup 0

sup 0 sup 0 pas 0 pas 0

Remote Interfacing with 8051
- Dhiraj Bennadi - Rajat Chaple

12-Dec-21 4:17 AM C:\Users\Rajat\Documents\EAGLE\projects\ESD Fall 21 Project\esd_fall_project rev2.sch (Sheet: 1/1)
