dhirajbennadi/RemoteInterfacingWith8051/Layout/esd_fall_project rev3.brd

## EAGLE design Layout/esd_fall_project rev3.brd (2022-02-01)

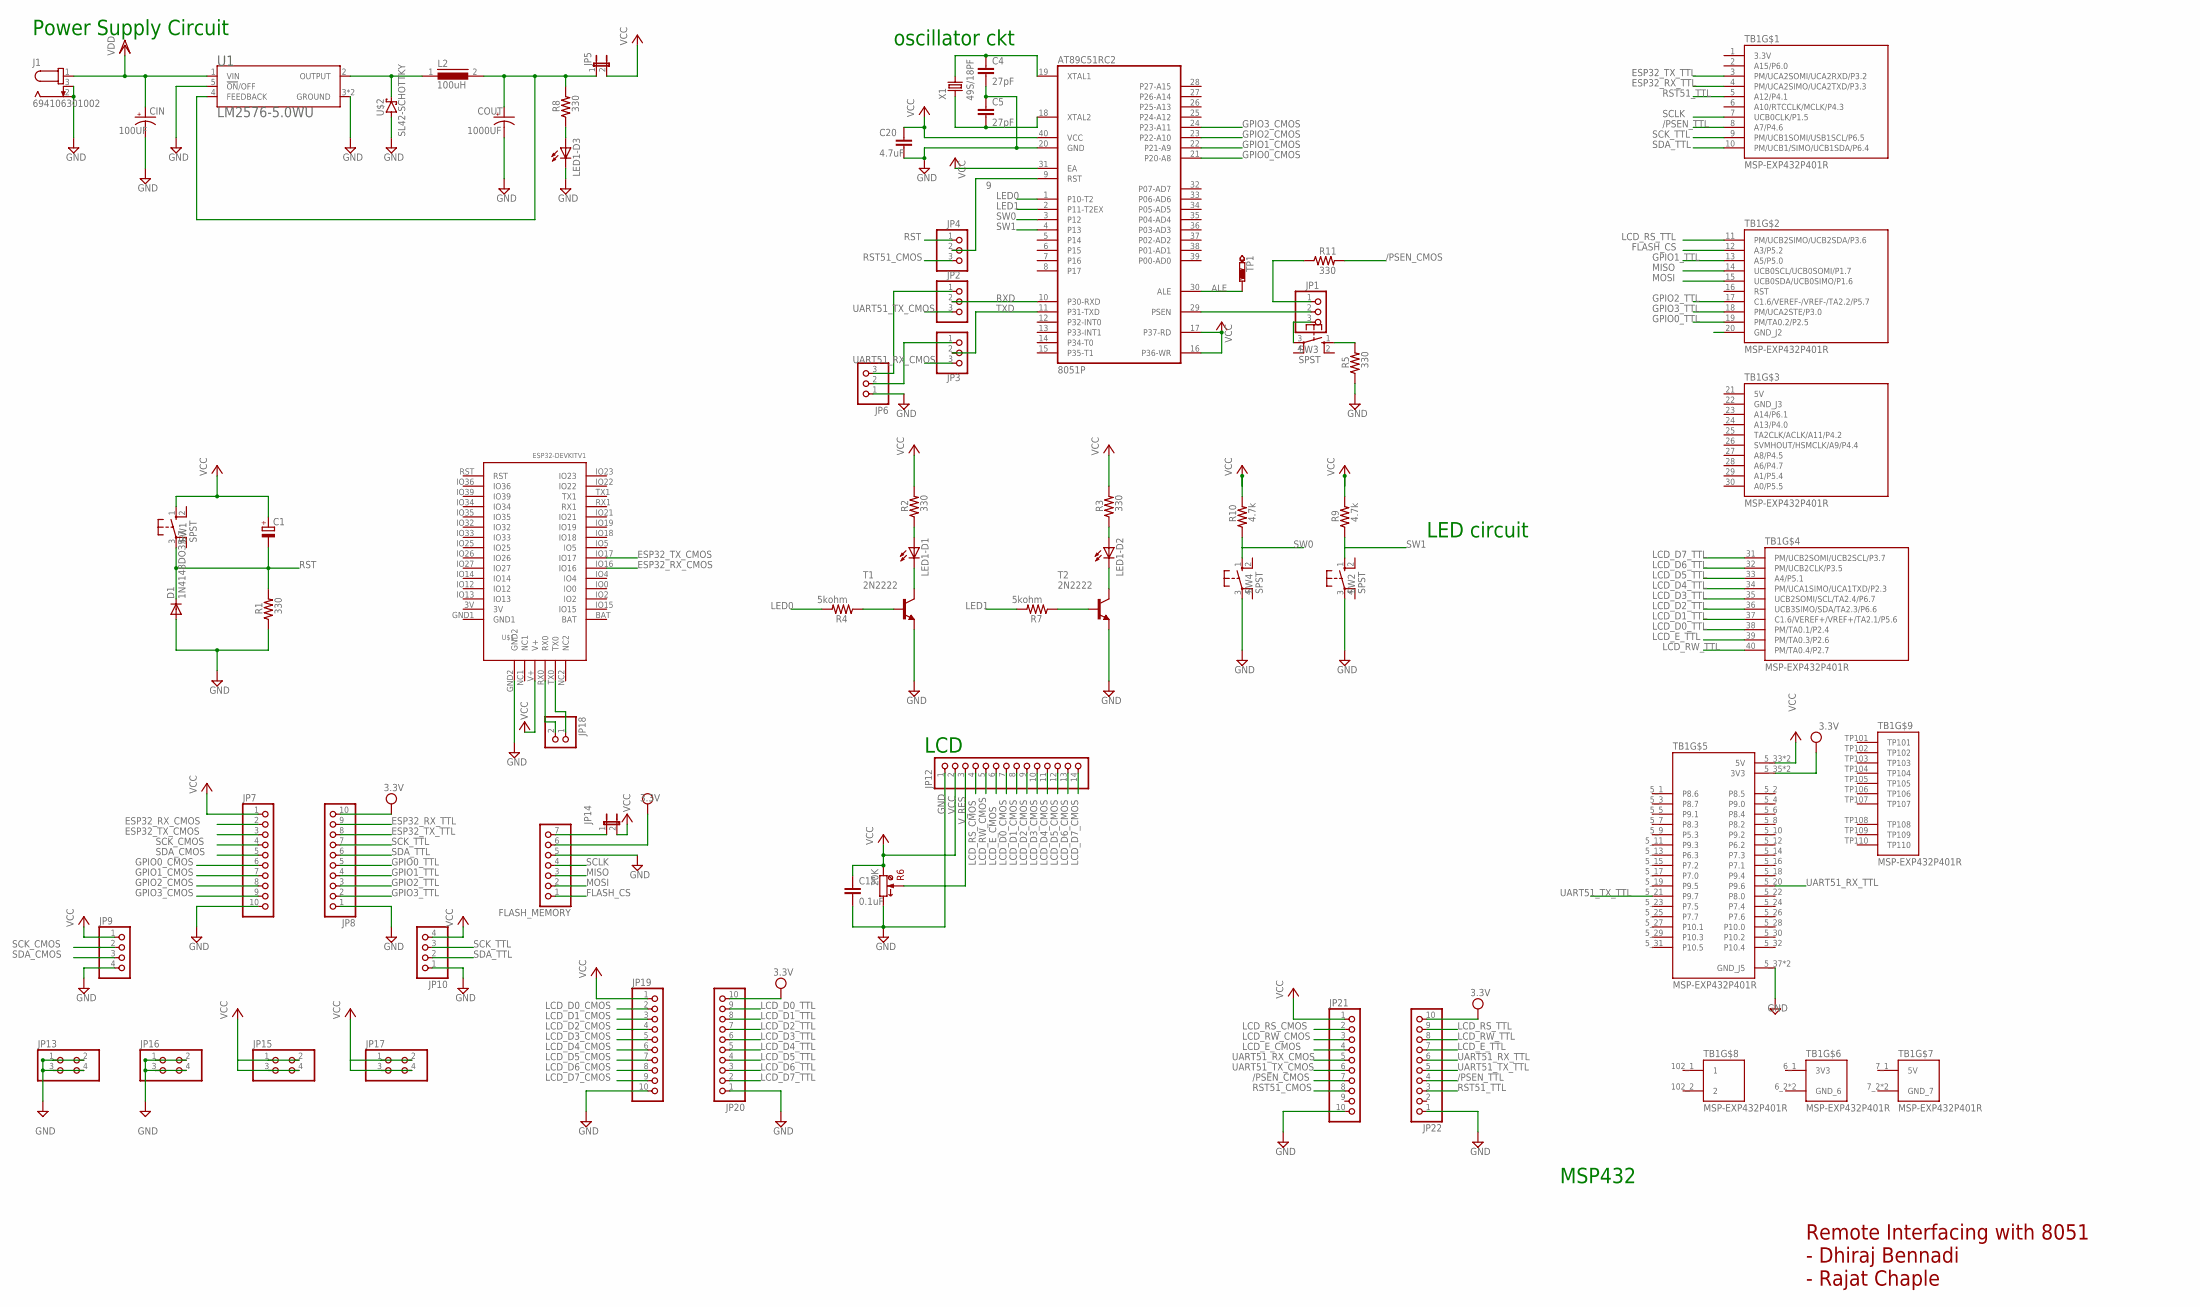
[picture p118: schematic esd_fall_project rev3.sch]

Parts:
AT89C51RC2: 8051P; DIL40
C1: CPOL-EUE1.8-4; E1,8-4
C4, C5: 27pF; C2.5-3
C15: 0.1uF; C2.5-3
C20: 4.7uF; C2.5-3
CIN: 100UF; 153CLV-1014
COUT: 1000UF; 150CLZ-1010
D1: 1N4148DO35-7; DO35-7
FLASH_MEMORY: PINHD-1X7; 1X07
J1: 694106301002
JP1, JP2, JP3, JP4, JP6: PINHD-1X3; 1X03
JP5, JP14: JP1E; JP1
JP7, JP8, JP19, JP20, JP21, JP22: PINHD-1X10; 1X10
JP9, JP10: PINHD-1X4; 1X04
JP12: PINHD-1X14; 1X14
JP13, JP15, JP16, JP17: PINHD-2X2; 2X02
JP18: PINHD-1X2; 1X02
L2: 100uH; DR127
LED1-D1, LED1-D2, LED1-D3: LED5MM
R1, R2, R3, R5, R8, R11: 330; 0204/7
R4, R7: 5kohm; 0204/7
R6: 20K; 64W
R9, R10: 4.7k; 0204/7
SW1, SW2, SW3, SW4: SPST; B3F-10XX; MPN B3F-1000
T1, T2: 2N2222; TO18
TB1: MSP-EXP432P401R; SHIELD_MSP-EXP432P401R
TP1: PTR1B2,54; B2,54
U1: LM2576-5.0WU; DPAK6P170_1524X459L254X81N
U$1: ESP32DEVKITV1; ESP32-DEVKITV1
U$2: SL42-SCHOTTKY; SMC
X1: 49S/18PF; XTAL_HC49

Connections:
3.3V: JP8.10, JP20.10, JP22.10
3V3: TB1.6_1 (3V3)
5V: TB1.7_1 (5V), TB1.21 (5V)
9: AT89C51RC2.9 (RST), JP4.2
/PSEN_CMOS: JP21.7, R11.2
/PSEN_TTL: JP22.4, TB1.8 (A7/P4.6)
ALE: AT89C51RC2.30 (ALE), TP1.TP
ESP32_RX_CMOS: JP7.2, U$1.IO16
ESP32_RX_TTL: JP8.9, TB1.4 (PM/UCA2SIMO/UCA2TXD/P3.3)
ESP32_TX_CMOS: JP7.3, U$1.IO17
ESP32_TX_TTL: JP8.8, TB1.3 (PM/UCA2SOMI/UCA2RXD/P3.2)
FLASH_CS: FLASH_MEMORY.1, TB1.12 (A3/P5.2)
GND: AT89C51RC2.20 (GND), C4.2, C5.1, C15.2, C20.2, CIN.-, COUT.-, D1.A, FLASH_MEMORY.5, J1.2, J1.3, JP6.1, JP7.10, JP8.1, JP9.4, JP10.1, JP12.1, JP13.1, JP13.2, JP13.3, JP13.4, JP16.1, JP16.2, JP16.3, JP16.4, JP19.10, JP20.1, JP21.10, JP22.1, LED1-D3.K (C), R1.1, R5.1, R6.3 (CW), SW2.3, SW4.3, T1.1 (E), T2.1 (E), TB1.5_37 (GND_J5), TB1.5_38 (GND_J5), U1.3 (GROUND), U1.5 (!ON!/OFF), U1.6 (GROUND), U$1.GND2, U$2.A
GND_6: TB1.6_2 (GND_6), TB1.6_3 (GND_6)
GND_7: TB1.7_2 (GND_7), TB1.7_3 (GND_7)
GND_J3: TB1.22 (GND_J3)
GPIO0_CMOS: AT89C51RC2.21 (P20-A8), JP7.6
GPIO0_TTL: JP8.5, TB1.19 (PM/TA0.2/P2.5)
GPIO1_CMOS: AT89C51RC2.22 (P21-A9), JP7.7
GPIO1_TTL: JP8.4, TB1.13 (A5/P5.0)
GPIO2_CMOS: AT89C51RC2.23 (P22-A10), JP7.8
GPIO2_TTL: JP8.3, TB1.17 (C1.6/VEREF-/VREF-/TA2.2/P5.7)
GPIO3_CMOS: AT89C51RC2.24 (P23-A11), JP7.9
GPIO3_TTL: JP8.2, TB1.18 (PM/UCA2STE/P3.0)
LCD_D0_CMOS: JP12.7, JP19.2
LCD_D0_TTL: JP20.9, TB1.38 (PM/TA0.1/P2.4)
LCD_D1_CMOS: JP12.8, JP19.3
LCD_D1_TTL: JP20.8, TB1.37 (C1.6/VEREF+/VREF+/TA2.1/P5.6)
LCD_D2_CMOS: JP12.9, JP19.4
LCD_D2_TTL: JP20.7, TB1.36 (UCB3SIMO/SDA/TA2.3/P6.6)
LCD_D3_CMOS: JP12.10, JP19.5
LCD_D3_TTL: JP20.6, TB1.35 (UCB2SOMI/SCL/TA2.4/P6.7)
LCD_D4_CMOS: JP12.11, JP19.6
LCD_D4_TTL: JP20.5, TB1.34 (PM/UCA1SIMO/UCA1TXD/P2.3)
LCD_D5_CMOS: JP12.12, JP19.7
LCD_D5_TTL: JP20.4, TB1.33 (A4/P5.1)
LCD_D6_CMOS: JP12.13, JP19.8
LCD_D6_TTL: JP20.3, TB1.32 (PM/UCB2CLK/P3.5)
LCD_D7_CMOS: JP12.14, JP19.9
LCD_D7_TTL: JP20.2, TB1.31 (PM/UCB2SOMI/UCB2SCL/P3.7)
LCD_E_CMOS: JP12.6, JP21.4
LCD_E_TTL: JP22.7, TB1.39 (PM/TA0.3/P2.6)
LCD_RS_CMOS: JP12.4, JP21.2
LCD_RS_TTL: JP22.9, TB1.11 (PM/UCB2SIMO/UCB2SDA/P3.6)
LCD_RW_CMOS: JP12.5, JP21.3
LCD_RW_TTL: JP22.8, TB1.40 (PM/TA0.4/P2.7)
LED0: AT89C51RC2.1 (P10-T2), R4.2
LED1: AT89C51RC2.2 (P11-T2EX), R7.2
MISO: FLASH_MEMORY.3, TB1.14 (UCB0SCL/UCB0SOMI/P1.7)
MOSI: FLASH_MEMORY.2, TB1.15 (UCB0SDA/UCB0SIMO/P1.6)
unnamed: R7.1, T2.2 (B)
unnamed: LED1-D2.A, R3.1
unnamed: COUT.+, JP5.1, L2.2, R8.2, U1.4 (FEEDBACK)
unnamed: L2.1, U1.2 (OUTPUT), U$2.C
unnamed: JP2.1, JP6.3
unnamed: JP3.1, JP6.2
unnamed: R4.1, T1.2 (B)
unnamed: AT89C51RC2.19 (XTAL1), C4.1, X1.2
unnamed: AT89C51RC2.18 (XTAL2), C5.2, X1.1
unnamed: LED1-D1.A, R2.1
unnamed: LED1-D3.A, R8.1
unnamed: AT89C51RC2.29 (PSEN), JP1.2
unnamed: JP18.2, U$1.RX0
unnamed: LED1-D1.K (C), T1.3 (C)
unnamed: JP18.1, U$1.TX0
unnamed: LED1-D2.K (C), T2.3 (C)
unnamed: FLASH_MEMORY.7, JP14.1
unnamed: R5.2, SW3.1 (S)
unnamed: JP1.3, SW3.3
unnamed: JP1.1, R11.1
RST: C1.-, D1.C, JP4.1, R1.2, SW1.3
RST51_CMOS: JP4.3, JP21.8
RST51_TTL: JP22.3, TB1.5 (A12/P4.1)
RXD: AT89C51RC2.10 (P30-RXD), JP2.2
SCK_CMOS: JP7.4, JP9.2
SCK_TTL: JP8.7, JP10.3, TB1.9 (PM/UCB1SOMI/USB1SCL/P6.5)
SCLK: FLASH_MEMORY.4, TB1.7 (UCB0CLK/P1.5)
SDA_CMOS: JP7.5, JP9.3
SDA_TTL: JP8.6, JP10.2, TB1.10 (PM/UCB1/SIMO/UCB1SDA/P6.4)
SW0: AT89C51RC2.3 (P12), R10.1, SW4.1 (S)
SW1: AT89C51RC2.4 (P13), R9.1, SW2.1 (S)
TXD: AT89C51RC2.11 (P31-TXD), JP3.2
UART51_RX_CMOS: JP3.3, JP21.5
UART51_RX_TTL: JP22.6, TB1.5_20 (P9.6)
UART51_TX_CMOS: JP2.3, JP21.6
UART51_TX_TTL: JP22.5, TB1.5_21 (P9.7)
VCC: AT89C51RC2.16 (P36-WR), AT89C51RC2.17 (P37-RD), AT89C51RC2.31 (EA), AT89C51RC2.40 (VCC), C1.+, C15.1, C20.1, JP5.2, JP7.1, JP9.1, JP10.4, JP12.2, JP14.2, JP15.1, JP15.2, JP15.3, JP15.4, JP17.1, JP17.2, JP17.3, JP17.4, JP19.1, JP21.1, R2.2, R3.2, R6.1 (CCW), R9.2, R10.2, SW1.1 (S), TB1.5_33 (5V), TB1.5_34 (5V), U$1.V+
VDD: CIN.+, FLASH_MEMORY.6, J1.1, TB1.5_35 (3V3), TB1.5_36 (3V3), U1.1 (VIN)
V_RES: JP12.3, R6.S (W), R6.S@1 (W)

Notes on the sheet:
Power Supply Circuit
oscillator ckt
LED circuit
LCD
MSP432
Remote Interfacing with 8051 - Dhiraj Bennadi - Rajat Chaple

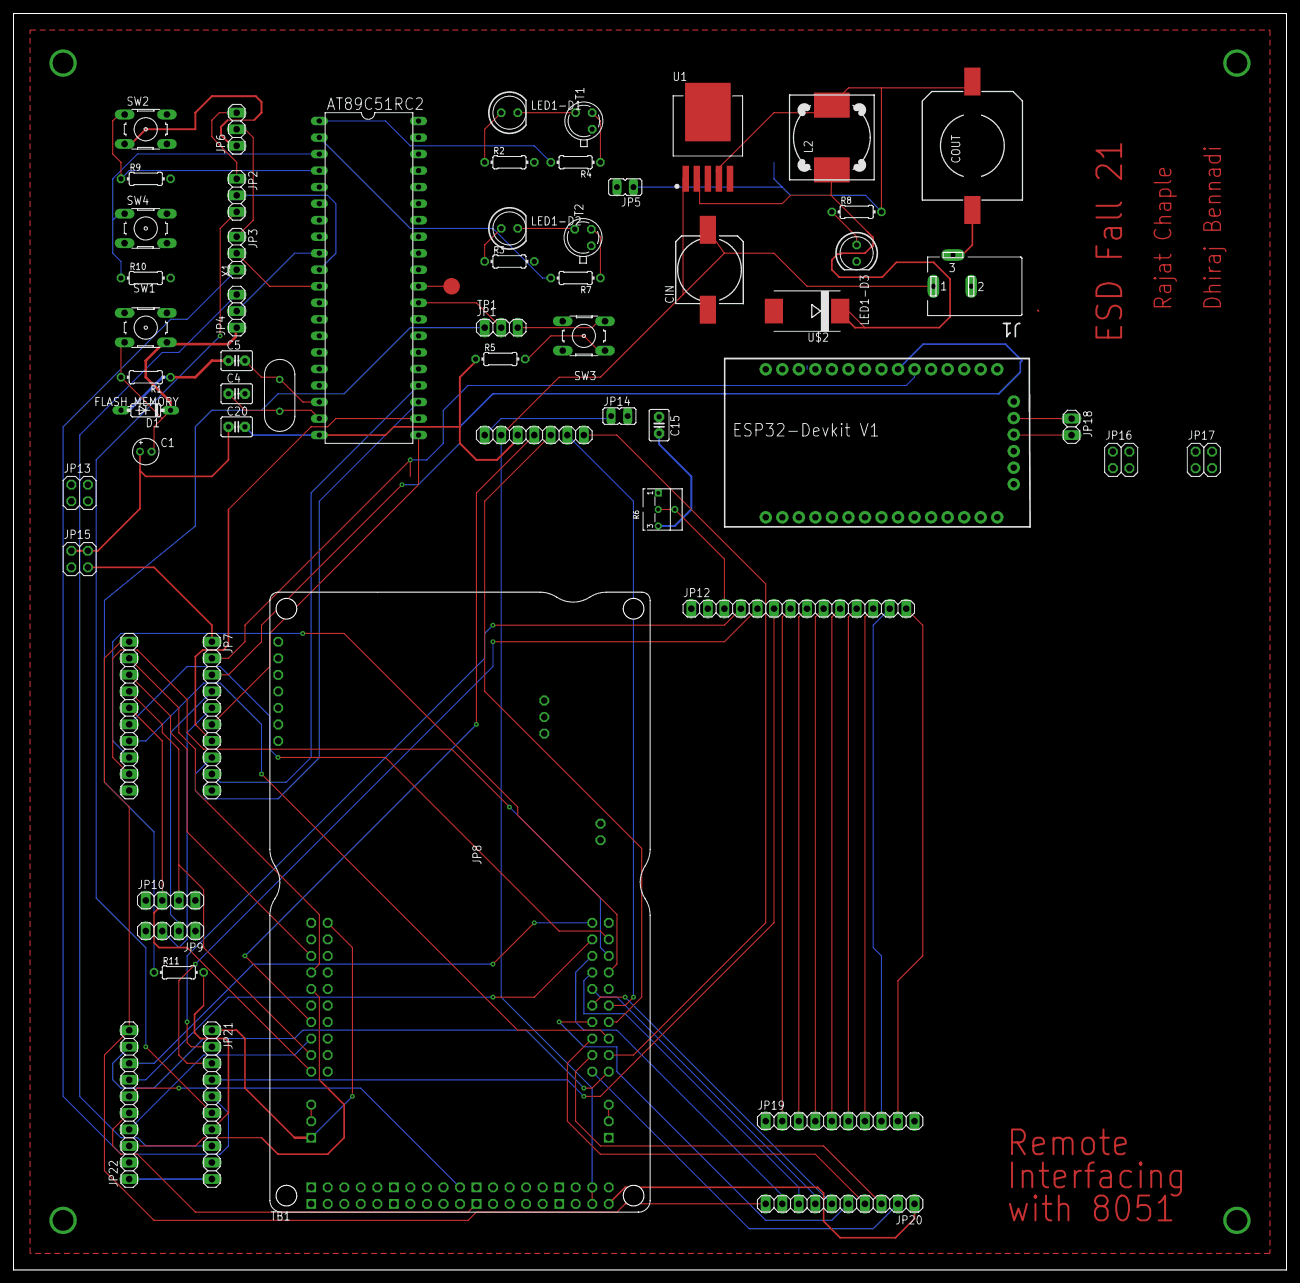
[picture p119: board esd_fall_project rev3.brd from above]

Board: 2 copper layers, 195.6 x 193.0 mm, 59 parts (0 on the bottom side), 87 nets.
