dhirajbennadi/RemoteInterfacingWith8051/Labs/Dhiraj/bennadi_lab_4/c_code_C51/binarySearch.c

/*************************************************
 * @filename : binarySearch.c
 * @author   : Dhiraj Bennadi
 * @compiler : arm
 * @IDE      : Code Blocks
 *
 * Identification of any leveraged code : Code Referenced
 * from the example given by Prof. Linden Mcclure
 * Applicable Links: None
 */

#include <stdint.h>


int binarySearch(int arr[], int l, int r, int x)
{
   if (r >= l)
   {
        int mid = l + (r - l)/2;

        // If the element is present at the middle itself
        if (arr[mid] == x)  return mid;

        // If element is smaller than mid, then it can only be present
        // in left subarray
        if (arr[mid] > x) return binarySearch(arr, l, mid-1, x);

        // Else the element can only be present in right subarray
        return binarySearch(arr, mid+1, r, x);
   }

   // We reach here when element is not present in array
   return -1;
}
