dhirajbennadi/RemoteInterfacingWith8051/Labs/Rajat/chaple_lab_3/c_code_ARM/timers.h

/*
 * timers.h
 *
 *  Created on: Oct 1, 2021
 *      Author: Rajat
 */
#ifndef TIMERS_H_
#define TIMERS_H_


#define PWM_STEP_SIZE (10)

/*----------------------------------------------------------------------------
 * This function initializes timers
 ----------------------------------------------------------------------------*/
void init_timer(void);

/*----------------------------------------------------------------------------
 * This function retrieves current PWM duty cycle on pin 7.6
 ----------------------------------------------------------------------------*/
int get_pwm_duty_cycle(void);

/*----------------------------------------------------------------------------
 * This function sets duty cycle
 ----------------------------------------------------------------------------*/
void set_pwm_duty_cycle(int);

/*----------------------------------------------------------------------------
 * This function retrieves current PWM period
 ----------------------------------------------------------------------------*/
void set_pwm_period(int period);

/*----------------------------------------------------------------------------
 * This function sets led pattern
 ----------------------------------------------------------------------------*/
void led_pattern(int r, int g, int b);

/*----------------------------------------------------------------------------
 * This functionsets delay
 ----------------------------------------------------------------------------*/
void delay();

#endif /* TIMERS_H_ */
