dhirajbennadi/RemoteInterfacingWith8051/Labs/Rajat/chaple_lab_3/c_code_C51/esd_lab3_part3_buffers/_heap.c

/*-------------------------------------------------------------------------
   _heap.c - memory heap for malloc and friends

   Copyright (C) 2006, Maarten Brock, sourceforge.brock@dse.nl

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
   As a special exception, if you link this library with other files,
   some of which are compiled with SDCC, to produce an executable,
   this library does not by itself cause the resulting executable to
   be covered by the GNU General Public License. This exception does
   not however invalidate any other reasons why the executable file
   might be covered by the GNU General Public License.
-------------------------------------------------------------------------*/

/*
   This is the default heap. If you need a different size (make a copy and)
   recompile it with -D HEAP_SIZE=<size> where <size> is whatever you need.
   Link the resulting object explicitly with your project.
*/

#ifndef HEAP_SIZE
#define HEAP_SIZE 5000 //1024
#endif

__xdata char __sdcc_heap[HEAP_SIZE];
const unsigned int __sdcc_heap_size = HEAP_SIZE;
