dhirajbennadi/RemoteInterfacingWith8051/Labs/Rajat/chaple_lab_3/c_code_C51/esd_lab3_part3_buffers/log.h

/*****************************************************************************************
 * @file log.h :
 * @brief : This file contains defines, includes, and function prototypes for log.c
 *
 * @author : Rajat Chaple (rajat.chaple@colorado.edu)
 * @date : Oct 13 2021
 *
 ******************************************************************************************/

#ifndef LOG_H_
#define LOG_H_

#define LOG(...) putstr(...)

#endif /* IRQ_H_ */
