dhirajbennadi/RemoteInterfacingWith8051/Labs/Rajat/chaple_lab_3/c_code_C51/esd_lab3_part3_pca/timers_pwm.h

/*****************************************************************************************
 * @file timers_pwm.h :
 * @brief : This file contains defines, includes, and function prototypes for uart.c
 *
 * @author : Rajat Chaple (rajat.chaple@colorado.edu)
 * @date : Oct 13 2021
 *
 ******************************************************************************************/

#ifndef TIMERS_PWM_H_
#define TIMERS_PWM_H_

#include <stdint.h>
#include <stdbool.h>


/** ------------------------------------------------------------------------------
 *  @brief      Setting up pwm with pca
 *
 * @param buf :  none
 *
 * @return none
 ---------------------------------------------------------------------------------**/
void pwm_init(void);


#endif /* TIMERS_PWM_H_ */
