dhirajbennadi/RemoteInterfacingWith8051/(notices)

Notices in the files:
Labs/Rajat/chaple_lab_3/c_code_C51/esd_lab3_part3_pca/_heap.c:
under the terms of the GNU General Public License as published by the
Free Software Foundation; either version 2, or (at your option) any
