dhirajbennadi/RemoteInterfacingWith8051/Pictures/Rajat/chaple_lab_3/20211024_181206.jpg

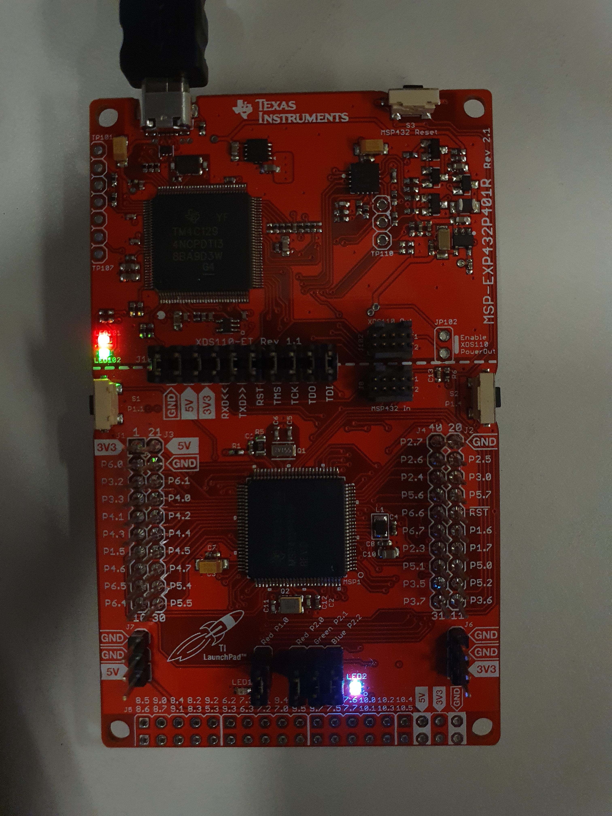
Pictures/Rajat/chaple_lab_3/20211024_181206.jpg
